sdale511/race-tracker/hardware/esp32-rover-carrier/README.md

# ESP32 rover carrier board (rev C)

A 134 × 53.34 mm, 2-layer motherboard for the ESP32 rover, laid out to fit the enclosure (the 2026-11-07 handoff).

Plugged into female sockets:
- **ArduSimple simpleRTK2B Budget (J1–J4):** XBee in its own socket, ZED UART2 off (`--role rover`), switch down.
- **Feather ESP32-S3 Reverse TFT (J5, J6):** on 8.5 mm stacking headers, display side up, USB-C at the front edge.

Soldered low on their own male headers, because there isn't height for sockets:
- **Adafruit LIS3DH (J8, J9)** and **Pololu S9V11F5 (J10):** under the ArduSimple, which leaves about 9.5 mm.
- **Adafruit bq24074 charger (J7), optional:** on 8.5 mm sockets its BATT and SYSOUT JSTs would hit the XBee's antenna plug.

The battery connects through a JST-PH socket on the back edge (J11), its plug facing the back wall.

The case for it is in [../esp32-rover-enclosure](../esp32-rover-enclosure), built from this board's `tools/layout.py`.

Everything is through-hole and hand-solderable. It replaces the loose wiring in
[docs/esp32-rover-wiring.pdf](../../docs/esp32-rover-wiring.pdf) and the harness in
[docs/esp32-rover-harness.pdf](../../docs/esp32-rover-harness.pdf).

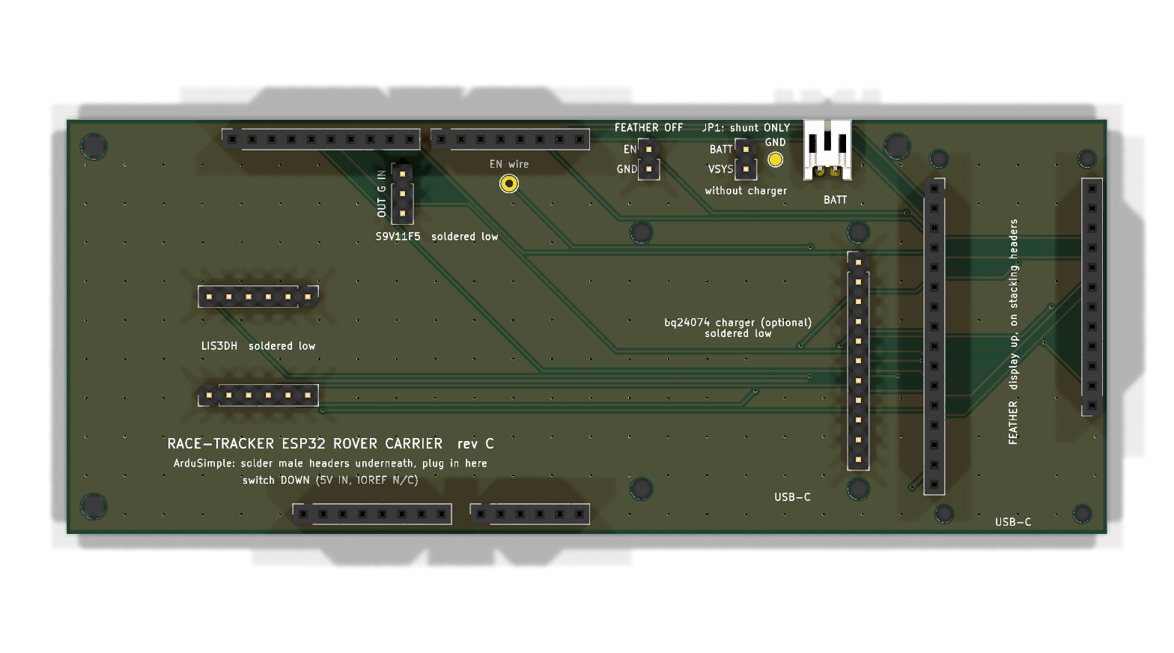
[picture p1: hardware/esp32-rover-carrier/fab/esp32-rover-carrier-top.png]
top


From left to right: the ArduSimple (with the LIS3DH and the regulator under it), then the charger, then the Feather on
its own at the right end. The XBee's RP-SMA overhangs the ArduSimple's right edge, over the charger. Nothing sits above
the Feather's display, so the enclosure can have a window over it.

Rev C against rev B, for the enclosure:

- **12.5 mm shorter** (146.5 → 134 mm): the LIS3DH moved under the ArduSimple.
- **The regulator moved under the ArduSimple**, out of the charger's way.
- **The charger is soldered low and sits 3.22 mm back from the front edge**, so its DC jack stays inside the case's
  front wall. Only the two USB-C faces reach the front edge.
- **The battery JST moved to the back edge**, plug facing the back wall; JP1, TP1 and J12 moved behind the charger.
- **H3 sits between the charger and the Feather** with no screw: a post on the lid presses it down, so keep a 5 mm
  column above it clear. H1 and H2 screw to floor posts. H16 is gone: the case's fourth lid-screw boss sits in that
  front corner.

Rev B against rev A: the Feather moved to the far right, the bq24074 turned so its USB-C faces the front edge, and the
optional connections were added.

## Files

| File | What it is |
|---|---|
| `esp32-rover-carrier.kicad_pro` / `.kicad_sch` / `.kicad_pcb` | KiCad 10 project |
| `fab/esp32-rover-carrier-gerbers.zip` | Gerbers and drill files, ready to upload to JLCPCB |
| `fab/esp32-rover-carrier-schematic.pdf`, `fab/esp32-rover-carrier-board.pdf` | For review |
| `fab/bom.csv` | Parts list |
| `tools/layout.py` | Module positions and the netlist: the one place to change |
| `tools/gen_sch.py`, `tools/gen_pcb.py` | Regenerate the schematic and the routed board from `layout.py` |

To regenerate after a change to `layout.py`:

```bash
python3 tools/gen_sch.py && ~/Applications/KiCad/KiCad.app/Contents/Frameworks/Python.framework/Versions/Current/bin/python3 tools/gen_pcb.py
```

`gen_pcb.py` places the footprints, routes every net with its own grid router, adds GND stitching vias and pours ground on
both layers. Check the result with:

```bash
~/Applications/KiCad/KiCad.app/Contents/MacOS/kicad-cli pcb drc --schematic-parity esp32-rover-carrier.kicad_pcb
```

Rev C results: 0 violations, 0 unconnected items, 0 schematic-parity issues. The only warnings say that KiCad's library
tables aren't set up on this machine, and that the battery JST's outline meets the back edge (on purpose).

## Connections

| Net | Joins |
|---|---|
| GPS_TX | ArduSimple D0 (TX1) → Feather RX (GPIO 38) |
| GPS_RX | Feather TX (GPIO 39) → ArduSimple D1 (RX1) |
| XB_DOUT | ArduSimple D2 (XBEE TX / GPS RX2) → Feather D5 |
| XB_DIN | Feather D6 → ArduSimple D8 (XBEE RX / GPS TX2) |
| 3V3 | Feather 3V (both pins) → ArduSimple IOREF |
| 5V | S9V11F5 VOUT → ArduSimple 5V IN/OUT |
| VSYS | Feather BAT, S9V11F5 VIN, LIS3DH VIN, bq24074 OUT, JP1 pin 2 |
| BATT | Battery JST +, bq24074 VLIPO, JP1 pin 1 |
| SCL, SDA | Feather SCL/SDA ↔ LIS3DH SCL/SDA |
| ACC_INT | LIS3DH INT1 → Feather D10 |
| CHG_N, PGOOD_N | bq24074 ~CHG → Feather D11, ~PGOOD → Feather D12 (open drain; the firmware doesn't read them yet) |
| GND | Everything, plus both copper pours |

The firmware pins are unchanged (`feather_s3_reversetft_socket` build).

### Optional connections

These are wired but not used by the firmware yet, except `GPS_POWER_PIN`, which already exists as a build flag.
[OPTIONAL-CONNECTIONS.md](OPTIONAL-CONNECTIONS.md) explains what each one gives and what it would take to use it.

| Net | Joins | Use |
|---|---|---|
| GPS_EN | Feather A0 (GPIO 18) → pad TP2 | Wire TP2 to the S9V11F5's EN pad, then build with `-DGPS_POWER_PIN=18`. Deep sleep then cuts the ArduSimple and the XBee (about 20–50 mA saved overnight). The GPS loses its almanac unless V_BCKP is supplied, so expect slower fixes after a sleep. |
| GPS_PPS | ArduSimple D13 (TIMEPULSE) → Feather A1 (GPIO 17) | The ZED's 1 PPS edge, for exact timing |
| GPS_EXTINT | Feather A2 (GPIO 16) → ArduSimple D12 (EXTINT) | A hardware wake or time mark for the ZED |
| CHG_DIS | Feather A3 (GPIO 15) → bq24074 ~CE | High stops charging. The bq's 10 kΩ pull-down keeps charging on while the pin floats. |
| ACC_INT2 | LIS3DH INT2 → Feather A4 (GPIO 14) | A second accelerometer interrupt. It's an RTC GPIO, so it can wake the board. |
| FEATHER_EN | Feather EN → J12 pin 1 (pin 2 GND) | Short J12 to switch the Feather off. The regulator and ArduSimple stay on battery power. For a true off switch without a charger, put the switch on JP1 instead of the shunt. |

Feather D9, D13, A5, SCK, MOSI and MISO are still free. The ZED's I2C isn't wired.

There are two differences from the hand wiring:

- **The LIS3DH runs from VSYS, not the Feather's 3V.** The breakout has its own 3.3 V regulator. This shortens the wiring,
  and VSYS stays on in deep sleep, so motion wake still works.
- **The S9V11F5 has no EN pin.** It has only VIN, GND and VOUT; its enable is a small solder pad on the module (Pololu's drawing shows only the three holes). That's why
  GPS_EN goes to a wire pad (TP2) rather than to the socket.

## Battery and charger: JP1

- **No bq24074 fitted:** put the shunt on JP1. The battery feeds VSYS directly, as it does now.
- **bq24074 fitted:** remove the shunt. The battery feeds the charger, and the charger's OUT feeds VSYS. Charge it through
  the bq24074's USB-C on the front edge.

Never fit both. With both in place, the shunt bypasses the charger's battery control. JP1 sits behind the charger, on
the back edge beside the battery JST. The charger's own BATT and SYSOUT JSTs stay empty: the battery and VSYS go
through its 11-pin header (VLIPO pin 2, OUT pin 4).

## Check before ordering

1. **Print the board at 100 % and press the modules' pins into the paper.**
   - Print `fab/esp32-rover-carrier-fitcheck.pdf` at 100 % ("Actual size"). It shows the outlines, pads and real drill
     holes with no copper pour. The board outline should measure 134 × 53.34 mm.
   - The ArduSimple's header pattern is the Arduino Uno R3 layout. I measured it against ArduSimple's pinout image, not a
     drawing.
   - The Feather, LIS3DH and bq24074 positions come from Adafruit's own board files.
2. **Check the S9V11F5 pin order on your module.** The board expects VIN, GND (square pad), VOUT. VOUT is the pin the
   "VOUT→" arrow on the module points to.
3. **Check that your LIS3DH matches the 2809 pinout:**
   - The VIN, 3Vo, GND, SCL, SDA, INT1 row is 0.5" from the CS, SDO, ADC1–3, INT2 row.
   - The board is 0.7 × 1.0".
4. **Check clearance under the ArduSimple.** The case expects about 9.5 mm between the carrier and the ArduSimple's
   underside. Under it are the LIS3DH and the S9V11F5, each soldered on a 2.5 mm header (about 5 mm tall in all), plus
   the heads of two M3 case screws (H1, H2). Fit those screws before the ArduSimple goes on.
5. **Check that the charger stays under the XBee's antenna plug.** Soldered low, its JST bodies top out about 10 mm
   above the carrier; the case puts the plug about 14 mm up. These heights are the enclosure's estimates.

## Assembly

1. If you want the GPS power cut, solder the EN wire to the S9V11F5's EN pad first (see OPTIONAL-CONNECTIONS.md).
2. Solder male headers pins-down onto the LIS3DH (both rows), the bq24074 (the 11-pin edge) and the S9V11F5, and
   solder each module straight into the carrier, its header's plastic flat on the board. Fit the charger's four M2.5
   standoffs (2.5 mm, H4–H7) first: it hangs off one header row.
3. Solder the female sockets onto the carrier (8.5 mm tall) for the ArduSimple and the Feather, then the JST, JP1 and
   (optional) J12. Solder male headers pins-down onto the ArduSimple: 10 + 8 on the top edge, 8 + 6 on the bottom edge.
4. Solder 8.5 mm stacking headers (a 1x16 and a 1x12) to the Feather instead of its male headers. The housings go on
   the display side, along both long edges, and the long tails come out underneath.
5. Plug in the modules. The Feather's tails go into J5 and J6, display up, with USB-C at the front edge.
   - The Feather sits higher than the other modules: the carrier socket, plus the length of tail left showing.
   - Measure that height before cutting standoffs for the optional M2 hold-downs (H12–H15).
   - Check that the stacking housings line up with the lid window, as the case expects.

## Ordering (JLCPCB)

Upload `fab/esp32-rover-carrier-gerbers.zip` with these settings:

- 2 layers, 1.6 mm FR-4, 1 oz copper.
- HASL finish.
- Any solder mask colour.
- Size 134 × 53.34 mm.

Every track and clearance is at least 0.2 mm, well inside the standard process.

### Having JLCPCB solder the connectors

JLCPCB can fit the parts that go on the carrier itself: the six female sockets (J1–J6), the battery JST (J11) and the
two 2-pin headers (JP1, J12). That's 66 joints. You then solder only the charger, LIS3DH and S9V11F5 (soldered low,
J7–J10), plus the headers on the ArduSimple and the Feather.

1. Turn on **PCB Assembly** and pick **Standard** (Economic doesn't do through-hole). Assemble the **top side**.
2. Upload `fab/jlcpcb/bom.csv` and `fab/jlcpcb/cpl.csv`.
3. Check the parts it matches against this list (all were in stock on 2026-11-07):

   | Ref | Part | LCSC |
   |---|---|---|
   | J1 | Female header 1x10, 8.5 mm (Kinghelm KH-2.54FH-1X10P-H8.5) | C2905418 |
   | J2, J3 | Female header 1x08, 8.5 mm (KH-2.54FH-1X8P-H8.5) | C2905417 |
   | J4 | Female header 1x06, 8.5 mm (KH-2.54FH-1X6P-H8.5) | C2905416 |
   | J5 | Female header 1x16, 8.5 mm (KH-2.54FH-1X16P-H8.5) | C2905421 |
   | J6 | Female header 1x12, 8.5 mm (KH-2.54FH-1X12P-H8.5) | C2905419 |
   | J11 | JST S2B-PH-K-S, right angle | C173752 |
   | JP1, J12 | Male header 1x02, 2.54 mm | C32713268 |

4. **In the placement preview, check the battery JST (J11)**: its opening must face the board's **back edge** (away
   from the USB-C side), next to the "BATT" label. If it shows facing inwards, rotate it 180° there. The sockets and
   headers are symmetrical, so their rotation doesn't matter.
5. J7–J10, TP1, TP2 and the holes aren't in the files: they stay empty for you. The JP1 shunt isn't fitted; add one
   only if there's no charger.

To regenerate the two files after a board change, run
`~/Applications/KiCad/KiCad.app/Contents/Frameworks/Python.framework/Versions/Current/bin/python3 tools/gen_jlc.py`.
Positions are each part's pad centre, in the same coordinates as the Gerbers.
