sdale511/race-tracker/hardware/esp32-rover-carrier/fab/esp32-rover-carrier-schematic.pdf

1 | 2 | 3 | 4 | 5 | 6 | 7 | 8
1 | 2 | 3 | 4 | 5 | 6 | 7 | 8

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
Size: A3 | Rev: C | F Date:
KiCad E.D.A. 10.0.8 | Id: 1/1

### Title: ESP32 rover carrier

File: esp32-rover-carrier.kicad_sch

Sheet: /

race-tracker

Feather S3 Reverse TFT, ArduSimple Budget, LIS3DH, S9V11F5, optional bq24074

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
ArduSimple SCL..D8

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
bq24074 (soldered) | 1
| 2

J11 Battery JST-PH

1
2
3
4
5
6

J8

LIS3DH (soldered) 1

2
3
4
5
6

J9

LIS3DH (soldered, support) 1

2
3

J10

S9V11F5 (soldered)

1
2

JP1 Charger bypass: shunt only without bq24074

# TP1 GND

TP2 GPS_EN wire to S9V11F5 EN

1
2
3
4
5
6

J4

ArduSimple A0..A5

1
2

J12

Feather off: short EN to GND

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
ArduSimple power

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
Feather left 1
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
ArduSimple D7..D0

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
Feather right | BATT FEATHER_EN

VSYS CHG_N

XB_DIN | BATT GND

PGOOD_N

GND
SCL FEATHER_EN

VSYS

3V3

3V3 GND

GPS_EN

XB_DIN

# SDA CHG_DIS PGOOD_N

XB_DOUT GPS_RX GPS_TX | GND

GPS_PPS

3V3 | GPS_EXTINT CHG_DIS

ACC_INT2

XB_DOUT | ACC_INT CHG_N

VSYS GND

BATT SCL 5V GND

GND

VSYS GND

ACC_INT2

GPS_TX GPS_RX

VSYS GND

5V

ACC_INT | GND

GND

SDA | GPS_EN

GPS_EXTINT

GND

GPS_PPS | -

SDA

VSYS D7 | +

RX/GPIO38

TX/GPIO39

### SCL VIN

3Vo GND

VBUS GND

THERM

CS

ISET

INT2

SDO

ADC1

ADC2

ADC3

~CE

~PGOOD

~CHG OUT GND

VOUT

VLIPO

VIN

GND

GND J12: short EN to GND to switch the Feather off (the regulator and ArduSimple stay on battery power).

GPS_EN: Feather A0 to pad TP2; wire TP2 to the S9V11F5 EN pad. Build with -DGPS_POWER_PIN=18 to cut the GPS and XBee in deep sleep.

SDA
INT1 Optional, unused by the firmware so far: TIMEPULSE -> A1, EXTINT <- A2, bq ~CE <- A3 (high stops charging; 10k pull-down on the bq), LIS3DH INT2 -> A4.

Feather on 8.5 mm stacking headers (housings on the display side), tails into J5/J6; display up, USB-C at the front. LIS3DH runs from VSYS (its own 3.3 V regulator).

The ArduSimple and the Feather plug into sockets; the LIS3DH, S9V11F5 and bq24074 are soldered low on their own headers. Nets join by label name. | GND ~CHG and ~PGOOD are open drain to Feather D11 / D12 (read with INPUT_PULLUP); the firmware does not use them yet.

No bq24074 -> fit the JP1 shunt (BATT to VSYS). Never both: the shunt would bypass the charger.

bq24074 optional: fitted -> JP1 open, battery feeds the charger, charger OUT feeds VSYS.

EN ArduSimple: male headers soldered underneath; power switch DOWN (5V IN, IOREF N/C); --role rover (UART2 off). A4

## TXD0 MISO MOSI SCK

A5

A3

A2

A1

# A0/WT GND

GND

A5/GPIO8

A4/GPIO14

A3/GPIO15

A2/GPIO16

A1/GPIO17

A0/GPIO18 RST GND

3V3V

VIN

5V_IN/OUT 3V3 RESET

IOREF NC

D1/RX1 D2/XBEE_TX D3D4 | BAT EN

USB

D13 D12 D5D6D0/TX1

SDA SCL | D9D11 D10

AREF GND

D9D10 D8/XBEE_RX D11/GEOFENCE D12/EXTINT D13/TPS | D6D5
SCL | BATT
