sdale511/race-tracker/data/IMG_1962 Medium.jpeg

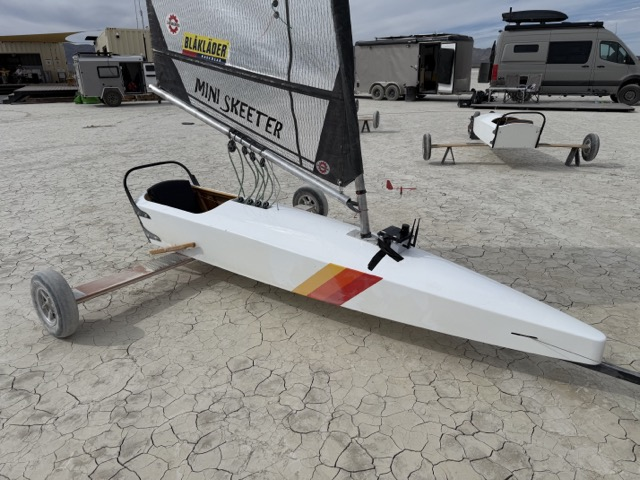
data/IMG_1962 Medium.jpeg
