sdale511/race-tracker/hardware/esp32-rover-carrier/fab/bom.csv

Ref | Qty | Part | Notes
J1 | 1 | Female header 1x10, 2.54 mm, 8.5 mm tall | ArduSimple SCL..D8 (Uno R3 pattern)
J2,J3 | 2 | Female header 1x08, 2.54 mm, 8.5 mm tall | ArduSimple D7..D0, power header
J4 | 1 | Female header 1x06, 2.54 mm, 8.5 mm tall | ArduSimple A0..A5
J5 | 1 | Female header 1x16, 2.54 mm, 8.5 mm tall | Feather left row
J6 | 1 | Female header 1x12, 2.54 mm, 8.5 mm tall | Feather right row
J11 | 1 | JST S2B-PH-K-S (PH 2.0 mm, right angle, through hole) | Battery on the back edge; pin 1 GND | pin 2 + (same as the Feather's)
JP1 | 1 | Male header 1x02, 2.54 mm + 2.54 mm shunt | Shunt ONLY when no bq24074 is fitted
J12 | 1 | Male header 1x02, 2.54 mm (optional) | Feather off: EN and GND; a switch or a shunt shorts them
TP2 | 1 | Thin insulated wire, about 30 mm (optional) | From pad TP2 to the S9V11F5's EN pad; with -DGPS_POWER_PIN=18
H1,H2 | 2 | M3 x 8 self-tapping screw | Carrier to the case's floor posts; H3 has no screw: a lid post presses it down
H4-H7 | 4 | M2.5 standoff, 2.5 mm + screw | bq24074 hold-downs (it hangs off one header row)
H12-H15 | 4 | M2 standoff + screw (optional) | Feather hold-downs; measure the Feather's height on its stacking headers first
- | 1 | Male header 1x10, 2x 1x08, 1x06, 2.54 mm | Soldered underneath the ArduSimple, pins down
J7,J8,J9,J10 | 1 | Male header 1x11, 2x 1x06, 1x03 | Soldered to the bq24074, LIS3DH and S9V11F5, pins down, then straight into the carrier (no sockets)
- | 1 | Stacking headers 1x16 + 1x12, 2.54 mm, 8.5 mm housing (Adafruit 2830 or similar) | Soldered to the Feather: housings on the display side, tails into J5/J6
Module | 1 | Adafruit ESP32-S3 Reverse TFT Feather (5691) | Its own male headers aren't used
Module | 1 | ArduSimple simpleRTK2B Budget | XBee in its own socket; switch DOWN; --role rover
Module | 1 | Adafruit LIS3DH breakout (2809)
Module | 1 | Pololu S9V11F5 (2836)
Module | 1 | Adafruit bq24074 charger (4755) | Optional
PCB | 1 | 134 x 53.34 mm, 2 layers, 1.6 mm FR4, 1 oz, HASL | fab/esp32-rover-carrier-gerbers.zip
