sdale511/race-tracker/hardware/esp32-rover-enclosure/cad/AS-RTK2B-F9P-L1L2-NH-03-R00.step

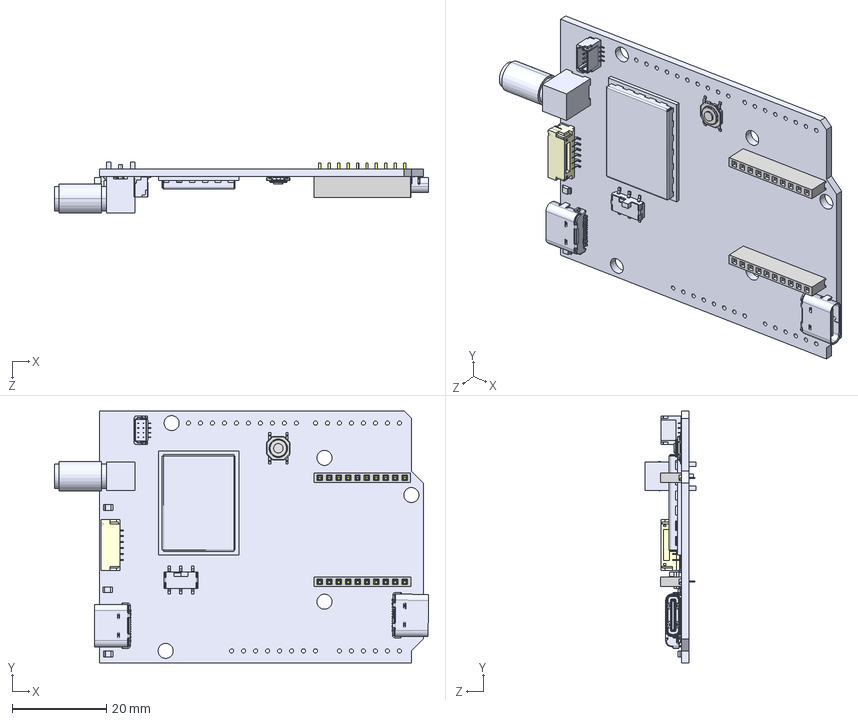
[picture p10: CAD file, 2026-11-07]
hardware/esp32-rover-enclosure/cad/AS-RTK2B-F9P-L1L2-NH-03-R00.step
79.2 x 53.3 x 10.9 mm
pcb
0805_LED_7012X1--3DModel-STEP-1.step x 3
AYZ0202AGRLC--3DModel-STEP-56544.step
BM04B-SRSS-TB-LF--SN---3DModel-STEP-56544.step
C-63-01-10-SV.stp x 2
MMS-110-01-SV_socket.stp x 2
SM06B-GHS-TB(LF)(SN)--3DModel-STEP-56544.step
SMA-long-thread.step
SMD_SWITCH_TL3342F160QG--3DModel-STEP-520916.step
USB4105.STEP x 2
ZED-F9P-00B-02--3DModel-STEP-56544.step
