sdale511/race-tracker/hardware/esp32-rover-enclosure/print/rover_case_base.stl

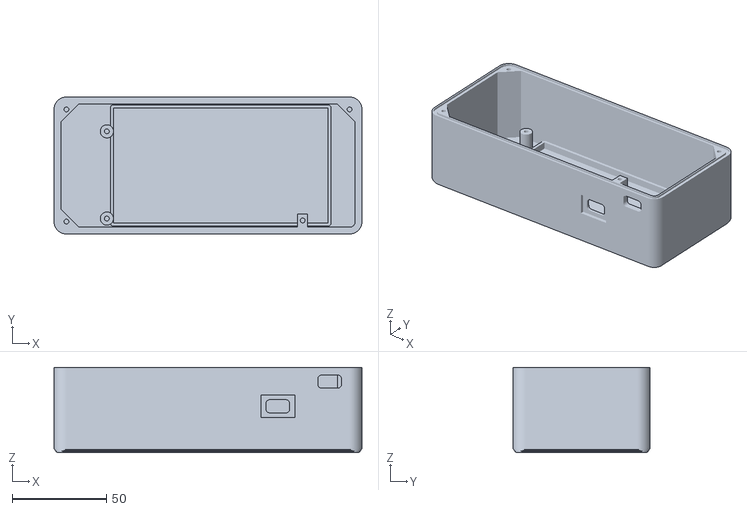
[picture p11: CAD file, 2026-11-07]
hardware/esp32-rover-enclosure/print/rover_case_base.stl
163.7 x 72.8 x 45.4
