sdale511/race-tracker/hardware/esp32-rover-enclosure/print/TPU_usbc_dust_plug.stl

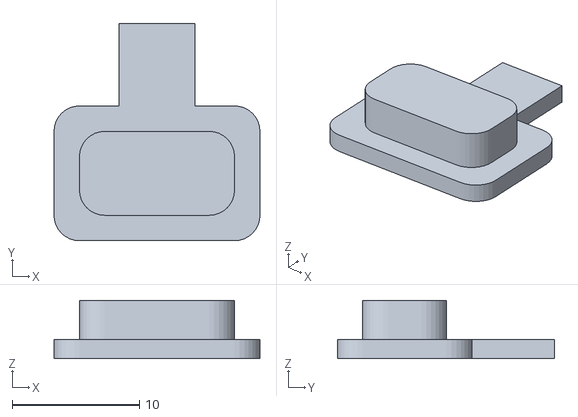
[picture p12: CAD file, 2026-11-07]
hardware/esp32-rover-enclosure/print/TPU_usbc_dust_plug.stl
16.2 x 17.1 x 4.60
