sdale511/race-tracker/hardware/esp32-rover-enclosure/print/TPU_rover_keypad.stl

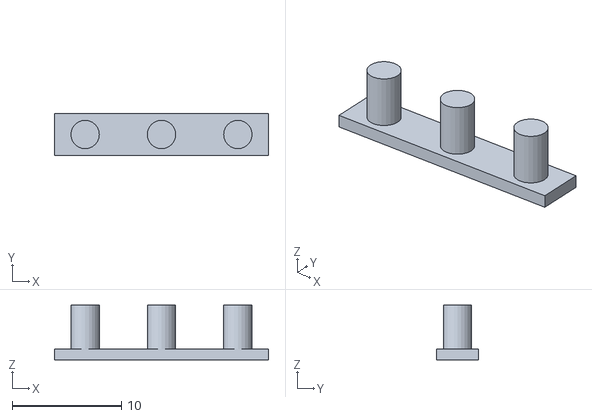
[picture p13: CAD file, 2026-11-07]
hardware/esp32-rover-enclosure/print/TPU_rover_keypad.stl
19.6 x 3.80 x 5.03
