sdale511/race-tracker/data/range-test-image.png

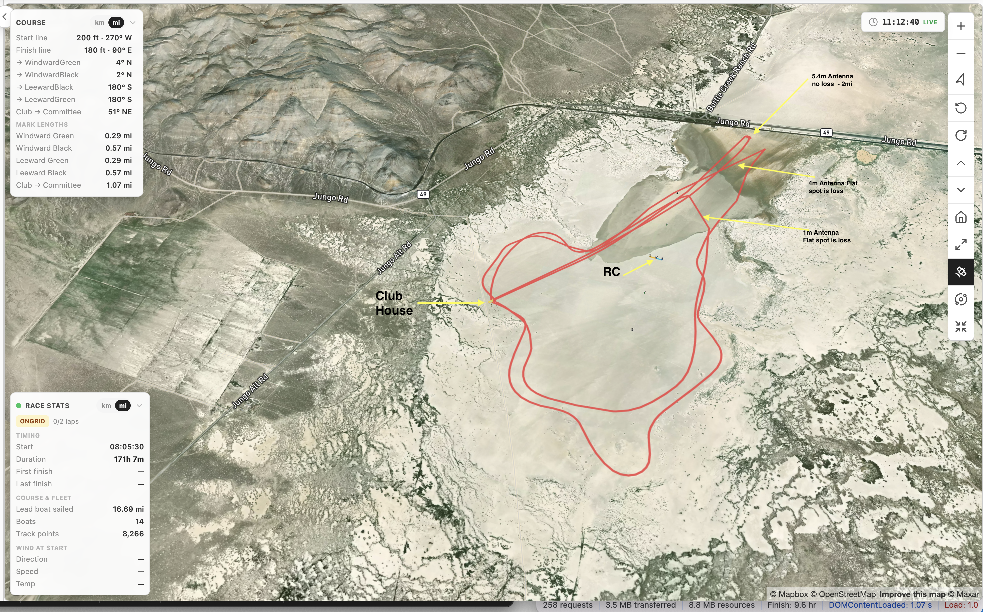
data/range-test-image.png
