sdale511/race-tracker/hardware/esp32-rover-carrier/fab/esp32-rover-carrier-board.pdf

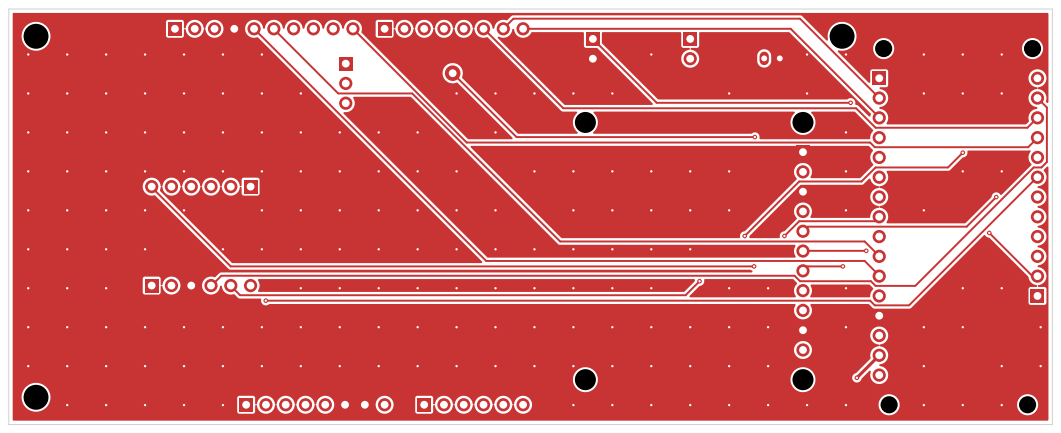
[picture p17: page 1]

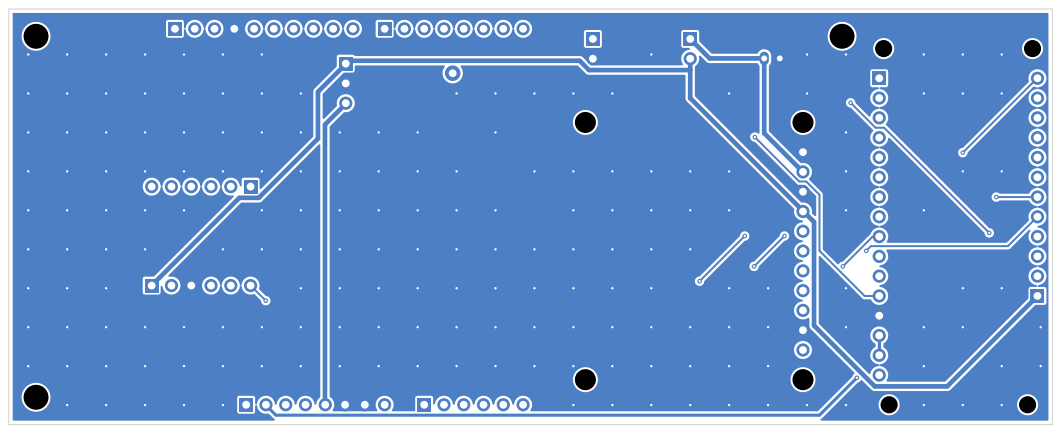
[picture p18: page 2]

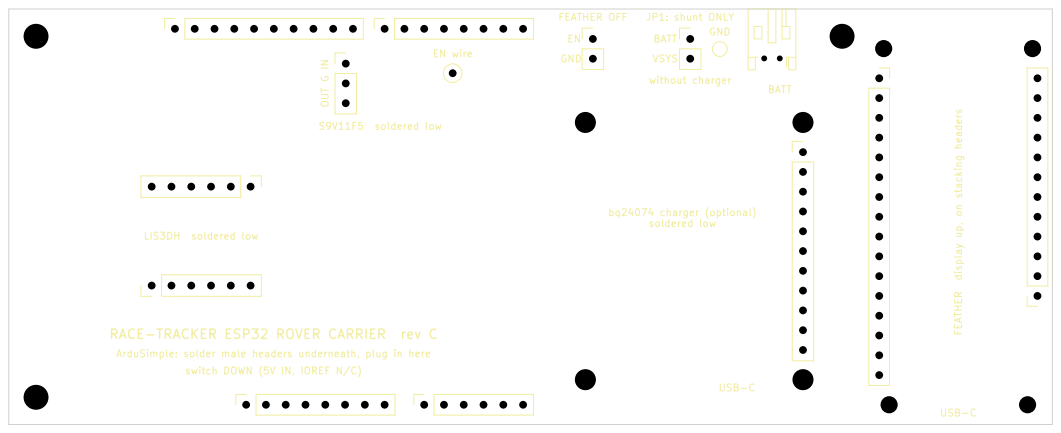
[picture p19: page 3]

JP1: shunt ONLY without charger GNDUSB-C

switch DOWN (5V IN, IOREF N/C) S9V11F5 soldered low

bq24074 charger (optional) soldered low

RACE-TRACKER ESP32 ROVER CARRIER rev C
ArduSimple: solder male headers underneath, plug in here

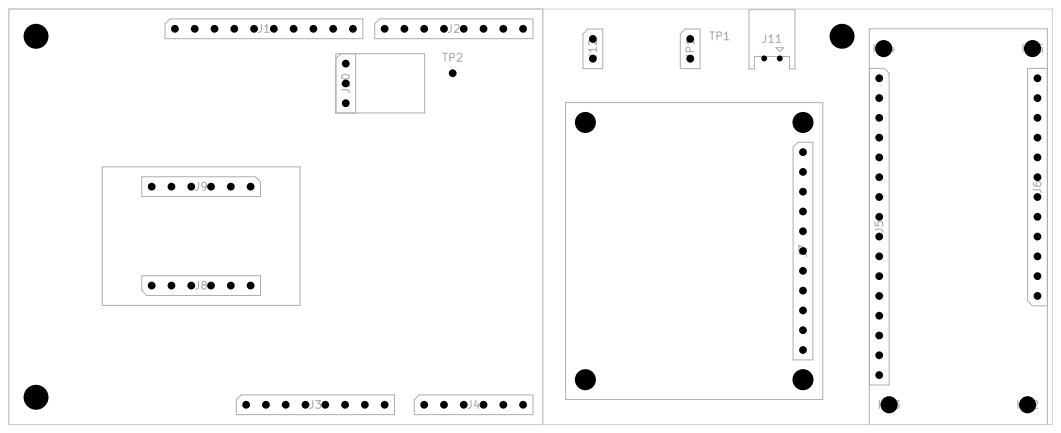
[picture p20: page 4]
