sdale511/race-tracker/hardware/esp32-rover-carrier/fab/esp32-rover-carrier-fitcheck.pdf

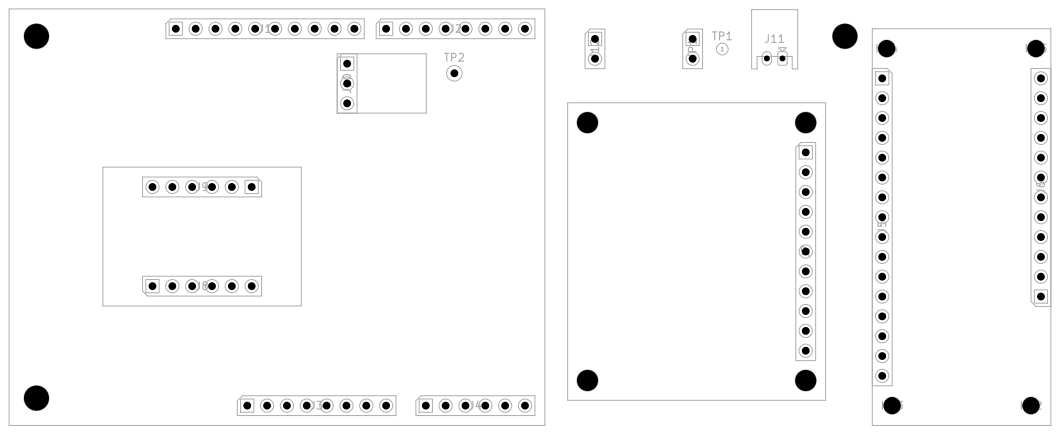
[picture p21: page 1]
