sdale511/race-tracker/hardware/esp32-rover-carrier/esp32-rover-carrier.kicad_pcb

## KiCad design hardware/esp32-rover-carrier/esp32-rover-carrier.kicad_pcb (2026-11-07)

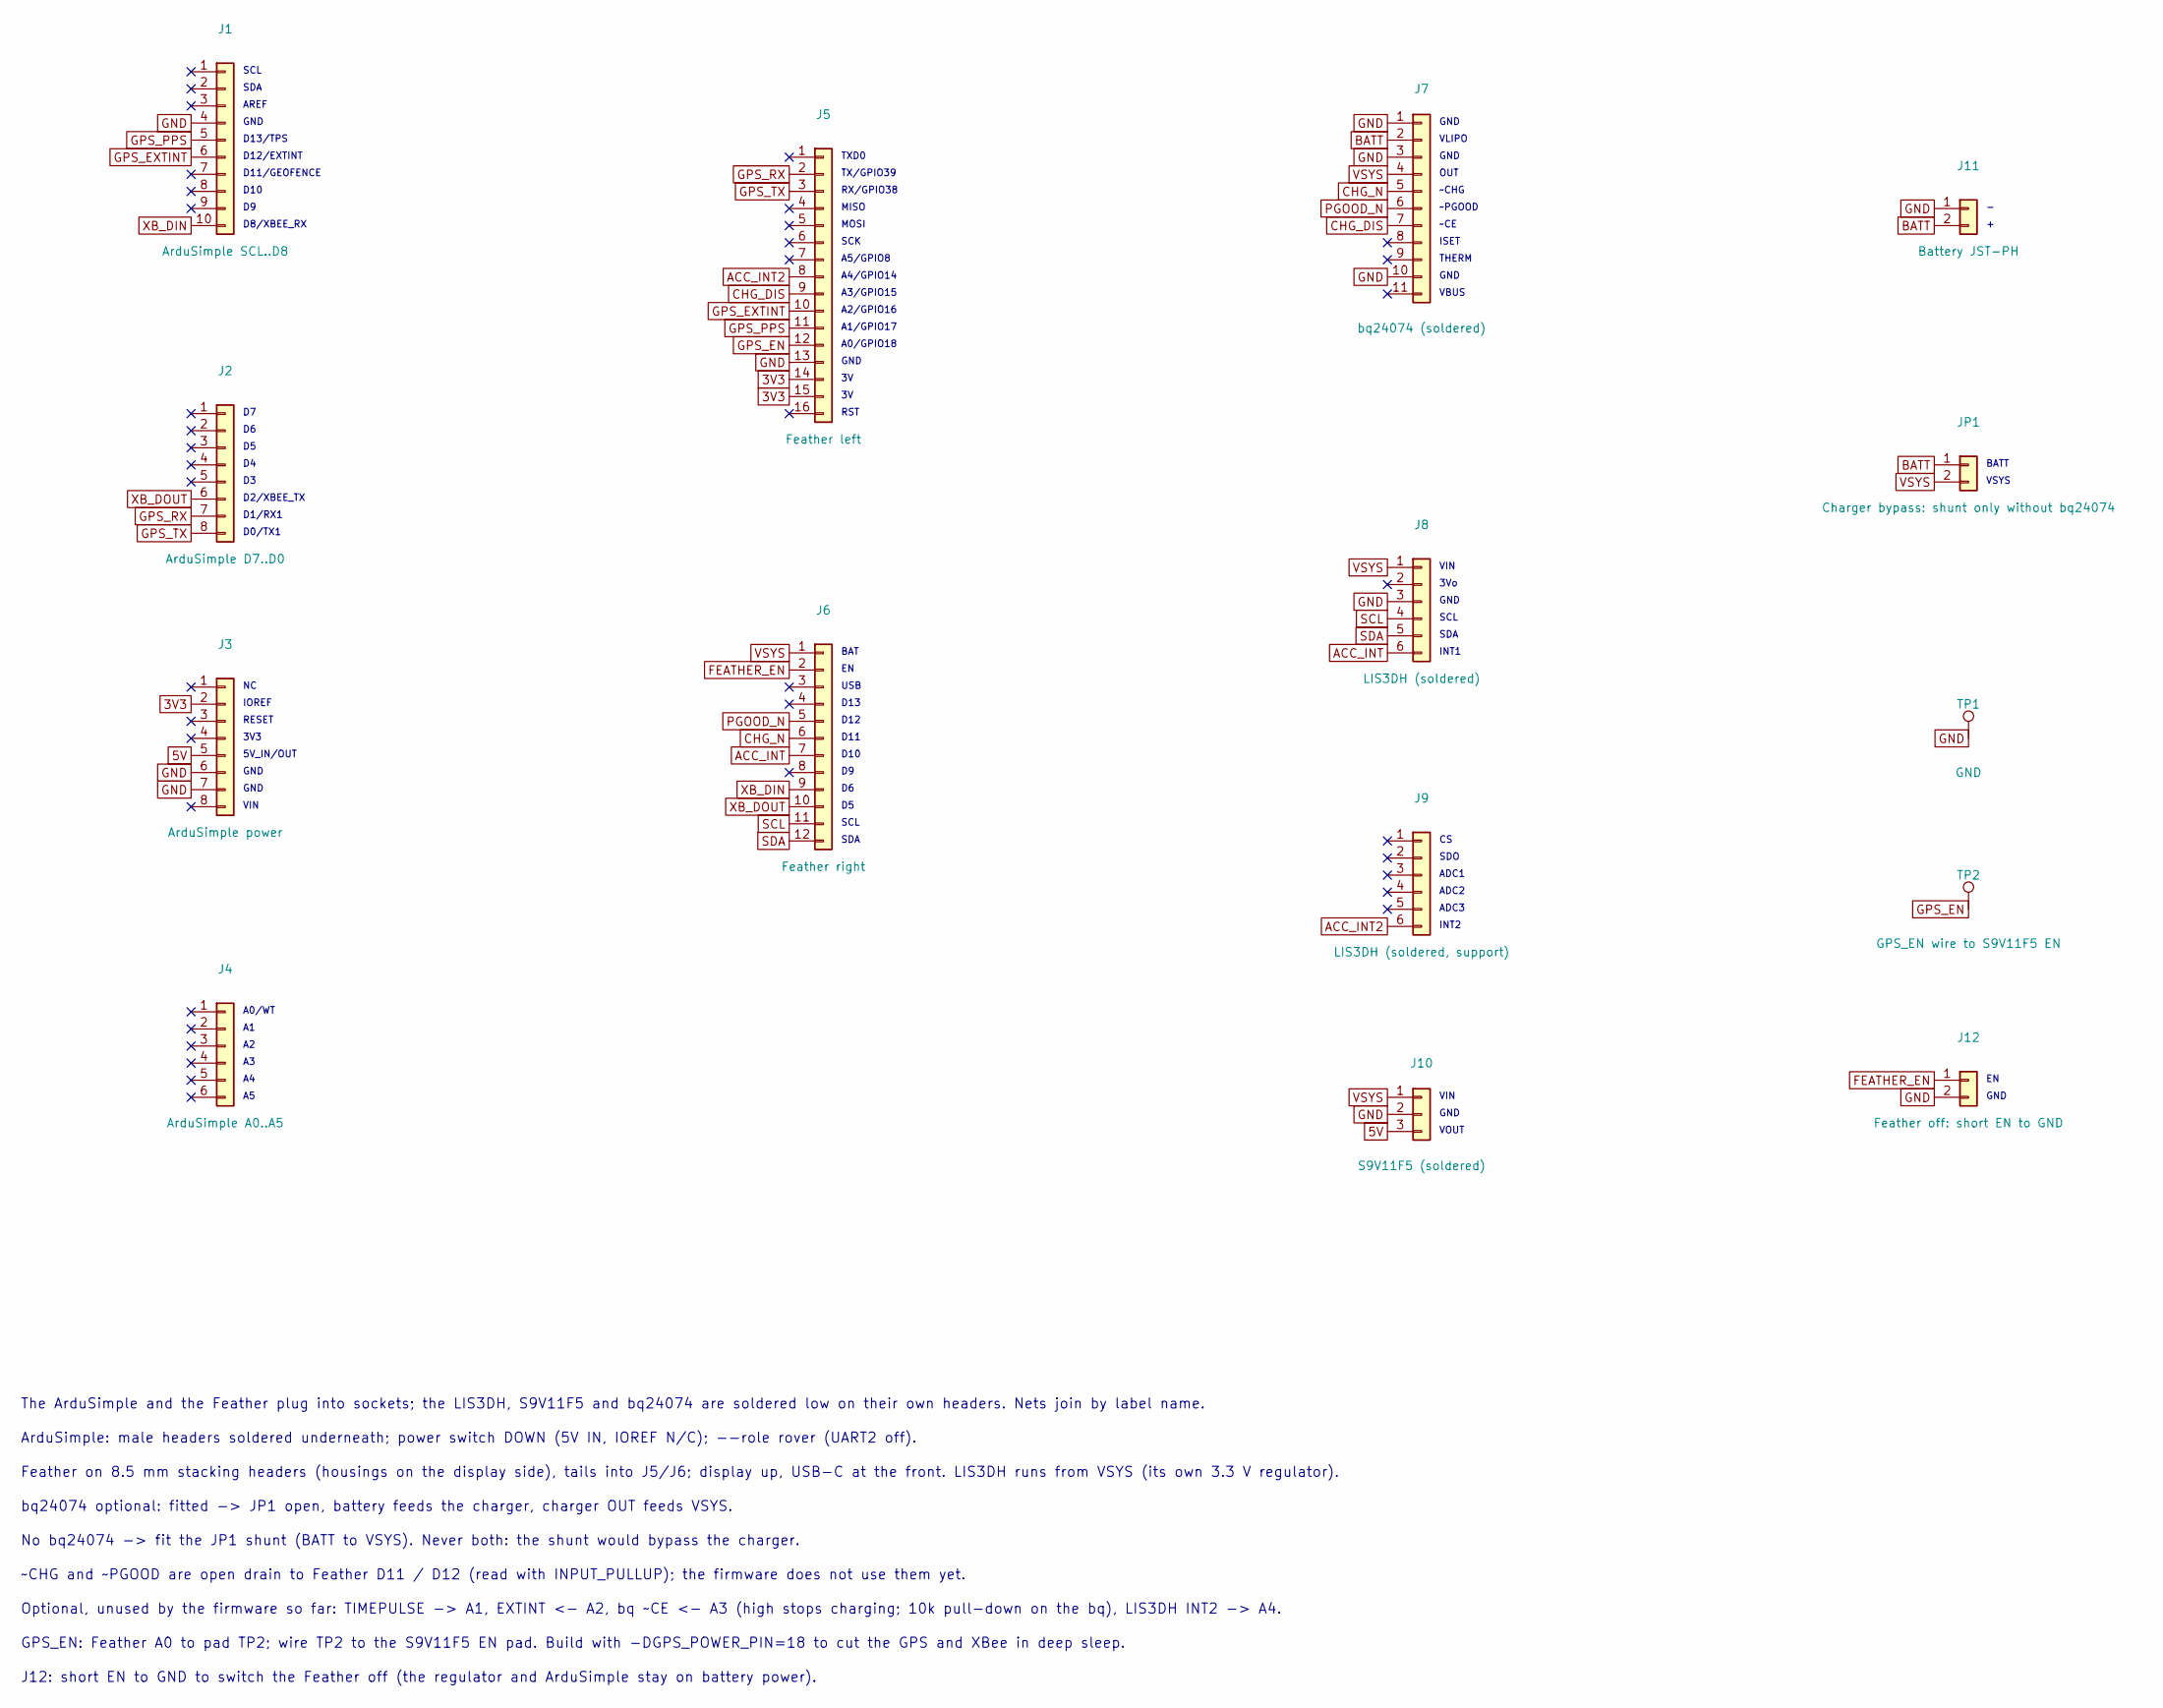
[picture p22: schematic esp32-rover-carrier.kicad_sch, ESP32 rover carrier]

Parts:
J1: ArduSimple SCL..D8; PinSocket_1x10_P2.54mm_Vertical
J2: ArduSimple D7..D0; PinSocket_1x08_P2.54mm_Vertical
J3: ArduSimple power; PinSocket_1x08_P2.54mm_Vertical
J4: ArduSimple A0..A5; PinSocket_1x06_P2.54mm_Vertical
J5: Feather left; PinSocket_1x16_P2.54mm_Vertical
J6: Feather right; PinSocket_1x12_P2.54mm_Vertical
J7: bq24074 (soldered); PinHeader_1x11_P2.54mm_Vertical
J8: LIS3DH (soldered); PinHeader_1x06_P2.54mm_Vertical
J9: LIS3DH (soldered, support); PinHeader_1x06_P2.54mm_Vertical
J10: S9V11F5 (soldered); PinHeader_1x03_P2.54mm_Vertical
J11: Battery JST-PH; JST_PH_S2B-PH-K_1x02_P2.00mm_Horizontal
J12: Feather off: short EN to GND; PinHeader_1x02_P2.54mm_Vertical
JP1: Charger bypass: shunt only without bq24074; PinHeader_1x02_P2.54mm_Vertical
TP1: GND; TestPoint_Pad_D1.5mm
TP2: GPS_EN wire to S9V11F5 EN; TestPoint_THTPad_D2.0mm_Drill1.0mm

Connections:
3V3: J3.2, J5.14, J5.15
5V: J3.5, J10.3
ACC_INT: J6.7, J8.6
ACC_INT2: J5.8, J9.6
BATT: J7.2, J11.2, JP1.1
CHG_DIS: J5.9, J7.7
CHG_N: J6.6, J7.5
FEATHER_EN: J6.2, J12.1
GND: J1.4, J3.6, J3.7, J5.13, J7.1, J7.3, J7.10, J8.3, J10.2, J11.1, J12.2, TP1.1
GPS_EN: J5.12, TP2.1
GPS_EXTINT: J1.6, J5.10
GPS_PPS: J1.5, J5.11
GPS_RX: J2.7, J5.2
GPS_TX: J2.8, J5.3
PGOOD_N: J6.5, J7.6
SCL: J6.11, J8.4
SDA: J6.12, J8.5
VSYS: J6.1, J7.4, J8.1, J10.1, JP1.2
XB_DIN: J1.10, J6.9
XB_DOUT: J2.6, J6.10

Notes on the sheet:
SCL
SDA
AREF
GND
D13/TPS
D12/EXTINT
D11/GEOFENCE
D10
D8/XBEE_RX
D2/XBEE_TX
D1/RX1
D0/TX1
IOREF
RESET
3V3
5V_IN/OUT
VIN
A0/WT
VLIPO
OUT
~CHG
~PGOOD
~CE
ISET
THERM
VBUS
3Vo
INT1
SDO
ADC1
ADC2
ADC3
INT2
VOUT
TXD0
TX/GPIO39
RX/GPIO38
MISO
MOSI
SCK
A5/GPIO8
A4/GPIO14
A3/GPIO15
A2/GPIO16
A1/GPIO17
A0/GPIO18
RST
BAT
USB
D13
D12
D11
BATT
VSYS
The ArduSimple and the Feather plug into sockets; the LIS3DH, S9V11F5 and bq24074 are soldered low on their own headers. Nets join by label name.
ArduSimple: male headers soldered underneath; power switch DOWN (5V IN, IOREF N/C); --role rover (UART2 off).
Feather on 8.5 mm stacking headers (housings on the display side), tails into J5/J6; display up, USB-C at the front. LIS3DH runs from VSYS (its own 3.3 V regulator).
bq24074 optional: fitted -> JP1 open, battery feeds the charger, charger OUT feeds VSYS.
No bq24074 -> fit the JP1 shunt (BATT to VSYS). Never both: the shunt would bypass the charger.
~CHG and ~PGOOD are open drain to Feather D11 / D12 (read with INPUT_PULLUP); the firmware does not use them yet.
Optional, unused by the firmware so far: TIMEPULSE -> A1, EXTINT <- A2, bq ~CE <- A3 (high stops charging; 10k pull-down on the bq), LIS3DH INT2 -> A4.
GPS_EN: Feather A0 to pad TP2; wire TP2 to the S9V11F5 EN pad. Build with -DGPS_POWER_PIN=18 to cut the GPS and XBee in deep sleep.
J12: short EN to GND to switch the Feather off (the regulator and ArduSimple stay on battery power).

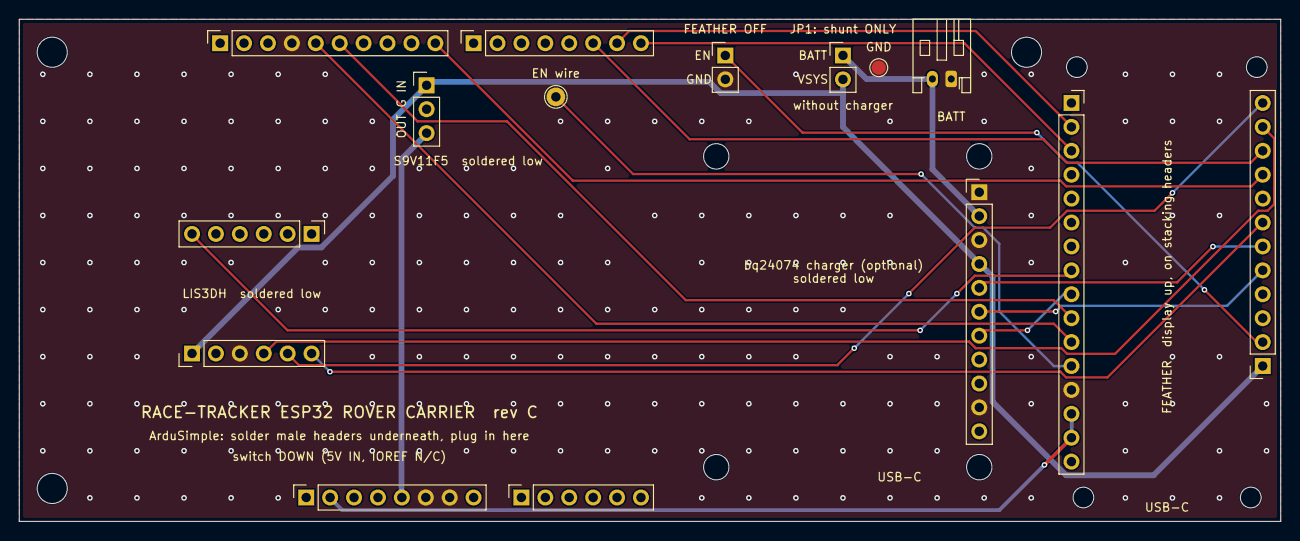
[picture p23: board esp32-rover-carrier.kicad_pcb from above]

Board: 2 copper layers, 134.0 x 53.3 mm, 26 parts (0 on the bottom side), 20 nets.

Other parts of the board:
H1, H2, H3: MountingHole_3.2mm_M3
H4, H5, H6, H7: MountingHole_2.7mm_M2.5
H12, H13, H14, H15: MountingHole_2.2mm_M2
