sdale511/race-tracker/xbee_configure_at.py

#!/usr/bin/env python3
"""
xbee_configure_at.py

Configure a Digi XBee-PRO S3B (900HP / DigiMesh series) radio for this
fleet's telemetry link - delivery mode selectable via --mode (see MODES
below; defaults to Point-to-Multipoint, matching this fleet's actual
one-coordinator/many-end-devices topology). Routing/relaying is disabled
on every node under the two single-hop modes (p2mp, digimesh - this fleet
doesn't need it, no boat ever needs to relay another boat's signal at this
course length) - the third mode, digimesh-routing, exists specifically to
turn that back on, for the uncommon case a course/fleet layout genuinely
needs multi-hop relaying. Same config on every radio in the fleet -
base/committee station and every boat alike, no role-specific settings.
Entirely over AT Command Mode (the plain "+++" / "ATxx" dialect any serial
terminal speaks), the same way you'd do it by hand, just scripted with
read-back verification on every parameter, followed by an actual
soft-reset-and-reverify pass (see "Verifying persistence" in main()) to
confirm every value survives a reboot, not just this session.

Every command name/value below is taken from Digi's own XBee-PRO 900HP/XSC
RF Modules S3 and S3B User Guide (docs.digi.com, document 90002173).

Note on delivery mode (--mode, default p2mp - see MODES below): this
fleet's actual topology is one coordinator (the base) talking to many
end-devices (the boats), which never talk to each other - exactly what
Point-to-Multipoint (P2MP, TO=0x40) is - which is why it's the default.

History worth knowing before assuming P2MP "just works" here: P2MP was
tried as the default once before and found to reproducibly fail on this
exact hardware. The first attempt appeared to produce no traffic at all -
that turned out to be an unrelated bug in this script (a baud-rate write's
response went unchecked after the post-baud-change reconnect, so a radio
whose BD didn't actually survive a reboot still reported success; fixed,
see the reset-and-reverify pass below). Once that was fixed and persistence
was directly confirmed on both radios (every parameter, including TO=0x40
itself, verified to survive an actual reset), traffic STILL failed between
two correctly, persistently P2MP-configured radios that time. DigiMesh
(0xC0, --mode digimesh or digimesh-routing) was the confirmed-working
delivery method as a result, and was this script's default for a while.
If P2MP misbehaves again, that's why - re-verify with --dry-run after a
real reset (not just this session's own memory) before assuming it's
fixed, and fall back to --mode digimesh, which has a real working history
on this hardware. One lead for anyone chasing a P2MP problem: DigiMesh's
own broadcasts already reuse the Directed-Broadcast/Repeater wire format
(0x80), not unique DigiMesh framing - real mesh-routing framing only
applies to unicasts - and this app's traffic is 100% broadcast
(DH=0/DL=0xFFFF), so DigiMesh-with-routing-disabled and P2MP are
functionally the same thing on the wire for this app's own traffic
pattern; a difference between them pointing at TO itself, rather than
something else entirely, would be surprising.

WHY AT COMMAND MODE, NOT THE digi-xbee LIBRARY
    digi-xbee can only talk to a radio already in API mode (AP=1/2) - but
    race-tracker itself needs the radio in AT/transparent mode (AP=0, see
    README's "Radio configuration"), so using it would mean flipping AP
    to 1 by hand first, then back to 0 again afterward before the app
    could talk to the radio again. Speaking AT Command Mode directly
    (plain pyserial, no digi-xbee) avoids that entirely - the radio never
    leaves AT/transparent mode, so there's no mode to flip either way.

WHAT THIS DOES
    - Sets TO (Transmit Options) bits 6:7 and CE (Node Messaging Options,
      bit 1 - routing/relay on this node) according to --mode - see MODES
      below for the exact TO/CE pair each mode sets and why.
    - Sets ID, DH/DL, HP, MT, EE (encryption off), BD to the values below.
    - --role picks the preset: telemetry (default - the boat/base position
      link) or rtcm (the RTK correction link: separate network, MT=1, no
      flow control) - see ROLES below. --network-id/--preamble-id/--mt
      override any single value of either preset.
    - Sets UART flow control (D7 = CTS output, D6 = RTS input) according to
      --flow-control - see FLOW_CONTROL below for what each choice does and
      the one way it can silence a radio.
    - Writes the config to non-volatile memory (so it survives power
      cycling), reads every value back within THIS session to confirm it
      stuck, then does a real soft reset and re-checks everything again
      to confirm it actually survives a reboot (see main()).

BEFORE YOU RUN THIS
    pip install pyserial

    Run once per radio - base/committee station and every rover, all get
    the identical config below. Channel selection (the CM command - a
    64-bit channel mask, not a simple index) isn't touched by this script
    at all; set it by hand first if your network needs to avoid specific
    frequencies (see CM in the user guide).

    Only one process can hold a serial port at a time - stop any running
    `npm run base`/`npm run boat`/`npm run radio-test` (or XCTU, a
    terminal session, etc.) using this same port before running this.

USAGE
    python3 xbee_configure_at.py --port /dev/ttyUSB0                       # P2MP (default) - see MODES below
    python3 xbee_configure_at.py --port /dev/ttyUSB0 --mode digimesh       # DigiMesh, routing/relay OFF
    python3 xbee_configure_at.py --port /dev/ttyUSB0 --mode digimesh-routing  # DigiMesh, routing/relay ON
    python3 xbee_configure_at.py --port /dev/ttyUSB0 --dry-run             # read current config, change nothing
    python3 xbee_configure_at.py --port /dev/ttyUSB0 --flow-control rtscts # CTS + RTS flow control (default: cts)
    python3 xbee_configure_at.py --port /dev/ttyUSB0 --role rtcm           # an XBee-PRO 900HP as the RTK correction radio
    python3 xbee_configure_at.py --port /dev/ttyUSB0 --role rtcm --network-id 0x2A10   # ...on a network ID of your choosing
"""

import argparse
import sys
import time

import serial

# ─── MODES ──────────────────────────────────────────────────────────────
# Delivery mode, selected with --mode (default p2mp) - each entry is the
# TO (Transmit Options bits 6:7, the delivery-method switch)/CE (Node
# Messaging Options bit 1, routing/relay on this node) pair that mode
# needs. See the top-of-file Note for why p2mp is the default despite its
# documented failure history, and when to fall back to digimesh.
MODES = {
    "p2mp": {
        "TRANSMIT_OPTIONS": 0x40,  # Point-to-Multipoint
        # P2MP end-devices don't relay for each other at all - there's no
        # mesh-routing concept in this mode to begin with - so CE's
        # routing-disable bit is set the same as digimesh's own
        # single-hop config below, just for consistency/explicitness
        # rather than because P2MP would otherwise try to relay.
        "CE": 2,
        "label": "Point-to-Multipoint",
    },
    "digimesh": {
        "TRANSMIT_OPTIONS": 0xC0,  # DigiMesh (mesh routing)
        # Routing/relay disabled (bit 1 set) - this fleet is single-hop
        # only, no node should ever act as an intermediate relay for
        # another's traffic. The confirmed-working fallback if p2mp
        # misbehaves - see the top-of-file Note.
        "CE": 2,
        "label": "DigiMesh (routing/relay disabled)",
    },
    "digimesh-routing": {
        "TRANSMIT_OPTIONS": 0xC0,  # DigiMesh (mesh routing)
        # Routing/relay ENABLED (bit 1 clear) - every node will relay
        # other nodes' DigiMesh/broadcast traffic. Not needed at this
        # fleet's actual (single-hop, ~2mi course) range - included for
        # completeness/future-proofing if the course or fleet layout ever
        # genuinely needs multi-hop relaying, not because anything today
        # requires it.
        "CE": 0,
        "label": "DigiMesh (routing/relay enabled)",
    },
}
DEFAULT_MODE = "p2mp"

# UART flow control, selected with --flow-control (default "cts") - the D7
# (DIO7/CTS, pin 12) / D6 (DIO6/RTS, pin 16) pair. Both are about what the
# radio's serial port tells the HOST, and none of it does anything unless the
# host's side is wired and honours it:
#   - CTS (D7=1, also Digi's own factory default) is an OUTPUT: the radio
#     raises it when its serial receive buffer is nearly full, to tell the host
#     to stop sending. Safe to leave on even if the host ignores it - the host
#     just keeps sending and the radio drops what doesn't fit. It only helps
#     once the host (the Pi's / adapter's driver, and race-tracker's own serial
#     port settings) actually obeys it.
#   - RTS (D6=1) is an INPUT: the radio stops sending received data out to the
#     host while RTS is held high. If the host side never drives RTS (a USB
#     adapter with the RTS line unwired or floating), the radio goes SILENT to
#     the host - nothing it receives ever reaches the app. So it is off unless
#     asked for, and only for an adapter whose RTS is known to be wired.
FLOW_CONTROL = {
    "none": {"D7": 0, "D6": 0, "label": "no hardware flow control"},
    "cts": {"D7": 1, "D6": 0, "label": "CTS only (radio tells the host to pause; Digi's factory default)"},
    "rtscts": {"D7": 1, "D6": 1, "label": "CTS + RTS (host can also pause the radio's output)"},
}
DEFAULT_FLOW_CONTROL = "cts"

# Presets for what the radio is FOR, selected with --role (default
# "telemetry"). Everything not listed here (TO/CE from --mode, DH/DL broadcast,
# BD from --target-baud) is the same for both. The two roles differ so that a
# boat's/base's TELEMETRY radio and its RTK-correction radio never form one
# network when both are XBee-PRO 900HPs: different network ID AND different
# preamble ID (HP), because the radios only talk to others whose preamble ID
# matches and whose network ID matches - otherwise the correction radio would
# also hear every telemetry frame (and the telemetry radio every RTCM message).
# Both ends of each link must use the same role/values.
#   telemetry: this fleet's position link - one transmission per broadcast
#              (MT=0, throughput over redundancy), flow control per
#              DEFAULT_FLOW_CONTROL.
#   rtcm:      RTK corrections, one burst a second with no acknowledgements -
#              each broadcast sent twice (MT=1, what the stock ArduSimple long-
#              range radios use), and NO flow control: the ArduSimple board's
#              UART2 it plugs into doesn't use it, and RTS left floating would
#              silence the radio. The network ID 0x1985 is the one the stock
#              ArduSimple pair uses - harmless to reuse, since an XBee SX can't
#              hear a 900HP anyway - and HP=1 keeps it off the telemetry network.
ROLES = {
    "telemetry": {"ID": 0x7FFF, "HP": 0, "MT": 0, "flow": DEFAULT_FLOW_CONTROL,
                  "label": "position telemetry link"},
    "rtcm": {"ID": 0x1985, "HP": 1, "MT": 1, "flow": "none",
             "label": "RTK correction (RTCM) link - separate network, repeat once, no flow control"},
}
DEFAULT_ROLE = "telemetry"
DIO_LABELS = {0: "disabled", 1: "flow control", 3: "digital input", 4: "digital output low", 5: "digital output high"}

# ─── CONFIG ─────────────────────────────────────────────────────────────

CONFIG = {
    # Serial baud the radio will run at going forward. The script
    # connects at --connect-baud (its CURRENT speed) and, if different,
    # switches it to this and reconnects to confirm. Tried bumping this to
    # 230400 after a 100-boat radio-congestion run showed the SERIAL link
    # saturating at ~11.2 KB/s (almost exactly 115200's own 8N1 ceiling,
    # 115200/10 bits-per-byte = 11,520 B/s) - but that just exposed a lower
    # ceiling one level up: at 230400 the same test pushed 15.4 KB/s (well
    # under 230400's own ~23 KB/s ceiling) yet sync errors jumped from 0.2%
    # to 10.4% - real RF-level bit corruption, not local serial buffering.
    # This fleet's XBee-PRO 900HP 200K radios' real sustainable RF
    # throughput tops out around ~11-12 KB/s regardless of serial baud;
    # 115200 was accidentally already throttling right at that ceiling, not
    # artificially limiting it. Don't raise this again without re-running
    # that same congestion test and checking sync-error rate, not just
    # bandwidth headroom.
    "TARGET_BAUD": 115200,        # was 9600 by default

    # Network ID (PAN ID), 0 - 0x7FFF. Coincidentally already the factory
    # default too, but set explicitly so it's never left to chance.
    "NETWORK_ID": "0x7FFF",

    # TRANSMIT_OPTIONS/CE are filled in from MODES[args.mode] at the top of
    # main(), below - not fixed here, since --mode selects between them.
    # Placeholder values only; always overwritten before use.
    "TRANSMIT_OPTIONS": None,
    "CE": None,
    # D7 (CTS)/D6 (RTS) are filled in from FLOW_CONTROL[args.flow_control]
    # the same way, in main() - placeholders only.
    "D7": None,
    "D6": None,

    # Destination addressing: broadcast (DH=0, DL=0xFFFF) -- default.
    "DH": "0",
    "DL": "FFFF",

    # Preamble ID (HP) -- default.
    "HP": 0,

    # EE (Security Enable) -- AES encryption OFF. With it on, each RF packet loses 9 bytes of payload, so a
    # frame that exactly fits the 100-byte packet (the slot table at 97 bytes, the power frame at 95) would be
    # split in two and lost if either half is. Must be the same on every radio in a network.
    "EE": 0,

    # MT (Broadcast Multi-Transmits) -- how many EXTRA times a broadcast
    # is repeated (packets sent = MT+1). Was 3 by default, set to 0.
    "MT": 0,
}

# ─── End config ──────────────────────────────────────────────────────────

# Must exceed the module's own guard time (the "GT" parameter, 1000ms by
# default) both before AND after "+++", or the module reads it as three
# ordinary data bytes instead of the command-mode escape sequence. We only
# need to guarantee the BEFORE side here - the AFTER side falls out for
# free since we always wait for a response before sending anything else.
GUARD_TIME_S = 1.1

RESPONSE_TIMEOUT_S = 2.0
# Stop reading early once this long has passed since the last byte
# arrived, rather than always waiting the full RESPONSE_TIMEOUT_S for a
# short "OK\r" - keeps a config run from taking forever over ~20 commands.
IDLE_GAP_S = 0.25

BAUD_CODE_MAP = {2400: 1, 4800: 2, 9600: 3, 19200: 4, 38400: 5, 57600: 6, 115200: 7, 230400: 8}
BAUD_CODE_TO_RATE = {v: k for k, v in BAUD_CODE_MAP.items()}

# TO (Transmit Options) bits 6:7 - see TRANSMIT_OPTIONS's own comment above.
TO_DELIVERY_LABELS = {0b00: "<invalid>", 0b01: "Point-to-Multipoint", 0b10: "Directed broadcast/repeater",
                       0b11: "DigiMesh (mesh)"}


def hex_to_int(s):
    """Parse a stripped hex string (as AT command mode returns/accepts,
    no 0x prefix) to an int, or None if it doesn't look like one - e.g. an
    empty/garbled response from a wrong baud or a command this firmware
    doesn't support."""
    s = (s or "").strip()
    if not s:
        return None
    try:
        return int(s, 16)
    except ValueError:
        return None


def read_response(ser, timeout=RESPONSE_TIMEOUT_S, idle_gap=IDLE_GAP_S):
    """Read whatever the radio sends back after a command, stopping once
    idle_gap has passed with no new bytes (response is almost certainly
    complete) or timeout is hit outright (nothing coming back at all -
    wrong baud, not actually an XBee, etc.)."""
    buf = bytearray()
    deadline = time.monotonic() + timeout
    last_byte_time = None
    while time.monotonic() < deadline:
        chunk = ser.read(64)
        if chunk:
            buf += chunk
            last_byte_time = time.monotonic()
        elif last_byte_time is not None and (time.monotonic() - last_byte_time) > idle_gap:
            break
    return buf.decode("ascii", errors="replace")


def enter_command_mode(ser):
    """Send the "+++" escape sequence and confirm the module answers
    "OK" - the same thing typing it into a terminal does. Raises
    RuntimeError (not a bare assert) since the caller wants to print a
    specific, actionable message rather than a stack trace."""
    ser.reset_input_buffer()
    ser.reset_output_buffer()
    time.sleep(GUARD_TIME_S)
    ser.write(b"+++")
    resp = read_response(ser, timeout=2.0)
    if "OK" not in resp:
        raise RuntimeError(
            f"no \"OK\" after +++ (got {resp!r}) - wrong --connect-baud, wrong --port, "
            f"or this isn't an XBee currently in AT/transparent mode?"
        )


def send_at(ser, cmd):
    """Write one AT command (without the trailing \\r - added here) and
    return whatever comes back, stripped of surrounding whitespace."""
    ser.write((cmd + "\r").encode("ascii"))
    return read_response(ser)


def query(ser, param):
    """Read-only: AT<param> with no value queries the current setting."""
    return send_at(ser, f"AT{param}").strip()


def set_and_verify(ser, param, value_hex, label):
    """AT<param><value_hex> to set it, then a bare query to read it back -
    set-then-confirm, entirely over AT Command Mode text (no digi-xbee,
    no binary API frames). Compares as integers (not raw strings) since a
    readback may come back with different leading-zero padding than what
    was sent, without that being a real mismatch."""
    resp = send_at(ser, f"AT{param}{value_hex}")
    set_ok = "OK" in resp
    readback = query(ser, param)
    a, b = hex_to_int(value_hex), hex_to_int(readback)
    match = set_ok and a is not None and a == b
    print(f"  {label:28s} set={value_hex:<10} readback={readback.upper():<10} "
          f"{'OK' if match else '*** MISMATCH ***'}")
    return match


def compare_row(label, current_raw, target_hex, decode=None):
    """Print one dry-run row: the radio's CURRENT value for one parameter
    next to what this script would set it TO - always, even when they
    already match, so the full current/target picture stays visible. Only
    an actual mismatch (or an unreadable current value) gets a trailing
    status flag - a matching row's status is left blank rather than
    spelling out "already correct" on every single line. Returns True if
    applying the script would actually change this parameter, so the
    caller can tally how many will. decode(int)->str, if given, appends a
    human-readable label to both sides (e.g. TO's delivery method, BD's
    baud rate)."""
    cur_val = hex_to_int(current_raw)
    tgt_val = hex_to_int(target_hex)
    cur_str = f"0x{cur_val:X}" if cur_val is not None else f"<no response: {current_raw!r}>"
    tgt_str = f"0x{tgt_val:X}"
    if decode:
        if cur_val is not None:
            cur_str += f" ({decode(cur_val)})"
        tgt_str += f" ({decode(tgt_val)})"
    will_change = cur_val is None or cur_val != tgt_val
    status = ""
    if cur_val is None:
        status = "*** currently unreadable - would attempt to set anyway ***"
    elif will_change:
        status = "*** WILL CHANGE ***"
    print(f"  {label:28s} current={cur_str:<26} target={tgt_str:<26} {status}")
    return will_change


def dry_run_report(ser, target_baud):
    """Same parameters read_config reads, but as a current-vs-target diff
    against CONFIG (and --target-baud for BD) - so --dry-run answers "what
    would actually change" directly, not just "what's there now" (which
    left it up to you to compare against CONFIG by eye). Every parameter
    gets a row regardless of whether it matches (see compare_row); a
    trailing summary line says how many of them actually would change.
    Returns the number of mismatches - 0 means everything already matches
    CONFIG, which main() also uses as its actual proof of persistence: it
    re-runs this against the radio after a real reset (see "Verifying
    persistence" below), not just against the same still-running session
    a set-and-verify readback would trust."""
    changed = 0

    changed += compare_row("TO (Transmit Options)", query(ser, "TO"), format(CONFIG["TRANSMIT_OPTIONS"], "X"),
                            decode=lambda v: TO_DELIVERY_LABELS.get((v >> 6) & 0b11, "unknown"))

    nid = CONFIG["NETWORK_ID"]
    nid_hex = nid[2:] if nid.lower().startswith("0x") else nid
    changed += compare_row("ID (Network ID)", query(ser, "ID"), nid_hex)

    changed += compare_row("DH (Dest high)", query(ser, "DH"), CONFIG["DH"])
    changed += compare_row("DL (Dest low)", query(ser, "DL"), CONFIG["DL"])
    changed += compare_row("HP (Preamble ID)", query(ser, "HP"), format(CONFIG["HP"], "X"))
    changed += compare_row("MT (Broadcast Multi-Tx)", query(ser, "MT"), format(CONFIG["MT"], "X"))
    changed += compare_row("CE (Node Msg Options)", query(ser, "CE"), format(CONFIG["CE"], "X"))
    changed += compare_row("D7 (CTS flow control)", query(ser, "D7"), format(CONFIG["D7"], "X"),
                            decode=lambda v: DIO_LABELS.get(v, "other"))
    changed += compare_row("D6 (RTS flow control)", query(ser, "D6"), format(CONFIG["D6"], "X"),
                            decode=lambda v: DIO_LABELS.get(v, "other"))
    changed += compare_row("EE (Encryption)", query(ser, "EE"), format(CONFIG["EE"], "X"),
                            decode=lambda v: "encryption ON - 9 bytes less payload per packet" if v else "encryption off")

    total = 10  # TO, ID, DH, DL, HP, MT, CE, D7, D6, EE - kept in sync with the calls above

    bd_code = BAUD_CODE_MAP.get(target_baud)
    if bd_code is not None:
        changed += compare_row("BD (Baud rate)", query(ser, "BD"), format(bd_code, "X"),
                                decode=lambda v: f"{BAUD_CODE_TO_RATE.get(v, 'code ' + str(v))} baud")
        total += 1
    else:
        print(f"  {'BD (Baud rate)':28s} no code mapping for --target-baud {target_baud}, skipping comparison")

    if changed == 0:
        print(f"\nAll {total} parameters already match - running for real would be a no-op.")
    else:
        print(f"\n{changed} of {total} parameters would change.")
    return changed


def read_config(ser):
    """Read and print every parameter this script cares about, decoded
    into human-readable form where possible. Safe to call any time -
    read-only, never writes anything."""
    to = query(ser, "TO")
    to_val = hex_to_int(to)
    if to_val is not None:
        delivery = TO_DELIVERY_LABELS.get((to_val >> 6) & 0b11, "unknown")
        print(f"  {'TO (Transmit Options)':28s} 0x{to_val:02X}  -> {delivery}")
    else:
        print(f"  {'TO (Transmit Options)':28s} <no response: {to!r}>")

    nid = query(ser, "ID")
    print(f"  {'ID (Network ID)':28s} 0x{nid.upper() or '?'}")

    dh, dl = query(ser, "DH"), query(ser, "DL")
    broadcast = hex_to_int(dh) == 0 and hex_to_int(dl) == 0xFFFF
    print(f"  {'DH/DL (Destination)':28s} {dh.upper()}/{dl.upper()}{'  (broadcast)' if broadcast else ''}")

    hp = query(ser, "HP")
    print(f"  {'HP (Preamble ID)':28s} {hex_to_int(hp)}")

    mt = query(ser, "MT")
    print(f"  {'MT (Broadcast Multi-Tx)':28s} {hex_to_int(mt)}")

    ce = query(ser, "CE")
    print(f"  {'CE (Node Msg Options)':28s} {hex_to_int(ce)}")

    for name, label in (("D7", "D7 (CTS flow control)"), ("D6", "D6 (RTS flow control)")):
        v = hex_to_int(query(ser, name))
        print(f"  {label:28s} {v if v is not None else '?'}  ({DIO_LABELS.get(v, 'other') if v is not None else 'no response'})")

    ee = hex_to_int(query(ser, "EE"))
    print(f"  {'EE (Encryption)':28s} {ee if ee is not None else '?'}  "
          f"({'encryption ON - 9 bytes less payload per packet' if ee else 'encryption off' if ee == 0 else 'no response'})")

    bd = query(ser, "BD")
    bd_val = hex_to_int(bd)
    rate = BAUD_CODE_TO_RATE.get(bd_val, f"code {bd_val} (unmapped)") if bd_val is not None else "?"
    print(f"  {'BD (Baud rate)':28s} {rate}")


def open_and_enter_command_mode(port, baud):
    """Shared by the initial connect and the post-baud-change reconnect
    below - opens the port and enters command mode, or prints a specific
    hint and exits for the two failure modes actually seen in practice.
    Prints which baud it's trying BEFORE attempting anything, not just on
    success - a wrong --connect-baud is the single most common way this
    fails, and the baud actually being tried needs to be visible right
    next to that failure, not buried in a success message that never
    prints."""
    print(f"Connecting to {port} at {baud} baud...")
    try:
        ser = serial.Serial(port, baud, timeout=0.05)
    except serial.SerialException as e:
        print(f"Failed to open {port} at {baud} baud: {e}")
        msg = str(e).lower()
        if "lock" in msg or "temporarily unavailable" in msg:
            print("  -> Something else already has this port open. Only one process can hold a "
                  "serial port at a time -- stop any running `npm run base`/`npm run boat`/"
                  "`npm run radio-test`, XCTU, or other serial terminal using this port, then retry.")
        sys.exit(1)
    try:
        enter_command_mode(ser)
    except RuntimeError as e:
        print(f"Failed to enter command mode at {baud} baud: {e}")
        print(f"  -> --connect-baud defaults to 115200 (RADIO_BAUD in race-tracker's own .env, and "
              f"every radio configured by this script or race-tracker itself, ends up here) - if this "
              f"is a genuinely factory-fresh radio instead, it's still at Digi's own 9600 default, not "
              f"115200 - retry with --connect-baud 9600.")
        print(f"  -> If neither 9600 nor 115200 is it, a totally empty response more often means: "
              f"wrong --port (double check with `ls /dev/cu.*` before/after plugging it in), TX/RX "
              f"swapped on the wiring, or the radio not actually getting power/a solid USB connection. "
              f"Try the same +++ by hand in a plain terminal (`screen {port} {baud}`) to see whether "
              f"the problem is this script or the link itself.")
        ser.close()
        sys.exit(1)
    print(f"Connected at {baud} baud - command mode entered.")
    return ser


def main():
    ap = argparse.ArgumentParser(description=__doc__, formatter_class=argparse.RawDescriptionHelpFormatter)
    ap.add_argument("--port", required=True, help="Serial port, e.g. /dev/ttyUSB0 or COM5")
    ap.add_argument("--connect-baud", type=int, default=115200,
                     help="Baud to connect at (radio's CURRENT speed, default 115200 - matches RADIO_BAUD "
                          "in race-tracker's own .env, and every radio this script or race-tracker itself "
                          "has already touched; pass --connect-baud 9600 for a genuinely factory-fresh "
                          "radio instead)")
    ap.add_argument("--target-baud", type=int, default=CONFIG["TARGET_BAUD"],
                     help=f"Baud to SET the radio to (BD parameter, default {CONFIG['TARGET_BAUD']}). "
                          f"Pass --target-baud 0 to leave BD untouched.")
    ap.add_argument("--dry-run", action="store_true", help="Read current config only, change nothing")
    ap.add_argument(
        "--mode",
        choices=sorted(MODES.keys()),
        default=DEFAULT_MODE,
        help=f"Delivery mode (default {DEFAULT_MODE}) - p2mp (TO=0x40, matches this fleet's actual "
             f"one-coordinator/many-end-devices topology), digimesh (TO=0xC0, routing/relay off - the "
             f"confirmed-working fallback if p2mp misbehaves, see this script's own top-of-file Note), "
             f"or digimesh-routing (TO=0xC0, routing/relay ON - only needed if a course/fleet layout ever "
             f"genuinely requires multi-hop relaying).",
    )
    ap.add_argument(
        "--flow-control",
        choices=sorted(FLOW_CONTROL.keys()),
        default=None,
        help=f"UART flow control (default: the --role preset - {ROLES['telemetry']['flow']} for telemetry, {ROLES['rtcm']['flow']} for rtcm) - none (D7=0, D6=0), cts (D7=1, D6=0 - Digi's own "
             f"factory default) or rtscts (D7=1, D6=1). rtscts makes the radio stop sending to the host whenever "
             f"RTS is held high, so use it only with an adapter whose RTS line is wired and driven - otherwise "
             f"the radio goes silent to the app. See FLOW_CONTROL in this script.",
    )
    ap.add_argument(
        "--role",
        choices=sorted(ROLES.keys()),
        default=DEFAULT_ROLE,
        help=f"What this radio is for (default {DEFAULT_ROLE}): telemetry = the position link (network ID "
             f"0x{ROLES['telemetry']['ID']:X}, HP {ROLES['telemetry']['HP']}, MT {ROLES['telemetry']['MT']}); "
             f"rtcm = the RTK correction link on its OWN network (ID 0x{ROLES['rtcm']['ID']:X}, HP {ROLES['rtcm']['HP']}, "
             f"MT {ROLES['rtcm']['MT']}, no flow control). Set BOTH ends of each link the same.",
    )
    ap.add_argument("--network-id", type=lambda v: int(v, 0), default=None,
                     help="Override the role's network ID (ID), 0 - 0x7FFF, e.g. 0x2A10")
    ap.add_argument("--preamble-id", type=int, default=None, choices=range(0, 8),
                     help="Override the role's preamble ID (HP), 0 - 7")
    ap.add_argument("--mt", type=int, default=None, choices=range(0, 6),
                     help="Override the role's broadcast multi-transmits (MT), 0 - 5 (each broadcast is sent MT+1 times)")
    args = ap.parse_args()

    # Role preset first, then any explicit overrides, into CONFIG - the single
    # source of truth the rest of this script reads from.
    role = ROLES[args.role]
    network_id = role["ID"] if args.network_id is None else args.network_id
    if not 0 <= network_id <= 0x7FFF:
        ap.error("--network-id must be between 0 and 0x7FFF")
    CONFIG["NETWORK_ID"] = f"0x{network_id:X}"
    CONFIG["HP"] = role["HP"] if args.preamble_id is None else args.preamble_id
    CONFIG["MT"] = role["MT"] if args.mt is None else args.mt
    if args.flow_control is None:
        args.flow_control = role["flow"]

    # Fills in the two MODE-dependent CONFIG values before anything below
    # reads them - CONFIG stays the single source of truth the rest of this
    # script (dry_run_report, the apply loop, read_config) already reads
    # from, so nothing past this point needs to know --mode exists at all.
    CONFIG["TRANSMIT_OPTIONS"] = MODES[args.mode]["TRANSMIT_OPTIONS"]
    CONFIG["CE"] = MODES[args.mode]["CE"]
    CONFIG["D7"] = FLOW_CONTROL[args.flow_control]["D7"]
    CONFIG["D6"] = FLOW_CONTROL[args.flow_control]["D6"]

    ser = open_and_enter_command_mode(args.port, args.connect_baud)
    print(f"Mode: {args.mode} ({MODES[args.mode]['label']}) - TO=0x{CONFIG['TRANSMIT_OPTIONS']:02X}, CE={CONFIG['CE']}")
    print(f"Role: {args.role} ({role['label']}) - ID={CONFIG['NETWORK_ID']}, HP={CONFIG['HP']}, MT={CONFIG['MT']}")
    print(f"Flow control: {args.flow_control} ({FLOW_CONTROL[args.flow_control]['label']}) - D7={CONFIG['D7']}, D6={CONFIG['D6']}")

    try:
        if args.dry_run:
            print("\nCurrent radio configuration vs. what this script would set (nothing written yet):")
            dry_run_report(ser, args.target_baud)
            send_at(ser, "ATCN")
            print("\n--dry-run: not changing anything.")
            return

        print("\n--- BEFORE ---")
        read_config(ser)

        print("\nApplying config...")
        all_ok = True

        all_ok &= set_and_verify(ser, "TO", format(CONFIG["TRANSMIT_OPTIONS"], "X"), "TO (Transmit Options)")

        nid = CONFIG["NETWORK_ID"]
        nid_hex = nid[2:] if nid.lower().startswith("0x") else nid
        all_ok &= set_and_verify(ser, "ID", nid_hex, "ID (Network ID)")

        all_ok &= set_and_verify(ser, "DH", CONFIG["DH"], "DH (Dest high)")
        all_ok &= set_and_verify(ser, "DL", CONFIG["DL"], "DL (Dest low)")
        all_ok &= set_and_verify(ser, "HP", format(CONFIG["HP"], "X"), "HP (Preamble ID)")
        all_ok &= set_and_verify(ser, "MT", format(CONFIG["MT"], "X"), "MT (Broadcast Multi-Tx)")
        all_ok &= set_and_verify(ser, "CE", format(CONFIG["CE"], "X"), "CE (Node Msg Options)")
        all_ok &= set_and_verify(ser, "D7", format(CONFIG["D7"], "X"), "D7 (CTS flow control)")
        all_ok &= set_and_verify(ser, "D6", format(CONFIG["D6"], "X"), "D6 (RTS flow control)")
        all_ok &= set_and_verify(ser, "EE", format(CONFIG["EE"], "X"), "EE (Encryption)")

        # Write everything set so far, BEFORE touching baud - once BD
        # changes, this session's own connection (still at connect-baud)
        # may stop working mid-command, so anything not saved yet by then
        # would be lost.
        wr_resp = send_at(ser, "ATWR")
        print(f"\nConfig (excl. baud) written to non-volatile memory (WR): "
              f"{'OK' if 'OK' in wr_resp else wr_resp.strip()!r}")

        target_baud = args.target_baud
        bd_changed = False
        if target_baud == 0:
            print("Skipping BD: --target-baud 0 given, leaving baud rate untouched.")
        elif target_baud not in BAUD_CODE_MAP:
            print(f"Skipping BD: no code mapping for {target_baud} baud, set manually if needed.")
        else:
            bd_code = BAUD_CODE_MAP[target_baud]
            if target_baud == args.connect_baud:
                # Already at the target baud - set/verify/write normally,
                # no reconnect dance needed.
                all_ok &= set_and_verify(ser, "BD", format(bd_code, "X"), "BD (Baud rate)")
                wr_resp = send_at(ser, "ATWR")
                if "OK" not in wr_resp:
                    print(f"  *** BD write (WR) did not return OK (got {wr_resp!r}) - baud rate may "
                          f"NOT survive a reboot. Re-run this script to confirm/retry. ***")
                    all_ok = False
            else:
                print(f"\nSetting BD to {target_baud} (code {bd_code}) - this switches the radio's "
                      f"actual serial speed, so this session (still at {args.connect_baud}) may stop "
                      f"responding right after. Reconnecting at {target_baud}...")
                bd_resp = send_at(ser, f"ATBD{bd_code:X}")  # response may or may not still arrive at the old baud
                # Many radios only switch speed when command mode ends, not at the moment BD is set. Reconnecting at
                # the new speed straight away then finds a radio still listening at the old one, the script stops
                # there, and the new baud is never written to non-volatile memory - the radio comes back at 9600 after
                # the next power cycle. So write it now, while this session still works, then leave command mode
                # (CN), which is what makes the new speed take effect.
                if "OK" in bd_resp:
                    wr_old = send_at(ser, "ATWR")
                    print(f"  BD written to non-volatile memory at {args.connect_baud} baud (WR): "
                          f"{'OK' if 'OK' in wr_old else wr_old.strip()!r}")
                    send_at(ser, "ATCN")
                ser.close()
                time.sleep(1.5)  # the guard time before +++ at the new speed
                ser = open_and_enter_command_mode(args.port, target_baud)
                # The BD change itself may not have made it into non-volatile
                # memory if the switch happened before WR was processed -
                # write again now that we're talking to it at the new baud, and
                # actually check the response this time (a prior version of
                # this script silently discarded it - if this particular WR
                # ever failed, BD would revert to its old value on the next
                # power cycle with no indication anything was wrong).
                wr_resp = send_at(ser, "ATWR")
                if "OK" not in wr_resp:
                    print(f"  *** BD write (WR) after baud-switch did not return OK (got {wr_resp!r}) - "
                          f"baud rate may NOT survive a reboot. Re-run this script to confirm/retry. ***")
                    all_ok = False
                else:
                    # Belt-and-suspenders read-only check (no re-set, so it
                    # can't undo the WR above) - confirms the NEW baud is
                    # what's actually stored, not just that WR said OK.
                    bd_readback = hex_to_int(query(ser, "BD"))
                    if bd_readback != bd_code:
                        print(f"  *** BD (Baud rate, post-reconnect)     readback={bd_readback} "
                              f"expected={bd_code} *** MISMATCH ***")
                        all_ok = False
                    else:
                        print(f"  {'BD (Baud rate, post-reconnect)':28s} readback={bd_readback:<10} OK")
                bd_changed = True

        print("\n--- AFTER (this session's own memory - not proof of persistence) ---")
        read_config(ser)

        # A set-and-verify readback, and even the "AFTER" dump above, only
        # prove a parameter is correct in the device's CURRENT session -
        # exactly what silently masked the earlier BD-not-surviving-reboot
        # bug (its own WR response went unchecked, so nothing here would
        # have caught it either). A real soft reset via FR (Force Reset)
        # exercises the actual load-from-NVM-on-boot path a power cycle
        # would, so reconnecting afterward and re-diffing against CONFIG
        # (reusing dry_run_report - same check --dry-run does) is the
        # first thing in this script that actually proves persistence
        # rather than assuming it from an "OK" string.
        print("\n--- Verifying persistence (soft reset) ---")
        verify_baud = target_baud if (target_baud != 0 and target_baud in BAUD_CODE_MAP) else args.connect_baud
        fr_resp = send_at(ser, "ATFR")
        if "OK" not in fr_resp:
            print(f"  *** FR (Force Reset) did not return OK (got {fr_resp!r}) - could not verify "
                  f"persistence. Re-run this script to confirm settings actually survive a reboot. ***")
            all_ok = False
        else:
            ser.close()
            time.sleep(1.5)  # let the module actually finish rebooting before reconnecting
            ser = open_and_enter_command_mode(args.port, verify_baud)
            print("Reconnected after reset - re-checking every parameter against CONFIG:")
            mismatches = dry_run_report(ser, verify_baud)
            if mismatches:
                print(f"*** {mismatches} parameter(s) reverted after reset - see above. Re-run this "
                      f"script; if it keeps happening, something below the script's own visibility "
                      f"(e.g. power cut before a flash write physically completes) is the real cause. ***")
                all_ok = False

        print("\n" + ("All parameters verified OK and confirmed to survive a reset." if all_ok else
                       "*** One or more parameters did not verify or did not survive a reset -- "
                       "check output above. ***"))

        if bd_changed:
            print(f"\nNote: radio's serial baud rate is now {target_baud}. "
                  f"Reconnect future sessions with --connect-baud {target_baud}.")

        send_at(ser, "ATCN")

    except serial.SerialException as e:
        # A mid-session OS-level read/write failure - not a bug in this
        # script's own AT-command logic (that would show up as garbled or
        # missing responses, not an exception from pyserial itself). This
        # means the OS lost the underlying device: the USB-serial adapter
        # or the radio disconnected/reset mid-session, another process
        # grabbed the port out from under us, or a marginal
        # cable/connector dropped out under the intermittent current draw
        # of a live radio.
        print(f"\n*** Lost the connection to {args.port} mid-session: {e} ***")
        print("  -> Check the physical USB connection (reseat the cable/adapter, try a different "
              "port, avoid unpowered hubs), confirm nothing else opened this port during the run, "
              "and re-run once the link is solid. If this keeps happening on one specific radio, "
              "suspect that radio/its connector rather than this script.")
        sys.exit(1)

    finally:
        # A port that just raised SerialException may already be in a bad
        # state at the OS level - closing it should be harmless, but this
        # is cleanup code, not somewhere a second exception should get to
        # mask or crash past the one already being handled/reported above.
        try:
            ser.close()
        except serial.SerialException:
            pass


if __name__ == "__main__":
    main()
