sdale511/race-tracker/ubx_config_report.py

#!/usr/bin/env python3
"""
ubx_config_report.py

Reads the ArduSimpleRTK2B (ZED-F9P) settings this project's own GPS setup
depends on - fix rate, UART baud, message output, TMODE3 mode, RTCM3 output
- the same settings gps_config_report.sh reports, but talking the UBX binary
protocol directly over pyserial instead of shelling out to gpsd's ubxtool.
Same reasoning as xbee_configure_at.py's own "why not a library" comment -
this needs to work on a machine that won't/can't install gpsd-clients, the
same way that script avoids needing the digi-xbee library. Speaks plain UBX
frames, no other dependency.

Sends one UBX-CFG-VALGET (class 0x06, id 0x8B) request per key, RAM layer
(what's actually running right now, not just what's saved to survive a
reboot), and decodes the single-key response. Read-only - never sends
UBX-CFG-VALSET, never changes anything on the board.

Every key ID below is the ZED-F9P's own official 32-bit config key -
cross-checked against two independent open-source references (SparkFun's
u-blox GNSS library's u-blox_config_keys.h, and pyubx2's
ubxtypes_configdb.py) rather than typed from memory, since a wrong key ID
here would silently poll the wrong setting instead of failing obviously -
both agree on every value used here.

USAGE
    pip install pyserial
    python3 ubx_config_report.py --port /dev/ttyAMA0 --baud 115200

    python3 ubx_config_report.py --port /dev/cu.usbmodem101 --comms
        Instead of the settings, measures how many bytes the receiver is actually
        sending and receiving on each of its ports (UBX-MON-COMMS), twice a few
        seconds apart. UART2 is the correction radio's port: its sent rate should
        be roughly the size of one RTCM epoch per second (about 450-500 bytes/s
        on a base), and on a rover its RECEIVED rate should be about the same.

    Connect on whichever port reaches the receiver (the board's USB port,
    e.g. /dev/ttyACM0 or /dev/cu.usbmodem*, or UART1). The "_UART2" rows are
    that port's own output settings, read over any connection - you do NOT
    connect to UART2 itself to see them.
"""

import argparse
import struct
import sys
import time

import serial

UBX_SYNC1 = 0xB5
UBX_SYNC2 = 0x62
CLASS_CFG = 0x06
ID_VALGET = 0x8B
CLASS_ACK = 0x05
ID_ACK_ACK = 0x01
ID_ACK_NAK = 0x00

# 0=RAM (what's actually running right now), 1=BBR, 2=Flash, 7=Default -
# RAM is the one that matters here, same choice gps_config_report.sh makes
# with its own `-g KEY,0`.
LAYER_RAM = 0

# name, key ID, decode kind, human label - decode kind is one of:
#   u1/u2/u4 - plain unsigned int of that byte width
#   bool     - 1 byte, 0/1
#   tmode    - 1 byte enum, printed with its 0/1/2 meaning
# Cross-checked against SparkFun's u-blox_config_keys.h AND pyubx2's
# ubxtypes_configdb.py - both independently agree on every ID below.
KEYS = [
    ("CFG-RATE-MEAS", 0x30210001, "u2", "Measurement period, ms - 100 = 10Hz, 1000 = 1Hz"),
    ("CFG-RATE-NAV", 0x30210002, "u2", "Nav solutions per measurement - normally 1"),
    ("CFG-UART1-BAUDRATE", 0x40520001, "u4", "UART1 baud - must match this app's GPS_BAUD"),
    ("CFG-UART2-BAUDRATE", 0x40530001, "u4", "UART2 baud - the simpleRTK2B LR's correction-radio port"),
    ("CFG-MSGOUT-UBX_NAV_PVT_UART1", 0x20910007, "u1", "UBX-NAV-PVT rate on UART1 - must be on (1) or this app sees nothing"),
    ("CFG-UART1OUTPROT-NMEA", 0x10740002, "bool", "NMEA on UART1 - fine either way, disabling just saves bandwidth"),
    ("CFG-MSGOUT-UBX_NAV_SVIN_UART1", 0x20910089, "u1", "UBX-NAV-SVIN rate on UART1 - needed for the admin dashboard's survey-in card"),
    ("CFG-MSGOUT-UBX_RXM_RTCM_UART1", 0x20910269, "u1", "UBX-RXM-RTCM rate on UART1 - needed for RTCM_LOG visibility into corrections arriving"),
    ("CFG-TMODE-MODE", 0x20030001, "tmode", "TMODE3 mode - 0=disabled, 1=survey-in, 2=fixed"),
    # Rover-side checks: corrections must be ACCEPTED on the port the correction
    # radio is wired to (UART2 on the simpleRTK2B), and the rover must track the
    # same constellations/signals the base sends observations for (the base's
    # MSM4 messages carry GPS/GLONASS/Galileo/BeiDou L1+L2-class signals - the
    # receiver's defaults already enable all of them).
    ("CFG-UART2INPROT-RTCM3X", 0x10750004, "bool", "RTCM3 accepted as INPUT on UART2 - a rover needs this on"),
    ("CFG-UART1INPROT-RTCM3X", 0x10730004, "bool", "RTCM3 accepted as INPUT on UART1 (only matters if corrections are fed in over the Pi)"),
    ("CFG-NAVHPG-DGNSSMODE", 0x20140011, "u1", "Differential mode - 3 = RTK fixed (default), 2 = float only"),
    ("CFG-NAVSPG-DYNMODEL", 0x20110021, "u1", "Dynamic platform model - 0 portable (default), 4 automotive"),
    ("CFG-SIGNAL-GPS_ENA", 0x1031001F, "bool", "GPS tracking enabled (must match what the base sends)"),
    ("CFG-SIGNAL-GLO_ENA", 0x10310025, "bool", "GLONASS tracking enabled"),
    ("CFG-SIGNAL-GAL_ENA", 0x10310021, "bool", "Galileo tracking enabled"),
    ("CFG-SIGNAL-BDS_ENA", 0x10310022, "bool", "BeiDou tracking enabled"),
    ("CFG-MSGOUT-RTCM_3X_TYPE1005_UART2", 0x209102BF, "u1", "Station coordinates"),
    ("CFG-MSGOUT-RTCM_3X_TYPE1077_UART2", 0x209102CE, "u1", "GPS MSM7 observations"),
    ("CFG-MSGOUT-RTCM_3X_TYPE1087_UART2", 0x209102D3, "u1", "GLONASS MSM7 observations"),
    ("CFG-MSGOUT-RTCM_3X_TYPE1097_UART2", 0x2091031A, "u1", "Galileo MSM7 observations"),
    ("CFG-MSGOUT-RTCM_3X_TYPE1127_UART2", 0x209102D8, "u1", "BeiDou MSM7 observations"),
    ("CFG-MSGOUT-RTCM_3X_TYPE1230_UART2", 0x20910305, "u1", "GLONASS code-phase biases"),
    # MSM4 observations (the smaller RTCM message set - ArduSimple's own
    # factory default for a base, and what a board left at defaults actually
    # sends), UART2. The MSM7 rows above are what this project's own
    # ubx_config_set.py --role base asks for; a board showing these on and
    # those off hasn't had that script applied.
    ("CFG-MSGOUT-RTCM_3X_TYPE1074_UART2", 0x20910360, "u1", "GPS MSM4 observations"),
    ("CFG-MSGOUT-RTCM_3X_TYPE1084_UART2", 0x20910365, "u1", "GLONASS MSM4 observations"),
    ("CFG-MSGOUT-RTCM_3X_TYPE1094_UART2", 0x2091036A, "u1", "Galileo MSM4 observations"),
    ("CFG-MSGOUT-RTCM_3X_TYPE1124_UART2", 0x2091036F, "u1", "BeiDou MSM4 observations"),
    ("CFG-UART2OUTPROT-RTCM3X", 0x10760004, "bool", "RTCM3 allowed as an OUTPUT protocol on UART2 - must be on or the messages above never leave"),
    # UART2 feeds the correction radio, so anything but RTCM leaving it is junk
    # in the radio link. u-blox's own defaults are UBX off and NMEA off here.
    ("CFG-UART2OUTPROT-UBX", 0x10760001, "bool", "UBX allowed as an OUTPUT protocol on UART2 - should be OFF (the radio would transmit it)"),
    ("CFG-UART2OUTPROT-NMEA", 0x10760002, "bool", "NMEA allowed as an OUTPUT protocol on UART2 - should be OFF (the radio would transmit it)"),
    # The same set on UART1 - the port a Pi reads, e.g. a forwarder for a
    # one-radio design. ubx_config_set.py --role base keeps UART1 and UART2
    # identical: MSM4 on, MSM7 off.
    ("CFG-MSGOUT-RTCM_3X_TYPE1005_UART1", 0x209102BE, "u1", "UART1: station coordinates"),
    ("CFG-MSGOUT-RTCM_3X_TYPE1074_UART1", 0x2091035F, "u1", "UART1: GPS MSM4 observations"),
    ("CFG-MSGOUT-RTCM_3X_TYPE1084_UART1", 0x20910364, "u1", "UART1: GLONASS MSM4 observations"),
    ("CFG-MSGOUT-RTCM_3X_TYPE1094_UART1", 0x20910369, "u1", "UART1: Galileo MSM4 observations"),
    ("CFG-MSGOUT-RTCM_3X_TYPE1124_UART1", 0x2091036E, "u1", "UART1: BeiDou MSM4 observations"),
    ("CFG-MSGOUT-RTCM_3X_TYPE1230_UART1", 0x20910304, "u1", "UART1: GLONASS code-phase biases"),
    ("CFG-MSGOUT-RTCM_3X_TYPE1077_UART1", 0x209102CD, "u1", "UART1: GPS MSM7 observations"),
    ("CFG-MSGOUT-RTCM_3X_TYPE1087_UART1", 0x209102D2, "u1", "UART1: GLONASS MSM7 observations"),
    ("CFG-MSGOUT-RTCM_3X_TYPE1097_UART1", 0x20910319, "u1", "UART1: Galileo MSM7 observations"),
    ("CFG-MSGOUT-RTCM_3X_TYPE1127_UART1", 0x209102D7, "u1", "UART1: BeiDou MSM7 observations"),
    ("CFG-UART1OUTPROT-RTCM3X", 0x10740004, "bool", "RTCM3 allowed as an OUTPUT protocol on UART1"),
    # The same messages on the USB port - a PC tool such as PyGPSClient
    # connected over USB sees THESE, not the UART2 settings above, so compare
    # the two before assuming a USB capture shows what the correction radio gets.
    ("CFG-MSGOUT-RTCM_3X_TYPE1005_USB", 0x209102C0, "u1", "USB: station coordinates"),
    ("CFG-MSGOUT-RTCM_3X_TYPE1074_USB", 0x20910361, "u1", "USB: GPS MSM4 observations"),
    ("CFG-MSGOUT-RTCM_3X_TYPE1084_USB", 0x20910366, "u1", "USB: GLONASS MSM4 observations"),
    ("CFG-MSGOUT-RTCM_3X_TYPE1094_USB", 0x2091036B, "u1", "USB: Galileo MSM4 observations"),
    ("CFG-MSGOUT-RTCM_3X_TYPE1124_USB", 0x20910370, "u1", "USB: BeiDou MSM4 observations"),
    ("CFG-MSGOUT-RTCM_3X_TYPE1077_USB", 0x209102CF, "u1", "USB: GPS MSM7 observations"),
    ("CFG-MSGOUT-RTCM_3X_TYPE1087_USB", 0x209102D4, "u1", "USB: GLONASS MSM7 observations"),
    ("CFG-MSGOUT-RTCM_3X_TYPE1097_USB", 0x2091031B, "u1", "USB: Galileo MSM7 observations"),
    ("CFG-MSGOUT-RTCM_3X_TYPE1127_USB", 0x209102D9, "u1", "USB: BeiDou MSM7 observations"),
    ("CFG-MSGOUT-RTCM_3X_TYPE1230_USB", 0x20910306, "u1", "USB: GLONASS code-phase biases"),
    ("CFG-USBOUTPROT-RTCM3X", 0x10780004, "bool", "RTCM3 allowed as an OUTPUT protocol on USB"),
]

DECODE_SIZE = {"u1": 1, "u2": 2, "u4": 4, "bool": 1, "tmode": 1}

RESPONSE_TIMEOUT_S = 1.5


def checksum(data):
    # Standard UBX 8-bit Fletcher checksum over class+id+length+payload.
    ck_a = 0
    ck_b = 0
    for b in data:
        ck_a = (ck_a + b) & 0xFF
        ck_b = (ck_b + ck_a) & 0xFF
    return ck_a, ck_b


def build_frame(msg_class, msg_id, payload):
    body = bytes([msg_class, msg_id]) + struct.pack("<H", len(payload)) + payload
    ck_a, ck_b = checksum(body)
    return bytes([UBX_SYNC1, UBX_SYNC2]) + body + bytes([ck_a, ck_b])


def build_valget_request(key_id):
    # version(1)=0, layer(1)=RAM, position(2)=0, then this one keyID(4).
    payload = struct.pack("<BBHI", 0, LAYER_RAM, 0, key_id)
    return build_frame(CLASS_CFG, ID_VALGET, payload)


# Scans an arbitrary, possibly-interleaved UBX byte stream (a rover already
# streaming UBX-NAV-PVT at its configured rate looks exactly like this -
# our own VALGET response is just one frame among many) for the next
# complete, checksum-valid frame - same "find sync, read length, verify,
# else drop a byte and resync" approach as this project's own
# radioLink.js._onData, just for UBX framing instead of protocol.js's.
def read_next_frame(ser, deadline):
    buf = bytearray()
    while time.time() < deadline:
        chunk = ser.read(max(1, ser.in_waiting or 1))
        if chunk:
            buf.extend(chunk)
        while True:
            sync_idx = buf.find(bytes([UBX_SYNC1, UBX_SYNC2]))
            if sync_idx == -1:
                # No sync found in what's accumulated so far - do NOT just
                # wipe the buffer (a real sync pair routinely arrives split
                # across two separate reads, e.g. one byte at a time when
                # in_waiting is 0 between polls - clearing here would throw
                # the first sync byte away before its partner ever showed up,
                # so a real frame could NEVER be detected except by dumb
                # luck landing in a single read() call). Keep a trailing lone
                # 0xB5 (a possible partial sync) so the next chunk can still
                # complete it; discard everything else so the buffer doesn't
                # grow unbounded while genuinely sync-less noise streams by.
                if buf and buf[-1] == UBX_SYNC1:
                    del buf[:-1]
                else:
                    buf.clear()
                break
            if sync_idx > 0:
                del buf[:sync_idx]
            if len(buf) < 6:
                break  # need class+id+length at least
            msg_class, msg_id, length = buf[2], buf[3], struct.unpack("<H", buf[4:6])[0]
            total_len = 6 + length + 2
            if len(buf) < total_len:
                break  # wait for the rest of this frame
            frame = bytes(buf[:total_len])
            payload = frame[6 : 6 + length]
            ck_a, ck_b = checksum(frame[2 : 6 + length])
            if ck_a == frame[6 + length] and ck_b == frame[6 + length + 1]:
                del buf[:total_len]
                return msg_class, msg_id, payload
            # bad checksum / false sync match - drop one byte and resync
            del buf[:1]
    return None


def decode_value(kind, raw):
    if kind == "u1":
        return raw[0]
    if kind == "u2":
        return struct.unpack("<H", raw)[0]
    if kind == "u4":
        return struct.unpack("<I", raw)[0]
    if kind == "bool":
        return bool(raw[0])
    if kind == "tmode":
        return {0: "0 (disabled)", 1: "1 (survey-in)", 2: "2 (fixed)"}.get(raw[0], f"{raw[0]} (unknown)")
    raise ValueError(f"unknown decode kind: {kind}")


def poll_key(ser, name, key_id, kind, label):
    print(f"\n--- {label} ({name}) ---")
    ser.reset_input_buffer()
    ser.write(build_valget_request(key_id))
    deadline = time.time() + RESPONSE_TIMEOUT_S
    while time.time() < deadline:
        frame = read_next_frame(ser, deadline)
        if frame is None:
            break
        msg_class, msg_id, payload = frame
        if msg_class == CLASS_ACK and msg_id == ID_ACK_NAK:
            print("  (NAK - key not recognized on this firmware, or wrong layer)")
            return None
        if msg_class == CLASS_CFG and msg_id == ID_VALGET:
            # version(1), layer(1), position(2), then keyID(4)+value(N) - one
            # entry, since we only ever ask for one key at a time.
            if len(payload) < 8:
                continue
            got_key_id = struct.unpack("<I", payload[4:8])[0]
            if got_key_id != key_id:
                continue  # some other in-flight response/leftover - keep waiting
            size = DECODE_SIZE[kind]
            value_bytes = payload[8 : 8 + size]
            if len(value_bytes) < size:
                continue
            value = decode_value(kind, value_bytes)
            note = ""
            if name.startswith("CFG-MSGOUT-") and kind == "u1":
                # an output rate in navigation epochs: 0 off, 1 every epoch, 2 every second epoch ...
                note = "  (off)" if value == 0 else "  (every epoch)" if value == 1 else f"  (every {value} epochs)"
            print(f"  {value}{note}")
            return value
        # anything else (a NAV-PVT the rover is already streaming, etc.) -
        # not what we asked for, keep scanning until the deadline.
    print("  (no response - not supported on this firmware, or wrong port/baud)")
    return None


# RTCM message types compared between UART2 (what the onboard correction radio
# actually sends) and USB (what a PC tool such as PyGPSClient sees) - a capture
# over USB only reflects the radio if the two match.
RTCM_TYPES = ("1005", "1074", "1084", "1094", "1124", "1230", "1077", "1087", "1097", "1127")


def compare_uart2_usb(values):
    diffs = []
    for t in RTCM_TYPES:
        u2 = values.get(f"CFG-MSGOUT-RTCM_3X_TYPE{t}_UART2")
        usb = values.get(f"CFG-MSGOUT-RTCM_3X_TYPE{t}_USB")
        if u2 != usb:
            diffs.append(f"{t}: UART2={u2}, USB={usb}")
    print("\n=== RTCM on UART2 (the radio) vs USB (a PC capture) ===")
    if not diffs:
        print("  IDENTICAL - a capture over USB shows what the correction radio sends")
    else:
        print("  DIFFERENT - a capture over USB does NOT match what the radio sends:")
        for d in diffs:
            print(f"    {d}")
    both = [t for t in ("1074", "1084", "1094", "1124") if values.get(f"CFG-MSGOUT-RTCM_3X_TYPE{t}_UART2")]
    msm7 = [t for t in ("1077", "1087", "1097", "1127") if values.get(f"CFG-MSGOUT-RTCM_3X_TYPE{t}_UART2")]
    if both and msm7:
        print(f"  WARNING: UART2 sends BOTH MSM4 ({', '.join(both)}) and MSM7 ({', '.join(msm7)}) - duplicate observations over the radio")


CLASS_MON = 0x0A
ID_MON_COMMS = 0x36
PORT_NAMES = {0x0000: "I2C", 0x0100: "UART1", 0x0201: "UART2", 0x0300: "USB", 0x0400: "SPI"}


def poll_comms(ser):
    """One UBX-MON-COMMS poll -> {port name: (txBytes, rxBytes)}, or None.
    A port only appears once something has been sent or received on it."""
    ser.reset_input_buffer()
    ser.write(build_frame(CLASS_MON, ID_MON_COMMS, b""))
    deadline = time.time() + RESPONSE_TIMEOUT_S
    while time.time() < deadline:
        frame = read_next_frame(ser, deadline)
        if frame is None:
            break
        msg_class, msg_id, payload = frame
        if msg_class == CLASS_MON and msg_id == ID_MON_COMMS and len(payload) >= 8:
            n_ports = payload[1]
            ports = {}
            for i in range(n_ports):
                blk = payload[8 + i * 40 : 8 + (i + 1) * 40]
                if len(blk) < 40:
                    break
                port_id = struct.unpack("<H", blk[0:2])[0]
                tx_bytes = struct.unpack("<I", blk[4:8])[0]
                rx_bytes = struct.unpack("<I", blk[12:16])[0]
                ports[PORT_NAMES.get(port_id, f"0x{port_id:04X}")] = (tx_bytes, rx_bytes)
            return ports
    return None


def comms_report(ser, seconds):
    first = poll_comms(ser)
    if first is None:
        print("  (no UBX-MON-COMMS response - wrong port/baud, or this firmware doesn't support it)")
        return
    print(f"  sampling for {seconds}s ...")
    time.sleep(seconds)
    second = poll_comms(ser)
    if second is None:
        print("  (second poll got no response)")
        return
    print(f"\n  {'port':8s} {'sent B/s':>10s} {'received B/s':>14s}   (total sent / received since power-up)")
    for name in sorted(second):
        tx0, rx0 = first.get(name, (0, 0))
        tx1, rx1 = second[name]
        print(f"  {name:8s} {(tx1 - tx0) / seconds:10.1f} {(rx1 - rx0) / seconds:14.1f}   ({tx1} / {rx1})")
    if "UART2" not in second:
        print("\n  UART2 is not listed: nothing has been sent or received on it since power-up.")
    print("\n  UART2 is the correction radio's port. A base with RTCM enabled should SEND roughly one RTCM epoch a second "
          "(about 450-500 bytes/s with four constellations); a rover should RECEIVE about the same.")


def main():
    ap = argparse.ArgumentParser(description=__doc__, formatter_class=argparse.RawDescriptionHelpFormatter)
    ap.add_argument("--port", required=True, help="Serial port, e.g. /dev/ttyAMA0 or COM5")
    ap.add_argument("--baud", type=int, default=115200, help="Baud to connect at (default 115200, matches GPS_BAUD)")
    ap.add_argument("--comms", action="store_true", help="Measure bytes sent/received per port (UBX-MON-COMMS) instead of reading settings")
    ap.add_argument("--comms-seconds", type=int, default=5, help="Seconds between the two samples for --comms (default 5)")
    args = ap.parse_args()

    print(f"[ubx_config_report] connecting to {args.port} @ {args.baud}")
    try:
        ser = serial.Serial(args.port, args.baud, timeout=0.1)
    except serial.SerialException as e:
        print(f"[ubx_config_report] failed to open {args.port}: {e}")
        sys.exit(1)

    if args.comms:
        try:
            comms_report(ser, args.comms_seconds)
        finally:
            ser.close()
        return

    try:
        values = {}
        for name, key_id, kind, label in KEYS:
            values[name] = poll_key(ser, name, key_id, kind, label)
    finally:
        ser.close()

    compare_uart2_usb(values)

    print(
        "\n[ubx_config_report] done - a board acting as a rover should show the "
        "RTK-base rows (TMODE3, RTCM3 output) at 0/off; a board acting as the "
        "RTK base should show its own rows enabled and CFG-TMODE-MODE non-zero."
    )


if __name__ == "__main__":
    main()
