sdale511/race-tracker/src/config.js

const fs = require('fs');
const path = require('path');
require('dotenv').config();
const { getOrCreatePersistentBoatId, ID_LENGTH: BOAT_ID_LENGTH } = require('./boatIdFile');
const { getPersistedRegattaId, persistRegattaId } = require('./regattaIdFile');
const { getPersistedMarkName, persistMarkName } = require('./markNameFile');
const { getPersistedPowerSchedule, persistPowerSchedule } = require('./powerScheduleFile');
const { MARK_NAMES } = require('./course');
const { MAX_BATCH_COUNT, MAX_DELTA_COUNT } = require('./protocol');
const txDelta = process.env.TX_DELTA !== '0' && process.env.TX_DELTA !== 'false';

// BOAT_ID always wins outright when set (by hand, or by fleetSim.js for
// every boat it spawns) - only falls back to this device's own persisted id
// (see boatIdFile.js) when BOAT_ID is entirely unset, e.g. a standalone
// `npm run boat` nobody's configured yet. The wire protocol's boatId field
// (protocol.js's BOAT_ID_LEN) is just a fixed-width slot of raw ASCII
// bytes - it doesn't actually require letters, that's only
// getOrCreatePersistentBoatId's own choice of alphabet for its randomly
// generated ids (see boatIdFile.js); fleetSim.js, for one, assigns plain
// zero-padded numbers instead (see its own sequentialBoatId). All this
// checks is the one thing that's actually a hard wire-format requirement -
// the length - and fails loudly rather than silently truncating/padding a
// wrong-length value, since a quietly-altered id is a much worse failure
// mode for fleet identification than a clear error at startup.
function resolveBoatId() {
  if (process.env.BOAT_ID === undefined) return getOrCreatePersistentBoatId();
  if (process.env.BOAT_ID.length !== BOAT_ID_LENGTH) {
    throw new Error(
      `BOAT_ID must be exactly ${BOAT_ID_LENGTH} characters (got "${process.env.BOAT_ID}") - the wire protocol's boatId field is a fixed-width ${BOAT_ID_LENGTH}-byte slot`
    );
  }
  return process.env.BOAT_ID;
}

// REGATTAUP_REGATTA_ID always wins when set - and, unlike BOAT_ID (which is
// only ever read, never written back), setting it here also persists it to
// regatta-id.txt immediately, so it becomes the new remembered default from
// this point on even on a later run that omits the env var entirely - see
// regattaIdFile.js's own comment on why both the env var and the admin
// dashboard's dropdown write to that same file. Falls back to whatever's
// already persisted there when the env var isn't set this run; null (not an
// error) if neither exists yet. Returns { id, name, defaultLat, defaultLon,
// venue, startDate, endDate } (everything but id null when setting via the
// env var, which has no way to also supply a display name, RegattaUp's own
// venue coordinates, or its dates - only ever filled in once the admin
// dashboard/startup prompt actually selects this id against RegattaUp's
// own live list, see baseStation.js's selectRegatta), not just a bare id -
// everything but id is display/course-default/offline-fallback only,
// matching is always by id.
function resolveDefaultRegattaId() {
  if (process.env.REGATTAUP_REGATTA_ID) {
    persistRegattaId(process.env.REGATTAUP_REGATTA_ID);
    return { id: process.env.REGATTAUP_REGATTA_ID, name: null, defaultLat: null, defaultLon: null, venue: null, startDate: null, endDate: null };
  }
  return getPersistedRegattaId();
}

// MARK_NAME - which course mark this device physically represents (see
// README's "Mark mode") - a rover permanently attached to a mark buoy that
// auto-sends that mark's position over the radio as it drifts (see
// config.markMode/boatAgent.js's handlePvt). Same env-wins,
// persist-immediately spirit as resolveDefaultRegattaId above - an
// explicit MARK_NAME becomes the new remembered default from this point on,
// so a later restart that omits it still remembers the assignment. Falls
// back to whatever's already persisted when unset; null (not an error, and
// not a failure to run - a markMode device just sits unassigned until one
// is picked from its own dashboard, same as an unpicked regatta) if this
// device has never been assigned one. Validated against MARK_NAMES here
// (unlike BOAT_ID/REGATTAUP_REGATTA_ID, which have no fixed enum to check
// against) so a typo'd env var fails loudly at startup instead of quietly
// never matching any mark this app actually knows about.
function resolveMarkName() {
  const name = process.env.MARK_NAME || getPersistedMarkName();
  if (name && !MARK_NAMES.includes(name)) {
    throw new Error(`MARK_NAME must be one of ${MARK_NAMES.join(', ')} - got "${name}"`);
  }
  if (process.env.MARK_NAME) persistMarkName(name);
  return name || null;
}

// Same env-wins spirit as resolveBoatId/resolveDefaultRegattaId above, but
// per-field rather than all-or-nothing: each of the four ROVER_SHUTDOWN_*
// vars independently overrides whatever's persisted, since an operator
// might reasonably set just ROVER_SHUTDOWN_AT in a systemd unit and leave
// the rest to their previous dashboard-set values (or the hardcoded
// defaults). Whatever the effective combination ends up being this boot -
// some fields from env vars, the rest from the last persisted schedule or
// their defaults - gets persisted right back, so a later restart with NO
// env vars at all (the normal case once an operator's using the rover
// dashboard's own power card - see roverAdminServer.js/powerSchedule.js)
// remembers exactly what was in effect last, not just whatever a stale env
// var says.
function resolveDefaultPowerSchedule() {
  const persisted = getPersistedPowerSchedule() || {};
  const schedule = {
    shutdownAt:
      process.env.ROVER_SHUTDOWN_AT !== undefined ? process.env.ROVER_SHUTDOWN_AT || null : persisted.shutdownAt ?? null,
    shutdownIdleMinutes:
      process.env.ROVER_SHUTDOWN_IDLE_MIN !== undefined
        ? parseFloat(process.env.ROVER_SHUTDOWN_IDLE_MIN)
        : persisted.shutdownIdleMinutes ?? 10,
    shutdownSpeedKn:
      process.env.ROVER_SHUTDOWN_SPEED_KN !== undefined
        ? parseFloat(process.env.ROVER_SHUTDOWN_SPEED_KN)
        : persisted.shutdownSpeedKn ?? 0.5,
    // false: shut down as soon as the time has passed, whatever the boat is doing (no idle gate). The fleet's Boat shutdown card sets it.
    shutdownRequireIdle:
      process.env.ROVER_SHUTDOWN_REQUIRE_IDLE !== undefined
        ? process.env.ROVER_SHUTDOWN_REQUIRE_IDLE !== '0'
        : persisted.shutdownRequireIdle ?? true,
    shutdownCheckIntervalMs:
      process.env.ROVER_SHUTDOWN_CHECK_INTERVAL_MS !== undefined
        ? parseInt(process.env.ROVER_SHUTDOWN_CHECK_INTERVAL_MS, 10)
        : persisted.shutdownCheckIntervalMs ?? 30000,
  };
  persistPowerSchedule(schedule);
  return schedule;
}

// Central configuration. Override any of these with environment variables,
// e.g. GPS_PORT=/dev/ttyACM0 BOAT_ID=7 npm run boat
// A git-ignored .env file in the project root is loaded automatically (see
// dotenv above), so secrets like REDIS_PASSWORD can live there instead of
// being typed on the command line or hardcoded in this file.

// SIMULATE=1 replaces the real GPS + radio hardware with a fake GPS track
// and a UDP-based stand-in for the radio link, so boatAgent/baseStation can
// be run and tested with no hardware attached (see simGps.js, simRadioLink.js).
const simulate = process.env.SIMULATE === '1' || process.env.SIMULATE === 'true';

// SIMULATE_GPS=1 fakes just the GPS (a simulated race track), while still
// using the real radio hardware on both ends - useful for bench-testing
// actual radios (range, packet loss) without needing a real GPS fix or
// being outdoors. SIMULATE=1 implies this too (full simulation, no
// hardware at all); this only matters as its own flag when you want
// simulated GPS with real radio specifically.
const simulateGps = simulate || process.env.SIMULATE_GPS === '1' || process.env.SIMULATE_GPS === 'true';

// NO_GPS=1 skips starting any GPS source at all - real or simulated. Useful
// with SIMULATE=1 when you want a working sim radio link (course marks,
// the log upload client, radio bench-testing) without a simulated race
// actually running and generating position frames. Independent of
// simulateGps above: this overrides it, not the other way around (see
// boatAgent.js's GPS startup branch).
const noGps = process.env.NO_GPS === '1' || process.env.NO_GPS === 'true';

// TEST_LAP_NUMBER (npm run base) doubles as both the on/off switch and the
// payload for this test mode - 0 (default) means off; any positive value
// sends one synthetic lap straight into the lap webhook queue and exits,
// reported as that lap number, to check the queue -> RegattaUp path end to
// end without a real or simulated race in progress. TEST_LAP_BOAT_ID picks
// which boat it's sent as - a dedicated var rather than reusing BOAT_ID,
// since that otherwise means nothing to the base station (it's a
// boatAgent-only concept everywhere else).
const testLapBoatId = parseInt(process.env.TEST_LAP_BOAT_ID || '1', 10);
const testLapNumber = parseInt(process.env.TEST_LAP_NUMBER || '0', 10);

// The BASE's own received-fix CSV log (see baseStation.js's ensureCsvFile).
// Override to point at wherever a long-running base station's disk should
// hold it. Default is relative to this package (not the shell's cwd), so it
// works the same on a Pi or a laptop. BASE_LOG_DIR/BASE_UPLOAD_DIR (this and
// upload.dir below) are named to match this app's own run-mode names
// (`npm run base`/`npm run boat`), same as BOAT_LOG_DIR - so which var
// controls which role's directory is obvious from the name alone, not
// something you have to remember.
const logDir = process.env.BASE_LOG_DIR || path.join(__dirname, '..', 'base-logs');

// The BOAT's own chunked SD-card log (see sdLogger.js) - deliberately a
// completely separate directory from BASE_LOG_DIR above, not a
// subdirectory of it, so the two never end up sharing one directory even
// when both roles happen to run from the same checkout on the same machine
// (a boat's own track history and a base's received-fix log are different
// data with different retention/pruning, and mixing them under one shared
// directory was genuinely confusing - see README's "File layout"). On the
// boat Pi, override BOAT_LOG_DIR to point at the SD card mount.
const boatLogDir = process.env.BOAT_LOG_DIR || path.join(__dirname, '..', 'boat-logs');

// Where every small piece of persisted config/state lives - the webhook
// retry queues' sqlite files and the boat's course_marks.json cache below,
// plus (independently redeclared in each of their own modules, to avoid a
// circular require back into this file - see boatIdFile.js's own comment)
// boat_id.txt/regatta-id.txt/mark-name.txt/power-schedule.txt. Deliberately
// NOT redirectable via BASE_LOG_DIR - unlike base-logs (raw track data,
// fine to point at a swappable SD card), this is small, low-write-volume
// state that should survive independently of wherever BASE_LOG_DIR happens
// to be pointed this run, same reasoning boatIdFile.js already used for
// its own identity file before this directory existed.
const configDir = path.join(__dirname, '..', 'race-config');
fs.mkdirSync(configDir, { recursive: true });

// Redis connection presets, selected via REDIS_ENV. Hostnames/ports are fine
// to keep in source; credentials are not, so those always come from the
// environment. See "redis" section below for how REDIS_URL can override this
// entirely for ad-hoc use.
const REDIS_CONNECTIONS = {
  local: {
    host: '127.0.0.1',
    port: 6379,
  },
  production: {
    host: 'redis-16266.c60.us-west-1-2.ec2.cloud.redislabs.com',
    port: 16266,
    username: process.env.REDIS_USERNAME || 'default',
    password: process.env.REDIS_PASSWORD,
    ...(process.env.REDIS_TLS === '1' || process.env.REDIS_TLS === 'true' ? { tls: {} } : {}),
  },
};

module.exports = {
  simulate,
  simulateGps,
  noGps,
  testLapBoatId,
  testLapNumber,

  // --- Simulation mode settings (only used when simulate=true) ---
  sim: {
    // Every simulated boat and the base share this port, broadcasting to
    // it (see simRadioLink.js) the same way a real radio broadcasts on its
    // shared RF channel - no per-boat host/address to configure.
    port: parseInt(process.env.SIM_PORT || '41234', 10),
    // Matches the rover profile's 10 Hz (ubx_config_set.py sets the real receiver's measurement rate to 100 ms), so a simulated boat
    // exercises the same radio path as a real one: the boat sends at most TX_SLOT_MAX_HZ (4) of those over the air, thinning
    // around turns, and logs all of them. A lower rate (2 Hz, the old default) never fills a frame or reaches the thinning.
    gpsHz: parseFloat(process.env.SIM_GPS_HZ || '10'),
    // Landsailers, unlike water boats, go much faster downwind than up -
    // low rolling resistance lets apparent wind build well past true wind
    // speed on a reach/run.
    upwindSpeedKn: parseFloat(process.env.SIM_UPWIND_SPEED_KN || '30'),
    downwindSpeedKn: parseFloat(process.env.SIM_DOWNWIND_SPEED_KN || '55'),
    // How many laps (start/finish line crossings, finish direction) each
    // simulated boat sails before it stops.
    lapCount: parseInt(process.env.SIM_LAP_COUNT || '2', 10),
    centerLat: parseFloat(process.env.SIM_CENTER_LAT || '40.8970'), // ~0.5mi north of the original 40.8898
    centerLon: parseFloat(process.env.SIM_CENTER_LON || '-118.3821'),
    // % chance (0-100) each frame is dropped, to simulate radio range dropouts.
    packetLossPct: parseFloat(process.env.SIM_PACKET_LOSS || '0'),
    // SIMULATE=1 base only: broadcast a synthetic RTCM correction burst (six messages the size of
    // a real epoch) every N seconds, so the shared-radio gate and slots can be exercised without
    // hardware. Default 2; 0 = off.
    // (RTCM_INTERVAL_S, which sizes the slot table, is used when this is not set, so the two always agree.)
    rtcmIntervalS: parseFloat(process.env.SIM_RTCM_INTERVAL_S || process.env.RTCM_INTERVAL_S || '2'),
    // Off by default - set to 1 to skip the simulated race entirely and
    // just sit the boat at its start position (see simGps.js's _tick())
    // forever, emitting a stationary but otherwise normal fix stream.
    // Useful for testing start-line-adjacent features (on-grid detection,
    // the map's "edit marks" column) without waiting for a boat to sail
    // off the line seconds after simulation start, or fighting the sim's
    // own movement to keep it near the line.
    startOnly: process.env.SIM_START_ONLY === '1' || process.env.SIM_START_ONLY === 'true',
    // Base only, SIMULATE=1: a pretend Tempest weather station (see
    // simTempest.js) sending the base's own Tempest listener wind down the
    // course - SIM_TEMPEST=0 turns it off. Every SIM_WIND_CHANGE_S it picks a
    // new wind between SIM_WIND_MIN_MPH and SIM_WIND_MAX_MPH, from within
    // SIM_WIND_SWING_DEG either side of the leeward->windward axis.
    tempest: process.env.SIM_TEMPEST !== '0' && process.env.SIM_TEMPEST !== 'false',
    windChangeS: parseFloat(process.env.SIM_WIND_CHANGE_S || '30'),
    windMinMph: parseFloat(process.env.SIM_WIND_MIN_MPH || '5'),
    windMaxMph: parseFloat(process.env.SIM_WIND_MAX_MPH || '8'),
    windSwingDeg: parseFloat(process.env.SIM_WIND_SWING_DEG || '10'),
    // Off by default - diagnostic override for foulWatcher.js (base station
    // side) and RegattaUp's own foul handling: instead of racing normally,
    // the boat holds at its start position exactly like any other boat
    // (still respects prestartDwellS/holdForStart), then on start sails
    // foulWindwardM upwind before turning around and sailing straight back
    // through the finish line, the committee gap, and the start line, all
    // in the downwind (illegal) direction - see simGps.js's
    // _foulWaypoints/_tickFoulTest. A real, repeatable foul event on
    // demand, without needing a human pilot to sail the illegal path by
    // hand. Only meaningful set on ONE boat at a time (see boatAgent.js) -
    // setting it fleet-wide would have every boat drive the same scripted
    // path instead of racing, which isn't useful for anything.
    foulTest: process.env.SIM_FOUL === '1' || process.env.SIM_FOUL === 'true',
    // "A bit windward" - how far upwind (meters) the boat sails before
    // turning back for the illegal return leg. Modest by default: this only
    // needs to look like a real departure, not actually get anywhere near
    // the windward mark.
    foulWindwardM: parseFloat(process.env.SIM_FOUL_WINDWARD_M || '150'),
    // Which windward/leeward mark pair the simulated boat actually races -
    // two letters, windward first, each 'G' (green, short course) or 'B'
    // (black, long course): 'GG' (default, the plain short course), 'BB'
    // (the plain long course), or a mixed 'BG'/'GB' (see course.js's
    // parseCourseMarks/deriveGeometry for how a mixed pair's beat length
    // comes out). Validated eagerly here, not deep inside boatAgent.js's
    // async marks-received callback, so a typo fails fast at startup with a
    // clear message instead of surfacing later mid-race.
    courseMarks: (() => {
      const raw = (process.env.SIM_COURSE_MARKS || 'GG').toUpperCase();
      if (!/^[GB]{2}$/.test(raw)) {
        throw new Error(
          `SIM_COURSE_MARKS must be 2 letters, each G (green) or B (black) - e.g. GG, BB, BG, GB. Got "${process.env.SIM_COURSE_MARKS}"`
        );
      }
      return raw;
    })(),
    // How long (seconds) a normal (non-SIM_START_ONLY) simulated race sits
    // stationary at its start position before actually departing upwind -
    // without this, a normal race launches on its very first tick with no
    // pre-start dwell modeled at all, so on-grid detection (which is
    // specifically about that dwell) never gets a real window to fire in
    // an ordinary test race, only under SIM_START_ONLY's permanent version
    // of the same stationary state. 0 disables the dwell (departs
    // immediately, the old behavior).
    prestartDwellS: parseFloat(process.env.SIM_PRESTART_DWELL_S || '15'),
    // On by default - holds every simulated boat at its start position
    // indefinitely (like SIM_START_ONLY, but releasable) until told to
    // actually start racing: a spacebar press in whichever terminal owns
    // the operator's keyboard (npm run boat's own terminal when run
    // standalone, or npm run fleet's terminal, which forwards the press to
    // every boat it spawned - see boatAgent.js/fleetSim.js). Overrides
    // prestartDwellS (which auto-departs after a fixed time) - the whole
    // point here is a manual release instead of a timer, so the boat gets
    // all sailors/boats on the grid before the race committee actually
    // starts the race server-side. Set SIM_HOLD_FOR_START=0 to go back to
    // the old auto-departing-after-prestartDwellS behavior.
    holdForStart: process.env.SIM_HOLD_FOR_START !== '0' && process.env.SIM_HOLD_FOR_START !== 'false',
    // Off by default - a single `npm run boat` session stays alive after
    // finishing its laps (see boatAgent.js's 'finished' handler) so any
    // still-pending log uploads get a chance to go out. Set to 1 to instead
    // exit the process the moment the simulated race ends - what
    // fleetSim.js wants for every boat it spawns, so a multi-boat run winds
    // itself down on its own instead of leaving every finished boat's
    // process sitting there idle.
    exitOnFinish: process.env.SIM_EXIT_ON_FINISH === '1' || process.env.SIM_EXIT_ON_FINISH === 'true',
  },

  // --- GPS (simpleRTK2B LR, ZED-F9P) ---
  // Default port is the Pi's own hardware UART (GPIO 14/15, see "Wiring
  // notes" in the README - requires disabling Bluetooth on Pis that have
  // it, or these pins default to the glitch-prone mini-UART instead) -
  // frees up the Pi's one USB/OTG port for the radio instead of a hub.
  // Override GPS_PORT back to the module's own USB CDC-ACM device (usually
  // `/dev/ttyACM0`) if you'd rather wire it that way instead. This link is
  // Pi<->GPS only, so baud/bandwidth here is NOT the constraint (the radio
  // link is) - default baud is whatever this UART was actually found
  // running at on real hardware (see README's "GPS configuration"), not
  // the ZED-F9P's factory default (38400) - each UART configures
  // independently, so the two aren't guaranteed to match on a given unit.
  // Also doubles as the base station's own optional GPS (a module wired
  // directly to whatever machine runs the base, e.g. the same simpleRTK2B
  // LR hardware a boat uses) - not for tracking the base itself, but so
  // an operator setting up the course (see adminServer.js's "edit marks"
  // column) can plant marks at their own position with real RTK
  // precision, not just a phone's much coarser Geolocation API. Base and
  // boat are always separate processes, so there's no actual conflict in
  // sharing one var - baseStation.js only opens a port at all when
  // GPS_PORT is *explicitly* set (see its own comment), unlike the boat
  // which always opens one (falling back to this same default) since a
  // boat is assumed to always have real GPS hardware unless told
  // otherwise (SIMULATE/NO_GPS). A base's GPS is commonly wired over USB
  // instead (e.g. straight into the machine running `npm run base`), in
  // which case both GPS_PORT and GPS_BAUD will usually need overriding to
  // match that connection instead of this GPIO-tuned default.
  gps: {
    port: process.env.GPS_PORT || '/dev/ttyAMA0',
    baud: parseInt(process.env.GPS_BAUD || '115200', 10),
    // Off by default (both roles) - a fleet of any real size floods the
    // console with a per-fix line each, drowning out anything else worth
    // watching. Set GPS_LOG=1 to turn the [gps]/[baseGps] console line back
    // on, e.g. while confirming a fix is actually coming through.
    logConsole: process.env.GPS_LOG === '1' || process.env.GPS_LOG === 'true',
    // On by default, and only actually matters when stdout is a real
    // terminal (see boatAgent.js's handlePvt and baseStation.js's
    // openBaseGps) - that's when a fix overwrites the same console line
    // instead of scrolling. Both boat and base show every fix this way
    // (not gated by TX_DISTANCE_M - that gate is only about what's worth
    // transmitting/recording, not what's worth watching), except a boat
    // fix that actually clears TX_DISTANCE_M, which commits to scrollback
    // instead of being overwritten, since that's a real event (a radio
    // send) worth keeping. Set GPS_LOG_REPLACE=0 to always scroll (one
    // line per logged fix) instead, e.g. if something downstream is
    // tailing/grepping this process's own terminal output directly rather
    // than a piped/redirected copy (where the in-place escape codes never
    // applied in the first place - see isTTY check).
    logReplace: process.env.GPS_LOG_REPLACE !== '0' && process.env.GPS_LOG_REPLACE !== 'false',
    // Off by default, boat only (see boatAgent.js's openGps) - logs a
    // Base station only - parameters sent along with a UBX-CFG-TMODE3
    // survey-in request (see adminServer.js's "Start survey-in" button).
    // svinMinDurS is the minimum time the receiver must spend surveying
    // before it can call the result valid, regardless of how quickly the
    // accuracy estimate converges; svinAccLimitMm is the accuracy the mean
    // position has to reach before it's accepted, regardless of how long
    // that takes - survey-in only completes once BOTH are satisfied. 60s /
    // 2000mm are gentle defaults for testing; a real fixed installation
    // typically wants both tightened (longer duration, tighter accuracy)
    // for cm-level RTK base precision.
    svinMinDurS: parseInt(process.env.GPS_SVIN_MIN_DUR_S || '60', 10),
    svinAccLimitMm: parseInt(process.env.GPS_SVIN_ACC_LIMIT_MM || '2000', 10),
  },

  // --- Telemetry radio (transparent-serial style, e.g. Digi XBee-PRO S3B) ---
  // Whatever bytes you write to this port are transmitted over the air and
  // appear byte-for-byte on the matching radio at the base station. Default
  // is 115200, NOT the radio's factory default (9600 for XBee, 57600 for
  // RFD900x/SiK) - at fleet sizes beyond a couple boats, the serial link to
  // the base station's own radio is the actual bottleneck (all boats' frames
  // funnel through that one port), well below the radio's real RF capacity.
  // Tried bumping this to 230400 after a 100-boat radio-congestion run
  // measured the SERIAL link saturating at ~11.2 KB/s (almost exactly
  // 115200's own 8N1 ceiling, 115200/10 bits-per-byte = 11,520 B/s) - but
  // that just exposed a lower ceiling one level up: at 230400 the same test
  // pushed 15.4 KB/s and sync errors jumped from 0.2% to 10.4% (see
  // radioLink.js's own sync-error comment - that's real bit corruption on
  // the RF link, not local buffering, since bandwidth used was still well
  // under 230400's own ~23 KB/s ceiling). This fleet's XBee-PRO 900HP 200K
  // radios' real sustainable RF throughput tops out around ~11-12 KB/s
  // regardless of serial baud - 115200 was accidentally already throttling
  // right at that ceiling, not artificially limiting it. Don't raise this
  // without re-running that same congestion test and checking sync-error
  // rate, not just bandwidth headroom - use TX_BATCH_SIZE instead if you
  // need more real fix throughput (reduces actual RF bytes-per-fix, not
  // just how fast the serial link can be fed). Every radio (base + every
  // boat) must be reconfigured via XCTU (see xbee_configure_at.py) or RFD
  // Modem Tools to actually run at this baud before you change this value
  // to match - a mismatch here just means the port opens but nothing
  // decodes.
  radio: {
    // RADIO_ENABLED=0 skips opening the radio port entirely (e.g. bench-testing
    // GPS alone, no radio hardware attached) - fixes still log to SD.
    enabled: process.env.RADIO_ENABLED !== '0' && process.env.RADIO_ENABLED !== 'false',
    port: process.env.RADIO_PORT || '/dev/ttyUSB0',
    baud: parseInt(process.env.RADIO_BAUD || '115200', 10),
    // BCM GPIO number wired to the XBee's SLEEP_RQ pin (pin 9), used by
    // radio sleep mode (see `sleep` below / roverSleep.js). Unset = not
    // wired, so a real rover ignores sleep commands (SIMULATE=1 always
    // supports them). GPIO17 (header pin 11) is the recommended choice -
    // see README's "Radio sleep wiring". The XBee also needs SM=1.
    sleepGpio: process.env.RADIO_SLEEP_GPIO ? parseInt(process.env.RADIO_SLEEP_GPIO, 10) : null,
  },

  // --- RTCM correction messages (boat only) ---
  // Not tied to having a GPS: with one shared radio the corrections arrive over
  // the telemetry radio itself, so none of this needs a GPS attached.
  rtcm: {
    // Console line for every RTCM correction message: `[rtcm-radio]` for each
    // message that arrives over the telemetry radio, and `[rtcm]` for each
    // UBX-RXM-RTCM message the GPS receiver reports (message type, whether it
    // was applied, CRC failures - the only direct evidence this app can show
    // that correction data is actually reaching the receiver; that message also
    // has to be enabled on the receiver). Defaults off so a one-off diagnostic
    // check doesn't start scrolling unwanted lines on every ordinary run
    // afterward. RTCM_LOG=1 is all it takes (GPS_LOG, the per-fix line, is
    // independent). GPS_LOG_RTCM is the old name, still honoured.
    // RTCM_LOG=1 prints ONE tight line per second per source; RTCM_LOG=2 prints a
    // decoded line per message (see rtcmLog.js). 0 = off.
    log: (() => {
      const v = process.env.RTCM_LOG || process.env.GPS_LOG_RTCM;
      if (v === '2') return 2;
      return v === '1' || v === 'true' ? 1 : 0;
    })(),
    // When the telemetry radio is ALSO the RTK correction link (one shared
    // radio - see README's "RTCM on the shared radio"), RTCM3 messages arrive
    // on the radio's serial port mixed in with telemetry. RTCM_FORWARD=1 writes
    // each one, untouched, to the GPS receiver's serial port so it can use
    // them. Off by default: it needs the Pi's TX line wired to the receiver's RX
    // (nothing in this app wrote to the GPS before), and with a separate
    // correction radio there is nothing to forward. The messages are recognised
    // and counted either way, so they never show up as radio errors.
    forward: process.env.RTCM_FORWARD === '1' || process.env.RTCM_FORWARD === 'true',
  },

  // --- Shared-radio transmit scheduling (boat and base) ---
  // When the telemetry radio is also the RTK correction link, every radio hears the base's
  // RTCM burst once per correction interval, and a frame written during it is delayed and
  // leaves the corrections incomplete (measured - see docs/radio-latency-findings-2026-10-09.pdf).
  // The gate keeps writes clear of the burst; slot mode additionally gives each boat its own
  // slot in the cycle. With no bursts heard (no base, out of range, a separate correction
  // radio) neither does anything. See txScheduler.js/txGate.js/burstTracker.js.
  txGate: {
    // TX_GATE=0 turns the whole thing off.
    enabled: process.env.TX_GATE !== '0' && process.env.TX_GATE !== 'false',
    // Boat: an orange console warning when the base's correction bursts are not heard (see rtcmWatchdog.js) - after warnS seconds
    // without them, repeated every repeatS. RTCM_WATCHDOG=0 turns it off, for a boat whose corrections arrive on a separate radio
    // (so the bursts are never heard on its telemetry radio on purpose).
    rtcmWatch: {
      enabled: process.env.RTCM_WATCHDOG !== '0' && process.env.RTCM_WATCHDOG !== 'false',
      warnS: Math.max(1, parseFloat(process.env.RTCM_WATCHDOG_WARN_S || '20') || 20),
      repeatS: Math.max(5, parseFloat(process.env.RTCM_WATCHDOG_REPEAT_S || '30') || 30),
    },
    // Conflict window around a burst start, as the listening radio decodes it: from blockBeforeMs
    // before to blockAfterMs after (measured: about 40 ms before to 10-20 ms after), plus guardMs
    // each side for timing jitter (measured about 3 ms for clear frames, 10 ms covers most).
    blockBeforeMs: parseInt(process.env.TX_GATE_BEFORE_MS || '40', 10),
    blockAfterMs: parseInt(process.env.TX_GATE_AFTER_MS || '20', 10),
    guardMs: parseInt(process.env.TX_GATE_GUARD_MS || '10', 10),
    // Most frames held at once; beyond that the oldest is dropped (positions are on the SD card).
    maxQueue: parseInt(process.env.TX_GATE_MAX_QUEUE || '12', 10),
    // A held frame older than this is dropped rather than sent stale.
    maxAgeMs: parseInt(process.env.TX_GATE_MAX_AGE_MS || '5000', 10),
    // Slot mode (boat and base; on by default, TX_SLOT_MODE=0 turns it off): release position/batch
    // frames only in this boat's slot of each cycle. Like the gate it does nothing until correction
    // bursts are heard. Slots are assigned by the base: with slot mode on, the base keeps a table
    // of the boats it hears (spread-out order, sticky - slotTable.js) and broadcasts it, and each
    // boat follows its entry. index = TX_SLOT pins one boat to a slot by hand and ignores the table
    // (0 to count-1); with neither a table entry nor TX_SLOT, a boat shares the joinSlots (never
    // assigned) so it can't land on a racing boat's slot. count (slots for boats, including the join slots; the base has one more of its own) and widthMs
    // are the base's (boats adopt them from the table; a pinned boat uses its own). Unless TX_SLOT_COUNT is set, the base derives count
    // from RTCM_INTERVAL_S (default 2 s). Each slot must hold the boat's frames for a cycle: 45 ms
    // holds two 83-byte frames - 16 delta-coded fixes, 8 Hz over a 2 s cycle; size it up for faster
    // rates, and keep count x widthMs inside the gap between bursts.
    slot: {
      enabled: process.env.TX_SLOT_MODE !== '0' && process.env.TX_SLOT_MODE !== 'false',
      index: process.env.TX_SLOT !== undefined && process.env.TX_SLOT !== '' ? parseInt(process.env.TX_SLOT, 10) : null,
      count: Math.max(1, parseInt(process.env.TX_SLOT_COUNT || '25', 10) || 25),
      widthMs: Math.max(5, parseInt(process.env.TX_SLOT_MS || '45', 10) || 45),
      // The last joinSlots of the slots are never assigned: a boat with no slot of its own yet (newly
      // active, or no room left in the table) shares them, so it can't land on a racing boat's slot. The
      // base's value is broadcast; a boat uses its own until it hears a table.
      joinSlots: Math.max(0, parseInt(process.env.TX_SLOT_JOIN || '2', 10) || 0),
      // Boat only, slot mode: the most fixes per second a boat sends in its slot (the rest stay on its SD
      // card), outside the full-rate zone around the marks and the finish line (markZoneM below), where
      // there is no cap. 4 over the default 2 s cycle is 8 fixes, one delta frame (83 bytes), so the 45 ms slot has
      // two frames spare; 8 (the old default) is two frames. Halves the fixes on the legs - radio, Redis and the live
      // map's data - while the turn-aware thinning keeps tacks and gybes. With TX_DELTA=0 use 4 (one 84-byte batch
      // frame). 0 = no cap. Scales with the cycle (4 Hz over 2 s is 8 fixes, and so is 8 Hz over 1 s).
      maxHz: Math.max(0, parseFloat(process.env.TX_SLOT_MAX_HZ || '4') || 0),
      // Base only: the RTK correction interval the base's GPS is set to (see ubx_config_set.py
      // --rtcm-interval). With TX_SLOT_COUNT unset the base works the slot count out from it once, at
      // startup: a 2 s interval has room for about twice as many slots as a 1 s one.
      rtcmIntervalS: Math.max(0.1, parseFloat(process.env.RTCM_INTERVAL_S || process.env.SIM_RTCM_INTERVAL_S || '2') || 2),
      countAuto: process.env.TX_SLOT_COUNT === undefined || process.env.TX_SLOT_COUNT === '',
      // Base only: how often the slot table is rebroadcast.
      tableIntervalS: Math.max(1, parseInt(process.env.TX_SLOT_TABLE_S || '10', 10) || 10),
      // Base only: how long a boat can go without moving before its slot is freed - a stopped boat gives its slot
      // up (a heartbeat fix from a boat sitting still does not count as moving), and it gets the same one back
      // when it moves again.
      staleS: Math.max(10, parseInt(process.env.TX_SLOT_STALE_S || '45', 10) || 45),
      // Base only: how long a slot a boat gave up is held back for it (it gets the same one if it comes
      // back, and the slot is handed to others last).
      holdS: Math.max(0, parseInt(process.env.TX_SLOT_HOLD_S || '1800', 10) || 0),
      // Base only: only boats that have started - come off the start grid across the line - get a slot, so boats
      // rolling out, watching, or heading to camp never do. Needs the course marks (without them everyone is
      // eligible). TX_SLOT_GRID_ONLY=0 gives slots to any boat that is under way.
      gridOnly: process.env.TX_SLOT_GRID_ONLY !== '0' && process.env.TX_SLOT_GRID_ONLY !== 'false',
      // Base: practice mode (PRACTICE_MODE=1) - no start-grid parking or "has to have started" rule, any moving boat gets a slot; boats follow
      // it from the table the base sends. For practice sessions and testing, where boats are not starting races from the grid.
      practice: process.env.PRACTICE_MODE === '1' || process.env.PRACTICE_MODE === 'true',
      // Base only: a boat stays "racing" until it has been stopped this long (or comes back onto the grid), so a stop
      // mid-race does not cost it its place. Its slot is still freed after staleS. A boat sitting on the grid likewise
      // stays "parked" this long without a fix (it sends only a heartbeat about once a minute).
      racingS: Math.max(60, parseInt(process.env.TX_SLOT_RACING_S || '600', 10) || 600),
      // Boat: frames per slot kept free when capping a cycle's fixes to what the slot can carry (see boatAgent.js).
      // 1 leaves a spare frame for a cycle that needs more than its fix count suggests; 0 uses the whole slot.
      reserveFrames: Math.max(0, parseInt(process.env.TX_SLOT_RESERVE_FRAMES || '1', 10) || 0),
      // Boat: within this many metres of a windward/leeward mark or the finish line the whole slot is used (no reserve,
      // no TX_SLOT_MAX_HZ cap) and fixes there are the last to be thinned, so the base sees every mark rounding and the
      // finish at full rate. The finish line counts only for a boat heading upwind (finishApproach.js's headingUpwind), not
      // one running down past it. 0 turns it off.
      markZoneM: Math.max(0, parseFloat(process.env.TX_SLOT_MARK_ZONE_M || '80') || 0),
      // Boats inside the on-grid zone (the area behind the start line) are "parked": they take no slot and
      // report in the shared join slots at most once every parkedReportS seconds (+-25%), so a fleet queueing
      // for a start does not use up the slots or swamp the join slots. A boat leaves that state after
      // unparkFixes fixes in a row outside the zone. 0 turns the throttle off (the base still assigns no slots
      // to boats in the zone).
      parkedReportS: Math.max(0, parseFloat(process.env.TX_PARKED_REPORT_S || '15') || 0),
      // Boat: the first report after parking comes within a random 0..parkedFirstS seconds (so the base hears the boat arrive on the
      // grid at once, not 15 s later), then every parkedReportS. Set it equal to parkedReportS to wait a whole interval first.
      parkedFirstS: Math.max(0, parseFloat(process.env.TX_PARKED_FIRST_S || '2') || 0),
      // Boat: that first report is sent once more about this many seconds later (+-25%), so one lost in the shared join slots is not
      // lost for a whole heartbeat (TX_INTERVAL_S, 60 s). 0 = no repeat.
      // 10 s, not shorter: a fleet's first reports straggle in over about 8 s, and a repeat inside that window adds a second round of frames to the busiest moment.
      parkedRepeatS: Math.max(0, parseFloat(process.env.TX_PARKED_REPEAT_S || '10') || 0),
      unparkFixes: Math.max(1, parseInt(process.env.TX_SLOT_UNPARK_FIXES || '3', 10) || 3),
      // A boat counts as parked only after it has been inside the on-grid zone this many seconds (TX_SLOT_PARK_DWELL_S; boat and base).
      // A racing boat that clips the zone going through the start line is gone in a second or two and keeps its slot; one waiting for
      // a start stays and is parked after the dwell. 0 parks on the first fix inside.
      parkDwellS: Math.max(0, parseFloat(process.env.TX_SLOT_PARK_DWELL_S || '5') || 0),
      // Boat: a boat with no slot of its own (waiting for one, or not racing so never going to get one) reports
      // quickly at first, then backs off to at most one report every joinReportS seconds, so a crowd of such
      // boats does not swamp the shared join slots. 0 turns the back-off off.
      joinReportS: Math.max(0, parseFloat(process.env.TX_JOIN_REPORT_S || '15') || 0),
      // Base only: a fix at or above this speed (knots) counts as active - a boat gets a slot on its first moving
      // fix. activeFrames > 0 also counts that many fixes within activeWindowS seconds as active (slow boats;
      // off by default - on land a boat is either moving or stopped).
      movingKn: Math.max(0, parseFloat(process.env.TX_SLOT_MOVING_KN || '1.5') || 0),
      activeFrames: Math.max(0, parseInt(process.env.TX_SLOT_ACTIVE_FRAMES || '0', 10) || 0),
      activeWindowS: Math.max(1, parseInt(process.env.TX_SLOT_ACTIVE_WINDOW_S || '20', 10) || 20),
    },
  },

  // --- Radio sleep mode (base commands it, rovers obey it) ---
  // The base can put rovers to sleep (and wake them again) with a power
  // frame - see protocol.js's encodePower. A sleeping rover powers its radio
  // down and wakes it for a short listen window every cycleS seconds, long
  // enough to catch a wake frame. Because each rover's cycle is unsynchronised
  // with the base, a wake request is repeated every wakeRepeatMs for a full
  // cycle plus a listen window (see baseStation.js's wakeFleet).
  sleep: {
    // GPS sleep (see gpsSleep.js): the GPS board is put into u-blox software
    // backup mode for the whole sleep, and woken (by a byte on its UART RX
    // line) only when the rover wakes - not on every listen window, since
    // each wake costs a reacquisition. Real-GPS only, except `simWakeDelayMs`.
    gps: {
      // The receiver refuses backup while its USB port is connected; set
      // GPS_SLEEP_FORCE_USB=1 to force it anyway (disables its USB).
      forceUsb: process.env.GPS_SLEEP_FORCE_USB === '1' || process.env.GPS_SLEEP_FORCE_USB === 'true',
      // SIMULATE only: how long the simulated GPS reports nothing after a
      // wake, standing in for a hot-start reacquisition (a few seconds).
      simWakeDelayMs: parseInt(process.env.GPS_SIM_WAKE_DELAY_MS || '3000', 10),
    },
    // Seconds asleep between listen windows. Carried in the sleep frame, so
    // the base's value wins; a rover only falls back to its own for a frame
    // that carries 0. Max 255 (one byte on the wire).
    cycleS: Math.max(1, Math.min(255, parseInt(process.env.SLEEP_CYCLE_S || '10', 10) || 10)),
    // How long a rover keeps its radio on each cycle listening for a wake
    // frame. Must cover the radio's own wake-up time (unmeasured on the real
    // XBee) plus a few of the base's repeats.
    listenMs: parseInt(process.env.SLEEP_LISTEN_MS || '1500', 10),
    // Base only: gap between repeats of a wake frame, and how many times the
    // sleep command itself is sent (rovers are awake then, so a few suffice).
    wakeRepeatMs: parseInt(process.env.WAKE_REPEAT_MS || '250', 10),
    sleepRepeats: 3,
  },

  // --- Scheduled shutdown (boat only) ---
  // Battery-saving: shuts THIS device down (not the boat's own power/GPS
  // hardware, just this Pi) once both a configured clock time has passed
  // AND the boat has been genuinely stationary for a sustained window - see
  // powerSchedule.js for the actual logic. The idle gate exists specifically
  // so a race running late doesn't get killed mid-track just because the
  // clock crossed shutdownAt; it waits for a real lull instead.
  // Off by default (shutdownAt null) - this is real hardware shutting
  // itself off, not something to happen without an operator deliberately
  // opting in, either via ROVER_SHUTDOWN_AT or the rover dashboard's own
  // power card. Power-up is NOT handled here - this repo has no way to know
  // what (if any) RTC-alarm/relay/smart-switch hardware a given Pi has
  // wired up to bring it back; that's on whatever's actually controlling
  // this device's power rail. Without such hardware, someone has to
  // physically re-power it before the next session either way.
  //
  // See resolveDefaultPowerSchedule above for exactly how these four
  // fields resolve between the ROVER_SHUTDOWN_* env vars and whatever's
  // persisted from a previous run/dashboard edit (power-schedule.txt, via
  // powerScheduleFile.js) - boatAgent.js only ever reads this snapshot at
  // startup; from then on the running scheduler (see powerSchedule.js's
  // startShutdownScheduler) holds the live, dashboard-editable values.
  power: resolveDefaultPowerSchedule(),

  // --- Identity & timing ---
  boatId: resolveBoatId(),
  // MARK_MODE=1 (npm run mark - see markStation.js) - this device IS one
  // specific course mark (markName below), and boatAgent.js's handlePvt
  // auto-sends a Set-Mark frame (see protocol.js's encodeSetMark) whenever
  // its own GPS position drifts markDistanceM from the last position it sent
  // for that mark - no operator action needed once assigned.
  markMode: process.env.MARK_MODE === '1',
  // Which mark this device represents under markMode above, if any (see
  // README's "Mark mode") - null is the overwhelmingly common case (plain
  // base/boat, or a markMode device not yet assigned one).
  markName: resolveMarkName(),
  // How far the assigned mark has to actually move before this device
  // sends a fresh Set-Mark frame for it (see markMode above) - same
  // distance-gated spirit as txDistanceM below, just for a
  // stationary/slow-drifting mark buoy instead of a moving boat, so
  // ordinary GPS jitter on an anchored mark doesn't key up the radio on
  // every single fix.
  markDistanceM: parseFloat(process.env.MARK_DISTANCE_M || '1'),
  // How often this device re-sends its Set-Mark frame even when the mark
  // HASN'T moved markDistanceM - same "stopped moving is the normal case,
  // not a reason to go silent" reasoning as txIntervalMs below, but for
  // the assignedBoatId/assignedAt liveness fields adminServer.js's
  // markAssignmentBadge reads (MARK_ASSIGNMENT_STALE_MS=60000 there) -
  // without this, an anchored mark buoy that's stopped drifting would look
  // "stale/offline" on the base's own map an hour into a race despite this
  // device being perfectly healthy the whole time, which is exactly
  // backwards for a warning meant to catch an operator about to fight a
  // still-live rover.
  markHeartbeatMs: parseFloat(process.env.MARK_HEARTBEAT_S || '20') * 1000,
  // How far the boat has to actually move before we transmit a new
  // position frame over the radio - distance-based, not time-based, so a
  // stopped boat doesn't keep re-sending the same fix and a fast-moving one
  // gets updates as often as its own movement warrants. GPS fixes can
  // arrive at 1-10Hz; this throttles radio TX independently to conserve
  // airtime/bandwidth over long range.
  txDistanceM: parseFloat(process.env.TX_DISTANCE_M || '1'),

  // Tightens the distance gate above to txFinishDistanceM (below) whenever
  // this boat is within this many meters of the finish line AND closing on
  // it while sailing upwind - see finishApproach.js's own module comment
  // for the exact "upwind" convention (the same committee-boat-on-the-
  // left one FinishLineWatcher already uses, so the two never disagree
  // about which side is upwind). A close finish is exactly the moment an
  // operator most wants frequent position updates, not whatever coarser
  // txDistanceM they set for the rest of the race. 0 disables this
  // entirely (txDistanceM applies everywhere, unchanged from before this
  // existed) - same "0 means off" convention as txIntervalMs below. Off by
  // default for now (0) - this fleet's actual GPS fix rate at real finish
  // speeds hasn't been validated in the field yet (see the 30mph/0.3m
  // sizing discussion - the achievable floor depends entirely on the
  // rover's own CFG-RATE-MEAS), so this stays opt-in until that's settled
  // rather than silently enabling a distance target the hardware might not
  // actually be able to hit.
  txFinishApproachZoneM: parseFloat(process.env.TX_FINISH_APPROACH_ZONE_M || '0'),
  // The tightened distance gate itself, only in effect inside
  // txFinishApproachZoneM above.
  txFinishDistanceM: parseFloat(process.env.TX_FINISH_DISTANCE_M || '0.3'),

  // How many consecutive fixes to pack into one radio transmission instead
  // of sending each as its own frame - see protocol.js's own comment on the
  // batch frame type and boatAgent.js's queueFixForTx/flushPendingBatch.
  // Trades a little latency (fixes wait to fill a batch, bounded by
  // txIntervalMs below so a slow-moving boat still can't go silent longer
  // than that) for fewer, larger over-the-air transmissions. Delta-coded frames
  // (TX_DELTA, below) fit 8 fixes in 83 bytes, under this fleet's actual, read-only
  // NP=100 max RF payload, so 8 is the default (4 before delta frames existed; the
  // real congestion-testing findings behind batching at all are in the README's
  // "Congestion-testing the radio"). Set TX_BATCH_SIZE=1 to go back to "one frame
  // per fix," this app's original behavior (boatAgent.js never even touches the
  // batch frame type at that setting). Clamped to what one frame can carry - 8 as a
  // delta frame, 4 as the older batch frame (TX_DELTA=0; protocol.js's
  // MAX_BATCH_COUNT) - not just trusted from the environment.
  txBatchSize: Math.max(1, Math.min(txDelta ? MAX_DELTA_COUNT : MAX_BATCH_COUNT, parseInt(process.env.TX_BATCH_SIZE || '8', 10) || 8)),
  // Batches go out as delta frames (protocol.js's delta batch frame): the first fix in full and each later
  // one as a change from the one before, 8 bytes instead of 19, so up to 8 fixes fit in 83 bytes. TX_DELTA=0
  // sends the older batch frame (4 fixes in 84 bytes) instead - needed only if a base that does not know
  // the delta frame yet is still in use (update the base first, then the boats).
  txDelta,

  // Heartbeat alongside txDistanceM above: even a boat that hasn't moved
  // far enough to clear the distance gate still transmits at least once
  // every this many seconds, so a stationary boat (sitting at a mooring,
  // holding on the grid) doesn't go completely silent on the base's
  // dashboard for as long as it stays still. Distance-gated sends still
  // reset this timer (see boatAgent.js's transmitFix) - it only ever fires
  // when NEITHER gate has cleared in this long, not on top of every
  // distance-triggered send too. 0 disables it (distance gate only, the
  // old behavior).
  txIntervalMs: parseFloat(process.env.TX_INTERVAL_S || '60') * 1000,

  // Boat only - how long (max, milliseconds) a boat waits after hearing a
  // ping request (see protocol.js's encodePing/boatAgent.js's radio.on
  // ('ping', ...)) before actually transmitting its response - a random
  // delay drawn fresh per ping, uniform between 0 and this value, so an
  // entire fleet doesn't all key up over each other on the same shared
  // channel at the same instant the moment they hear the request. 3s is
  // generous relative to a single frame's own airtime, cheap even for a
  // large fleet, and short enough that an operator isn't left waiting long
  // for the dashboard to reflect a stationary boat's current position.
  pingResponseJitterMs: parseInt(process.env.PING_RESPONSE_JITTER_MS || '3000', 10),
  // The Witty Pi power schedule the base admin sets for the fleet (see wittySchedule.js): the base repeats the settings this often,
  // so a boat that was powered off, or out of range, picks them up when it boots. A boat applies each version once.
  witty: {
    rebroadcastS: parseInt(process.env.WITTY_REBROADCAST_S || '60', 10),
  },

  // Boat only - max random delay (ms, uniform between 0 and this value)
  // before the FIRST hello announcement once the radio connects (see
  // boatAgent.js's startHelloAnnounce) - same reasoning as
  // pingResponseJitterMs above, applied at startup instead of per-request:
  // a whole fleet's radios connecting together (every boat powered on
  // right before a start, or npm run fleet spawning every boat process in
  // the same instant) would otherwise announce - and keep retrying every
  // HELLO_RETRY_MS - in perfect lockstep. The retry interval only starts
  // counting once this one jittered delay elapses, so each boat's own
  // retries stay offset from every other boat's indefinitely, not just on
  // the very first send.
  helloStartupJitterMs: parseInt(process.env.HELLO_STARTUP_JITTER_MS || '3000', 10),

  // How often the base station re-broadcasts the course marks to every boat
  // (base station only) - marks essentially never change mid-race, so this
  // is just a slow heartbeat for boats that missed an earlier broadcast or
  // powered on late, not a tight sync loop. Broadcast is best-effort (no
  // ACK/retry - see "Radio configuration" in the README), so a boat that
  // misses one still gets the next one a minute later.
  marksBroadcastIntervalMs: parseInt(process.env.MARKS_BROADCAST_INTERVAL_MS || '60000', 10),
  // How often the base station checks Redis for course marks edited outside it (RegattaUp writes the same keys) and
  // applies a change: new marks to the boats, the on-grid zone recalculated. 0 = never check.
  marksSyncIntervalMs: parseInt(process.env.MARKS_SYNC_INTERVAL_MS || '10000', 10),
  // Base station only - off by default (see baseStation.js's
  // broadcastMarksNow), set LOG_MARKS_BROADCAST=1 to log every broadcast.
  logMarksBroadcast: process.env.LOG_MARKS_BROADCAST === '1' || process.env.LOG_MARKS_BROADCAST === 'true',
  // Base station only - off by default, gates the `[base] boat=... lat,lon
  // ...` console line baseStation.js's logToConsole prints for every single
  // received radio frame from every boat - a full fleet at a normal GPS
  // rate floods the console fast, so this stays quiet unless asked for (set
  // LOG_RECEIVED_FIXES=1 to turn it on, e.g. while confirming frames are
  // actually arriving). Deliberately independent of everything else that
  // frame still does regardless of this flag: it's still written to this
  // base's own CSV log (logToCsv), still recorded to Redis, and still
  // checked for laps/on-grid/mark-roundings/fouls (detectRaceEvents) - this
  // only silences the routine per-fix console echo, not the actual
  // race-event detection those fixes drive.
  logReceivedFrames: process.env.LOG_RECEIVED_FIXES === '1' || process.env.LOG_RECEIVED_FIXES === 'true',
  // Base station only - off by default, set LOG_RATE_STATS=1 to print a
  // fix-rate/sync-error-rate line every 10s regardless of whether either
  // number has changed (see baseStation.js's own rate-stats interval) -
  // unlike the existing "[radio] link quality" 30s logger (which only logs
  // a CHANGE in error count, to avoid repeating an unchanging problem
  // forever), this is meant to be left running and piped to a file for a
  // field session, so a steady, unchanging rate is exactly as worth a line
  // as a changing one - the point is a time series to look back on, not a
  // live alert.
  logRateStats: process.env.LOG_RATE_STATS === '1' || process.env.LOG_RATE_STATS === 'true',

  // --- Local logging (microSD) ---
  logDir,
  // Boat's own SD-card log directory - a completely separate directory from
  // logDir above, see this const's own comment.
  boatLogDir,
  // See this const's own comment above - persisted config/state, not raw
  // log data, deliberately NOT redirectable via BASE_LOG_DIR.
  configDir,
  // CSV logs (boat SD card, base station's received-fix log) older than
  // this many days are deleted automatically - see logRotation.js. Keeps
  // an always-running base station laptop or a boat's microSD card from
  // filling up over a season of races instead of just one.
  logRetentionDays: parseInt(process.env.LOG_RETENTION_DAYS || '7', 10),
  // Boat only - how wide a slice of time each SD-card CSV covers (see
  // sdLogger.js's chunkBucket) before starting a new one. Smaller chunks
  // mean each one finishes (and becomes upload-eligible - see "upload"
  // below) sooner, at the cost of more, smaller files.
  logChunkMinutes: parseInt(process.env.LOG_CHUNK_MINUTES || '10', 10),

  // --- Log upload over WiFi (base station serves, boat sends) ---
  // Whenever a boat's own WiFi happens to reach the base station (no
  // guarantee of when, or for how long - see uploadClient.js), it pushes
  // its completed hourly SD-card logs there as a second, off-boat copy.
  // The base's address for this is broadcast alongside the course marks
  // (see protocol.js's encodeMarks) so a boat never needs to be told it
  // directly.
  upload: {
    // Base station only - port its upload-receiving HTTP server listens
    // on, and publishes in the marks broadcast.
    port: parseInt(process.env.UPLOAD_PORT || '8090', 10),
    // Base station only - where uploaded logs land, deliberately separate
    // from BASE_LOG_DIR/base-logs (that's this machine's own received-fix
    // log, not a dumping ground for every boat's SD card backup). Defaults
    // to a `base-uploads` directory next to BASE_LOG_DIR.
    dir: process.env.BASE_UPLOAD_DIR || path.join(path.dirname(logDir), 'base-uploads'),
    // Base station only - override auto-detecting this machine's own LAN
    // IP (see uploadServer.js's detectLocalIp) if it picks the wrong
    // interface, or none at all.
    baseIp: process.env.BASE_IP || null,
    // Boat only - on by default. Only gates the actual file transfer -
    // uploadClient.js's periodic health-check ping (which is how the base
    // ever learns this boat's IP/admin port at all, see
    // adminServer.js's dashboard link) always runs regardless, so turning
    // this off doesn't also make a boat invisible to the base's dashboard.
    // Set UPLOAD_ENABLED=0 to turn off just the file transfer, e.g. a
    // simulated fleet with no real SD-card logs worth pushing over WiFi.
    enabled: process.env.UPLOAD_ENABLED !== '0' && process.env.UPLOAD_ENABLED !== 'false',
    // Both roles - off by default. Gates only the one-line "uploaded"/
    // "received" console message on a successful transfer (uploadClient.js/
    // uploadServer.js) - a boat uploads a chunk every LOG_CHUNK_MINUTES for
    // the whole race, so this would otherwise print on its own timer
    // regardless of anything actually being wrong. Failures stay visible
    // either way (console.error in both files) - those are worth knowing
    // about even with this off. Set UPLOAD_LOG=1 to turn it back on.
    logSuccess: process.env.UPLOAD_LOG === '1' || process.env.UPLOAD_LOG === 'true',
    // Boat only - how often to check whether the base is currently
    // reachable and, if so, try sending one pending log file. A boat is
    // expected to drift in and out of WiFi range, so this is a cheap
    // periodic retry, not a persistent connection to maintain.
    checkIntervalMs: parseInt(process.env.UPLOAD_CHECK_INTERVAL_MS || '15000', 10),
    // Boat only - how long to wait for the base to respond (health check
    // or the upload itself) before giving up on this attempt and retrying
    // next check - keeps a boat that's just driven out of range from
    // hanging on a dead connection instead of just trying again shortly.
    timeoutMs: parseInt(process.env.UPLOAD_TIMEOUT_MS || '5000', 10),
  },

  // --- Admin dashboard (base station only) ---
  // A small live-stats web UI (src/adminServer.js) - boats seen, tracks
  // recorded, lap counts, upload activity, radio link quality. In-memory
  // only (see stats.js), so it resets on restart; not a substitute for
  // Redis/base-uploads as the durable record, just a "what's happening
  // right now" view for whoever's running the base station.
  admin: {
    port: parseInt(process.env.ADMIN_PORT || '8092', 10),
  },

  // --- Base discovery (base answers, viewer asks) ---
  // The base answers a UDP broadcast probe on this port with its hostname, version, regatta and admin port, so
  // `npm run viewer` with no address can find it on the local network (src/baseDiscovery.js). The viewer sends the
  // probes and waits timeoutMs for answers. Broadcasts don't cross routers or a VPN - give the viewer an address there.
  discovery: {
    enabled: process.env.DISCOVERY_ENABLED !== '0' && process.env.DISCOVERY_ENABLED !== 'false',
    port: parseInt(process.env.DISCOVERY_PORT || '8093', 10),
    timeoutMs: parseInt(process.env.DISCOVERY_TIMEOUT_MS || '2000', 10),
  },

  // --- Base viewer (npm run viewer) ---
  // A read-only, radio-less copy of the base dashboard's fleet page (src/baseViewer.js), fed by polling a running
  // base's GET /api/stats over HTTP - so it can run anywhere that can reach the base's admin port, to monitor a
  // race remotely. baseUrl: that base's admin address (http://pi.local:8092; a bare host gets http:// and the admin
  // port added), or empty to find a base on the local network (see discovery above); the viewer's own page is served
  // on host:port (loopback unless VIEWER_HOST says otherwise).
  viewer: {
    baseUrl: process.env.VIEWER_BASE_URL || '',
    port: parseInt(process.env.VIEWER_PORT || '8094', 10),
    host: process.env.VIEWER_HOST || '127.0.0.1',
    timeoutMs: parseInt(process.env.VIEWER_TIMEOUT_MS || '4000', 10),
  },

  // --- Redis (base station only) ---
  // Where baseStation.js records every decoded fix, so tracks can be queried
  // per-boat or across the whole fleet for a timeframe. See redisStore.js.
  //
  // REDIS_ENV picks a connection preset below (default 'local'). Credentials
  // are never hardcoded here - set REDIS_USERNAME/REDIS_PASSWORD/REDIS_TLS
  // in the environment (or a git-ignored .env) when pointing at production.
  // REDIS_URL, if set, overrides everything below for one-off/ad-hoc use.
  redis: {
    url: process.env.REDIS_URL,
    connection: REDIS_CONNECTIONS[process.env.REDIS_ENV || 'local'] || REDIS_CONNECTIONS.local,
    // A stopped/slow-moving boat reporting every couple seconds would
    // otherwise write a nearly-identical fix over and over - skip a Redis
    // write (SD/console logging is unaffected) unless the boat has moved at
    // least this far since the last one that was actually recorded.
    minMovementM: parseFloat(process.env.REDIS_MIN_MOVEMENT_M || '1'),
    // How long fixes are kept in a regatta's track: a rolling window -
    // once a minute the base drops fixes older than this and pushes the
    // key's (and boats:last's) expiry out again (see redisStore.js's
    // _keepRollingWindow), so the key holds the last 48 h of fixes and
    // never vanishes all at once mid-race. 48h by default - covers
    // reviewing a race day into the next.
    trackRetentionHours: parseFloat(process.env.REDIS_TRACK_RETENTION_HOURS || '48'),
    // The most memory a regatta's track may use: once a minute, past this the oldest fixes are dropped (see redisStore.js's
    // _capTrackSize). A race's fixes are pruned when RegattaUp archives it, but practice has no race to end, and a 30-boat
    // fleet sailing adds about 60-70 MB an hour - this keeps Redis from filling (it would evict the whole track). By size,
    // not time, so a boat or two sailing all day keep everything. 300 leaves room on the 512 MB plan for the wind, the
    // other keys and Redis's own overhead. 0 = no cap.
    trackMaxMb: Math.max(0, parseFloat(process.env.REDIS_TRACK_MAX_MB || '300') || 0),
    // The admin dashboard's "Redis memory" card divides usedBytes by this to
    // show a percentage/ALERT status, the same way the disk-space card does
    // for the filesystem - but unlike disk space, Redis has no OS syscall to
    // ask "how much room is actually left," and a managed instance (Redis
    // Cloud and similar) commonly won't even report its own configured
    // maxmemory via CONFIG GET (see redisStore.js's getMemoryInfo) - that
    // limit lives in the platform's own plan size, not a queryable Redis
    // setting. Defaults to 512 - the Redis Cloud plan this app runs on - so
    // the card shows a real percentage out of the box; override with the
    // actual plan size if it's not 512MB.
    memoryLimitMb: parseFloat(process.env.REDIS_MEMORY_LIMIT_MB || '512'),
    // How often redisStore.js sends an idle-connection keepalive PING.
    // Without real traffic, a managed instance (Redis Cloud and similar -
    // see memoryLimitMb's own comment) or whatever network sits between
    // this base and it (a NAT/firewall on the base's own WiFi/cellular link
    // included) silently drops the TCP connection after some idle period -
    // observed in production as a `read ETIMEDOUT` roughly every 12-36
    // minutes, varying with how much real Redis traffic happened to be
    // flowing (see redisStore.js's own comment on the keepalive timer for
    // the full diagnosis). ioredis's retryStrategy already recovers from
    // this cleanly (reconnects within ~3s - see redisStore.js's own
    // 'close'/'ready' logging), so this isn't fixing a failure, just
    // avoiding causing one: keeping real Redis protocol traffic flowing
    // often enough that neither end (nor anything in between) ever sees the
    // connection go idle long enough to reap it. Comfortably under the
    // shortest observed idle-to-drop window above.
    keepaliveIntervalMs: parseInt(process.env.REDIS_KEEPALIVE_INTERVAL_MS || '60000', 10),
  },

  // --- RegattaUp lap webhook (base station only) ---
  // Whenever finishLineWatcher.js (running inside baseStation.js) detects
  // an actual finish line crossing from a boat's position frames - real
  // hardware or simulated, doesn't matter - this triggers a POST so
  // RegattaUp counts the lap. Override the URL to point at a mock endpoint
  // for testing; set REGATTAUP_WEBHOOK_ENABLED=0 to skip sending entirely
  // (crossings are still detected and logged). On by default, same
  // unset-means-on convention as markRoundingEnabled/foulEnabled below.
  //
  // Every lap is durably queued (see lapWebhookQueue.js) before the first
  // send attempt and only removed once RegattaUp actually accepts it - a
  // failed attempt (RegattaUp down, network blip, a base station restart
  // mid-retry) gets retried with capped exponential backoff rather than
  // silently dropped.
  regattaup: {
    webhookUrl: process.env.REGATTAUP_WEBHOOK_URL || 'https://regattaup.com/api/functions/mylapsWebhook',
    enabled: process.env.REGATTAUP_WEBHOOK_ENABLED !== '0' && process.env.REGATTAUP_WEBHOOK_ENABLED !== 'false',
    // Base station only - the admin dashboard's regatta selector (see
    // baseStation.js's refreshActiveRegattas) fetches this list so an
    // operator can pick which regatta this base station is reporting for.
    // No auth, no body - see RegattaUp's own API docs for the response
    // shape. Deliberately NOT derived from webhookUrl above - REGATTAUP_
    // WEBHOOK_URL commonly gets overridden to a mock/staging endpoint for
    // testing the lap webhook path, and that shouldn't also redirect the
    // regatta list (real setup data an operator needs to pick from) away
    // from the real RegattaUp host. Override REGATTAUP_ACTIVE_REGATTAS_URL
    // explicitly if the regatta list itself needs to be mocked too.
    activeRegattasUrl: process.env.REGATTAUP_ACTIVE_REGATTAS_URL || 'https://regattaup.com/api/functions/getActiveRegattas',
    // Which regatta to auto-select at startup if none is already active in
    // Redis (see baseStation.js's own startup block and selectRegatta) - an
    // { id, name, defaultLat, defaultLon, venue, startDate, endDate } object,
    // or null. REGATTAUP_REGATTA_ID always wins when
    // set, and gets persisted to regatta-id.txt right away so it becomes
    // the new default even without the env var on later runs; otherwise
    // falls back to whatever's already in that file (see regattaIdFile.js),
    // most recently written either by a prior REGATTAUP_REGATTA_ID or by an
    // operator's own pick from the admin dashboard's dropdown or the
    // startup terminal prompt. null (not an error) when neither exists -
    // the existing "no regatta selected" startup behavior (now: prompt
    // interactively, or warn if not possible) is unchanged in that case.
    // This is a DEFAULT, not a hard override - it's only ever applied when
    // Redis has nothing currently selected, never used to clobber an
    // already-active selection (e.g. one still valid from this same base's
    // last run).
    defaultRegatta: resolveDefaultRegattaId(),
    // NO_REGATTA=1 - base station only, skips regatta auto-selection
    // (defaultRegatta above, the interactive terminal prompt, and the
    // closest-active-date auto-pick) entirely for this run, so it comes up
    // with none selected and stays there unless an operator overrides it
    // from the admin dashboard's own dropdown. Built for radio-congestion/
    // bench testing (see README's "Congestion-testing the radio") - with
    // no regatta selected, the base ignores every received fix outright
    // (see baseStation.js's radio.on('frame', ...) guard), so synthetic
    // test traffic never gets written into Redis or reported to RegattaUp
    // under a real regatta. Never persisted anywhere (unlike
    // REGATTAUP_REGATTA_ID above) - it only ever changes THIS run's own
    // startup behavior, on purpose, so a later run without the env var set
    // goes right back to auto-selecting normally.
    noRegatta: process.env.NO_REGATTA === '1' || process.env.NO_REGATTA === 'true',
    // How often that list is refreshed in the background - regattas
    // essentially never change mid-race, so this is just a slow heartbeat
    // (pick up a newly published regatta, notice the selected one has
    // ended) rather than a tight sync loop.
    activeRegattasRefreshIntervalMs: parseInt(process.env.REGATTAUP_REGATTAS_REFRESH_INTERVAL_MS || '300000', 10), // 5 minutes
    // Off by default - a successful fetch is the expected, ordinary
    // outcome of a background heartbeat that runs indefinitely (every
    // activeRegattasRefreshIntervalMs), so logging one every time is just
    // scroll, not signal. A failed fetch still always logs (see
    // refreshActiveRegattas' own console.error) regardless of this flag -
    // that's the actual actionable case. Set REGATTAUP_LOG_ACTIVE_REGATTAS=1
    // to see the routine success line too, e.g. while confirming a mocked
    // REGATTAUP_ACTIVE_REGATTAS_URL is actually being hit on schedule.
    logActiveRegattas: process.env.REGATTAUP_LOG_ACTIVE_REGATTAS === '1' || process.env.REGATTAUP_LOG_ACTIVE_REGATTAS === 'true',
    queueDbPath: process.env.REGATTAUP_QUEUE_DB || path.join(configDir, 'lap_webhook_queue.sqlite'),
    // Every lap/on-grid/mark-rounding event is always queued first (see
    // baseStation.js's enqueueLap/OnGrid/MarkRounding), never POSTed
    // straight away - a single shared loop then drains at most one POST
    // per tick of this interval, across all three queues combined. Without
    // this, a burst of events arriving close together (a full fleet all
    // going on-grid within the same second, or a backlog of failed sends
    // all becoming retry-eligible at once) would fire that many concurrent
    // requests at RegattaUp with nothing pacing them. Same approach as the
    // sister p3-bridge project's own PostQueue (500ms default there too).
    // Replaces the old REGATTAUP_RETRY_INTERVAL_MS, which only paced
    // re-attempts of already-failed sends - this paces EVERY send,
    // including each event's very first attempt.
    postIntervalMs: parseInt(process.env.REGATTAUP_POST_INTERVAL_MS || '500', 10),
    // At most this many webhook requests outstanding at once, across all four queues (REGATTAUP_MAX_IN_FLIGHT), and a request still
    // unanswered after requestTimeoutMs is abandoned and retried later (REGATTAUP_REQUEST_TIMEOUT_MS). Without a cap, a slow RegattaUp
    // (its database timing out) was sent a new request every postIntervalMs on top of those still waiting.
    maxInFlight: Math.max(1, parseInt(process.env.REGATTAUP_MAX_IN_FLIGHT || '3', 10) || 3),
    requestTimeoutMs: Math.max(1000, parseInt(process.env.REGATTAUP_REQUEST_TIMEOUT_MS || '30000', 10) || 30000),
    maxBackoffMs: parseInt(process.env.REGATTAUP_MAX_BACKOFF_MS || '300000', 10), // 5 minutes
    // On-grid detection (see onGridWatcher.js): how close a boat has to be
    // to the pin<->committeeStart (start) line, while still between the two
    // marks, to count as "on-grid" - an ongrid/offgrid webhook fires on
    // each transition. Same enabled/retry/backoff settings as laps above
    // (REGATTAUP_WEBHOOK_ENABLED=0 also disables this), but its own queue
    // file - see onGridWebhookQueue.js's module comment for why it can't
    // just share lap_webhook_queue.sqlite.
    onGridZoneM: parseFloat(process.env.REGATTAUP_ONGRID_ZONE_M || '10'),
    onGridQueueDbPath: process.env.REGATTAUP_ONGRID_QUEUE_DB || path.join(configDir, 'ongrid_webhook_queue.sqlite'),
    // Mark-rounding detection (see markRoundingWatcher.js): reports a
    // 'mark' webhook whenever a boat crosses the virtual gate extending
    // markRoundingExtensionM beyond a windward/leeward mark. On by default,
    // same as laps and on-grid - set REGATTAUP_MARK_ROUNDING_ENABLED=0 to
    // turn it off, independent of the overall REGATTAUP_WEBHOOK_ENABLED
    // switch (which still gates it too - both must allow it for it to send).
    markRoundingEnabled: process.env.REGATTAUP_MARK_ROUNDING_ENABLED !== '0' && process.env.REGATTAUP_MARK_ROUNDING_ENABLED !== 'false',
    // Generous by default - there's no real downside to a longer gate (see
    // markRoundingWatcher.js's module comment: it only extends *along the
    // course axis*, so it stays far too short to be crossed by ordinary
    // tacking/gybing well short of the mark, no matter how long).
    markRoundingExtensionM: parseFloat(process.env.REGATTAUP_MARK_ROUNDING_EXTENSION_M || '50'),
    markRoundingQueueDbPath:
      process.env.REGATTAUP_MARK_ROUNDING_QUEUE_DB || path.join(configDir, 'mark_rounding_webhook_queue.sqlite'),
    // Foul detection (see foulWatcher.js): reports a 'foul' webhook whenever
    // a boat's path crosses the start line, the finish line the wrong way
    // (downwind), or passes between the two committee boats at all. On by
    // default, same as laps/on-grid/mark-rounding - set
    // REGATTAUP_FOUL_ENABLED=0 to turn it off, independent of the overall
    // REGATTAUP_WEBHOOK_ENABLED switch (which still gates it too - both
    // must allow it for it to send).
    foulEnabled: process.env.REGATTAUP_FOUL_ENABLED !== '0' && process.env.REGATTAUP_FOUL_ENABLED !== 'false',
    foulQueueDbPath: process.env.REGATTAUP_FOUL_QUEUE_DB || path.join(configDir, 'foul_webhook_queue.sqlite'),
    // New transponder codes (see codeAnnouncer.js): the first time a boat id is seen in the selected regatta (a fix or a
    // hello, once more after each base restart) the base sends an 'info' webhook with it as tranCode, so RegattaUp lists the code in its code management to be assigned
    // to a boat. On by default, same as the other events - set REGATTAUP_NEW_CODE_ENABLED=0 to turn it off,
    // independent of the overall REGATTAUP_WEBHOOK_ENABLED switch (which still gates it too).
    newCodeEnabled: process.env.REGATTAUP_NEW_CODE_ENABLED !== '0' && process.env.REGATTAUP_NEW_CODE_ENABLED !== 'false',
    newCodeQueueDbPath: process.env.REGATTAUP_NEW_CODE_QUEUE_DB || path.join(configDir, 'new_code_webhook_queue.sqlite'),
  },

  // --- Local UDP broadcast (base and boat both) ---
  // Every fix each process itself decodes/produces is also re-broadcast on
  // the local LAN, unthrottled (every fix, not gated by txDistanceM like
  // the long-range radio TX) - meant for onboard/dockside instruments
  // (chartplotters, a laptop running OpenCPN, u-center) to pick up
  // directly, independent of the race-tracking path above. Base and boat
  // share these settings so anything listening doesn't need to know which
  // one it's hearing from.
  localBroadcast: {
    // 'ubx' (default) re-emits a synthetic UBX-NAV-PVT message (see
    // ubxParser.js's encodeNavPvt) - the same format the GPS receiver
    // itself speaks, so anything that already parses UBX (u-center, this
    // app) can read it directly, and it carries fields (fix type, DOP,
    // accuracy estimates) plain NMEA GGA can't. Set
    // GPS_OUTPUT_FORMAT=nmea for a standard $GPGGA sentence instead, for
    // tools that only speak NMEA.
    format: (process.env.GPS_OUTPUT_FORMAT || 'ubx').toLowerCase(),
    address: process.env.UDP_BROADCAST_ADDR || '255.255.255.255',
    port: parseInt(process.env.UDP_PORT || '10110', 10), // 10110 is the conventional NMEA-over-UDP port
  },

  // Base station only - a Tempest (WeatherFlow) weather station's local UDP
  // broadcast, recorded as the selected regatta's wind series in Redis (see
  // tempestListener.js). On by default: with no Tempest on the network it
  // just never hears anything. TEMPEST_SERIAL (e.g. ST-00012345) keeps one
  // station's messages when more than one is on the network;
  // TEMPEST_STATION_NAME is the station name stored with each sample (what
  // RegattaUp's map shows), defaulting to the serial number.
  tempest: {
    enabled: process.env.TEMPEST_ENABLED !== '0' && process.env.TEMPEST_ENABLED !== 'false',
    port: parseInt(process.env.TEMPEST_PORT || '50222', 10),
    serial: process.env.TEMPEST_SERIAL || null,
    stationName: process.env.TEMPEST_STATION_NAME || null,
  },
};
