sdale511/race-tracker/src/radioLink.js

const { SerialPort } = require('serialport');
const { EventEmitter } = require('events');
const { execFile } = require('child_process');
const protocol = require('./protocol');
const { setNodeIdentifier } = require('./xbeeAt');

// Wraps the telemetry radio's UART. Assumes a transparent-serial radio
// (RFD900x/SiK-style): bytes written here are transmitted over the air and
// arrive byte-for-byte at the matching radio on the other end. No radio-
// specific framing needed on our side; we handle framing at the app layer
// with protocol.js.
class RadioLink extends EventEmitter {
  constructor({ port, baud, sleepGpio = null, nodeIdentifier = null }) {
    super();
    this.portPath = port;
    this.baud = baud;
    // BCM number of the Pi GPIO wired to the XBee's SLEEP_RQ pin (pin 9), or
    // null when it isn't wired - see README's "Radio sleep wiring". The
    // XBee must also be set to SM=1 (pin sleep) for the pin to do anything.
    this.sleepGpio = sleepGpio;
    this._sleeping = false;
    if (this.sleepGpio !== null) this._driveSleepPin(false); // start awake, whatever the pin was left at
    this._buf = Buffer.alloc(0);
    // True once the local serial write buffer has room - see send() below.
    // A fresh SerialPort (initial connect, or any reconnect via _open())
    // always starts with an empty write buffer, so this resets to true
    // there too, not just in the constructor.
    this._writable = true;
    // The XBee node identifier (NI) to set when the port first opens, or null - see _setNodeIdentifier below. Emits
    // 'node-identifier' with the outcome; while it runs, send() refuses and incoming bytes go to it, not the frame parser.
    this._nodeIdentifier = nodeIdentifier;
    this._atBusy = false;
    this._atListener = null;
    this._open();
  }

  _open() {
    this._writable = true;
    this.port = new SerialPort({ path: this.portPath, baudRate: this.baud }, (err) => {
      if (err) {
        this.emit('error', err);
        this._scheduleReconnect();
      }
    });

    // Standard serialport event, fired once the port has actually opened
    // successfully - distinct from the constructor callback above, which
    // only ever fires on the *error* path. Lets a caller (see
    // baseStation.js's dashboard connection-status tracking) tell "opened
    // fine" apart from "still trying" without polling anything.
    this.port.on('open', () => {
      if (this._nodeIdentifier === null) return this.emit('connected');
      this._setNodeIdentifier().then(() => {
        if (this.port.isOpen) this.emit('connected'); // a port that closed meanwhile has already said 'disconnected'
      });
    });
    this.port.on('data', (chunk) => (this._atListener ? this._atListener(chunk) : this._onData(chunk)));
    this.port.on('close', () => {
      this.emit('disconnected');
      this._scheduleReconnect();
    });
    this.port.on('error', (err) => this.emit('error', err));
    // SerialPort is a standard Node Writable stream - 'drain' is the
    // built-in signal that its internal buffer has room again after
    // write() reported it was full (see send() below).
    this.port.on('drain', () => {
      this._writable = true;
    });
  }

  // Once per process (the first open; a reconnect doesn't repeat it): set the XBee's NI over AT command mode. 'connected'
  // waits for it, so nothing is sent in command mode, which would turn telemetry bytes into AT commands.
  async _setNodeIdentifier() {
    const ni = this._nodeIdentifier;
    this._nodeIdentifier = null;
    this._atBusy = true;
    const port = this.port;
    const io = {
      write: (text) => port.write(text),
      onData: (cb) => {
        this._atListener = cb;
        return () => {
          if (this._atListener === cb) this._atListener = null;
        };
      },
    };
    try {
      this.emit('node-identifier', { wanted: ni, ...(await setNodeIdentifier(io, ni)) });
    } finally {
      this._atListener = null;
      this._atBusy = false;
    }
  }

  get canSleep() {
    return this.sleepGpio !== null;
  }

  // Powers the XBee down (SLEEP_RQ high) or back up (low) - see
  // roverSleep.js. While asleep the module can't receive RF or read the
  // UART, so send() refuses rather than handing it bytes that would be
  // lost. Uses Raspberry Pi OS's `pinctrl` tool (no native GPIO dependency);
  // that's untested on real hardware as of this writing, same as the
  // simulator-first rollout of the sleep feature as a whole.
  setSleeping(sleeping) {
    if (this.sleepGpio === null) return;
    this._sleeping = !!sleeping;
    this._driveSleepPin(this._sleeping);
  }

  _driveSleepPin(high) {
    execFile('pinctrl', ['set', String(this.sleepGpio), 'op', high ? 'dh' : 'dl'], (err) => {
      if (err) this.emit('error', new Error(`could not drive SLEEP_RQ on GPIO${this.sleepGpio}: ${err.message}`));
    });
  }

  _scheduleReconnect() {
    if (this._reconnecting) return;
    this._reconnecting = true;
    setTimeout(() => {
      this._reconnecting = false;
      this._open();
    }, 3000);
  }

  // Real RF congestion (collisions, a saturated shared channel) doesn't
  // close the serial port - the radio just can't drain what we hand it as
  // fast as we hand it. Checking _writable BEFORE writing (not just
  // write()'s own return value afterward) is what actually matters: without
  // it, every gate-cleared fix keeps getting queued on top of an already-
  // backed-up buffer, so stale data sits ahead of fresh data and gets
  // transmitted first once the radio finally catches up - exactly the wrong
  // priority under congestion. Returning false here instead makes a
  // congested link fail the exact same way a closed port already does, so
  // callers' existing "didn't send, just try again with whatever's current
  // next time" behavior (see boatAgent.js's transmitFix/flushPendingBatch)
  // covers congestion too, not just a literally-disconnected radio.
  send(buf) {
    if (this._sleeping) return false; // radio powered down - see setSleeping()
    if (this._atBusy) return false; // in AT command mode setting the node identifier - see _setNodeIdentifier()
    if (!this.port || !this.port.isOpen) return false;
    if (!this._writable) return false; // still draining a backed-up buffer - don't pile more on top of it
    if (!this.port.write(buf)) this._writable = false; // this write itself filled the buffer - wait for 'drain'
    // Only bytes actually handed to the port count - a skipped/backed-up
    // send above never reaches here, so this is real bandwidth used, not
    // just attempted. See baseStation.js's own bandwidth card (accumulates
    // this into a rolling per-second history for the dashboard).
    this.emit('bytes', { tx: buf.length });
    return true;
  }

  // A real radio's transmission already reaches every other radio on the
  // network - that's what "broadcast" means at this layer (see the class
  // comment) - so this is just send() under another name. It exists so
  // call sites (e.g. baseStation.js's mark broadcast) can use the same
  // method name on either a real RadioLink or a SimRadioLink, where send()
  // and broadcast() are genuinely different operations (see simRadioLink.js).
  broadcast(buf) {
    return this.send(buf);
  }

  // These frame types share this one byte stream (position frames,
  // boat->base; mark broadcasts, base->boats; ping requests, base->boats;
  // hello announcements (plain, and with the rover's diagnosis), boat->base; batched position frames, boat->base;
  // set-mark requests, boat->base; mark-log notes, boat->base; sleep/wake
  // commands, base->boats; transmit-slot tables, base->boats - see protocol.js's own comment on each)
  // - each with its own sync byte, since a single radio link hears
  // everything broadcast on the network, not just frames addressed to
  // "me". Every type but the batch one has a fixed `len`; the batch
  // frame's length depends on how many fixes it carries, so it supplies
  // `getLen(buf)` instead - see below.
  static FRAME_TYPES = [
    { sync: protocol.SYNC, len: protocol.FRAME_LEN, decode: protocol.decode, event: 'frame' },
    { sync: protocol.MARKS_SYNC, len: protocol.MARKS_FRAME_LEN, decode: protocol.decodeMarks, event: 'marks' },
    { sync: protocol.PING_SYNC, len: protocol.PING_FRAME_LEN, decode: protocol.decodePing, event: 'ping' },
    { sync: protocol.POWER_SCHEDULE_SYNC, len: protocol.POWER_SCHEDULE_FRAME_LEN, decode: protocol.decodePowerSchedule, event: 'power-schedule' },
    { sync: protocol.HELLO_SYNC, len: protocol.HELLO_FRAME_LEN, decode: protocol.decodeHello, event: 'hello' },
    { sync: protocol.STATUS_HELLO_SYNC, len: protocol.STATUS_HELLO_FRAME_LEN, decode: protocol.decodeStatusHello, event: 'hello' },
    { sync: protocol.STATUS_HELLO_BATTERY_SYNC, len: protocol.STATUS_HELLO_BATTERY_FRAME_LEN, decode: protocol.decodeStatusHello, event: 'hello' },
    { sync: protocol.BATCH_SYNC, getLen: protocol.batchFrameLenFromHeader, decode: protocol.decodeBatch, event: 'frame-batch' },
    { sync: protocol.SET_MARK_SYNC, len: protocol.SET_MARK_FRAME_LEN, decode: protocol.decodeSetMark, event: 'set-mark' },
    { sync: protocol.MARK_LOG_SYNC, len: protocol.MARK_LOG_FRAME_LEN, decode: protocol.decodeMarkLog, event: 'mark-log' },
    { sync: protocol.POWER_SYNC, getLen: protocol.powerFrameLenFromHeader, decode: protocol.decodePower, event: 'power' },
    { sync: protocol.DELTA_SYNC, getLen: protocol.deltaFrameLenFromHeader, decode: protocol.decodeDeltaBatch, event: 'frame-batch' },
    { sync: protocol.SLOT_TABLE_SYNC, getLen: protocol.slotTableFrameLenFromHeader, decode: protocol.decodeSlotTable, event: 'slot-table' },
    { sync: protocol.RTCM_SYNC, getLen: protocol.rtcmFrameLenFromHeader, decode: protocol.decodeRtcm, event: 'rtcm' },
  ];

  // Used on both ends: scans incoming bytes for valid frames of either type.
  _onData(chunk) {
    // Every byte that actually arrived over the air, whether it ends up
    // part of a valid frame or gets dropped resyncing past a corrupted one
    // - real airtime used either way. See send()'s own 'bytes' emit above.
    this.emit('bytes', { rx: chunk.length });
    this._buf = Buffer.concat([this._buf, chunk]);
    while (this._buf.length > 0) {
      // Whichever known sync byte appears earliest decides which frame type
      // we're expecting next.
      let syncIdx = -1;
      let frameType = null;
      for (const type of RadioLink.FRAME_TYPES) {
        const idx = this._buf.indexOf(type.sync);
        if (idx !== -1 && (syncIdx === -1 || idx < syncIdx)) {
          syncIdx = idx;
          frameType = type;
        }
      }
      if (syncIdx === -1) {
        this._buf = Buffer.alloc(0);
        break;
      }
      if (syncIdx > 0) this._buf = this._buf.slice(syncIdx);

      // Fixed-length types know `len` up front; the batch type has to read
      // a header byte first (getLen returns null if even that isn't in
      // hand yet - wait for more data, same as the plain "wait for the
      // rest of this frame" case below).
      const len = typeof frameType.len === 'number' ? frameType.len : frameType.getLen(this._buf);
      if (len === null || this._buf.length < len) break; // wait for the rest of this frame

      const candidate = this._buf.slice(0, len);
      const decoded = frameType.decode(candidate);
      if (decoded) {
        this.emit('raw-frame', candidate); // the frame's own bytes, for fleetSim.js's RF bridge to hand to its simulated boats
        this.emit(frameType.event, decoded);
        this._buf = this._buf.slice(len);
      } else {
        // Bad checksum/false sync match - drop one byte and resync. Emitted
        // as its own event (not just silently dropped) since a rising rate
        // of these is a real, passive signal-quality indicator: a
        // corrupted-but-still-sync-byte-shaped frame here usually means bit
        // errors from a degrading RF link, without needing to interrupt the
        // data stream to query the radio directly for RSSI.
        this.emit('sync-error');
        this._buf = this._buf.slice(1);
      }
    }
  }
}

module.exports = { RadioLink };
