sdale511/race-tracker/src/boatAgent.js

require('./logTimestamps');
const { SerialPort } = require('serialport');
const { EventEmitter } = require('events');
const fs = require('fs');
const path = require('path');
const dgram = require('dgram');
const util = require('util');
const { versionLine, VERSION } = require('./version');
const config = require('./config');
const logBuffer = require('./logBuffer');
const { UbxParser, encodeNavPvt, encodePollRequest, CLASS_NAV, ID_NAV_SIG } = require('./ubxParser');
const { summarizeSignals } = require('./gnssSignals');
const { toGGA } = require('./nmea');
const { RadioLink } = require('./radioLink');
const { SdLogger } = require('./sdLogger');
const { pruneForDiskSpace } = require('./logRotation');
const protocol = require('./protocol');
const { distanceMeters, distanceToSegmentM, MARK_NAMES } = require('./course');
const { DistanceGate } = require('./distanceGate');
const { RtcmWatchdog } = require('./rtcmWatchdog');
const { EventBoost } = require('./eventBoost');
const { orange } = require('./consoleColor');
const { FinishApproachWatcher, headingUpwind } = require('./finishApproach');
const { startUploadClient, countPending } = require('./uploadClient');
const { startRoverAdminServer } = require('./roverAdminServer');
const { RoverSleep } = require('./roverSleep');
const { GpsSleep } = require('./gpsSleep');
const { createRtcmLogger } = require('./rtcmLog');
const { BurstTracker } = require('./burstTracker');
const { TxGate } = require('./txGate');
const { TxScheduler, airMs } = require('./txScheduler');
const { SlotTableFollower, ZoneState, ParkedReporter, JoinBackoff, autoSlotCount } = require('./slotTable');
const { OnGridWatcher } = require('./onGridWatcher');
const { thinForTurns, thinBackfill } = require('./thinFixes');
const roverStats = require('./roverStats');
const roverDiag = require('./roverDiag');
const { persistMarkName, clearPersistedMarkName } = require('./markNameFile');
const { getDiskSpace, CRITICAL_BELOW_PCT } = require('./diskSpace');
const { startShutdownScheduler } = require('./powerSchedule');
const wittySchedule = require('./wittySchedule');
const fleetShutdown = require('./fleetShutdown');

// True while the cursor is sitting mid-line after an in-place GPS log
// overwrite (see handlePvt's inPlaceMode) - any *other* log call landing
// while that's true would otherwise get silently tacked onto the end of
// that same line instead of starting its own, since nothing else in this
// process knows the cursor isn't at column 0. Wrapping console.log/warn/
// error here (rather than auditing every call site across this file and
// every module it pulls in - radioLink, uploadClient, roverStats, ...) is
// the only way to catch all of them, including ones added later. warn/
// error are included too, not just log - stdout and stderr both render to
// the same physical terminal, so either can land on that dirty line. Same
// choke point also feeds logBuffer (see its own comment) - every line this
// process ever logs passes through here exactly once, so it's the one
// place that can capture them all for the rover dashboard's "Console" page
// without auditing every call site a second time.
let gpsLineDirty = false;
for (const method of ['log', 'warn', 'error']) {
  const original = console[method].bind(console);
  console[method] = (...args) => {
    if (gpsLineDirty) {
      process.stdout.write('\n');
      gpsLineDirty = false;
    }
    original(...args);
    logBuffer.push(util.format(...args));
  };
}

// Short labels for the rover admin dashboard (see getRoverStats below).
const gpsMode = config.noGps ? 'none' : config.simulateGps ? 'simulated' : 'real';
// RF_BRIDGE=1 (set by fleetSim.js, `npm run fleet-rf`): this simulated boat has no radio of its own - it shares its parent's one real
// radio over IPC, so what it sends really goes out on air. Reported as a real radio.
const rfBridged = config.simulate && process.env.RF_BRIDGE === '1' && typeof process.send === 'function';
const radioMode = rfBridged ? 'real' : config.simulate ? 'simulated' : config.radio.enabled ? 'real' : 'none';
// True whenever a radio link is actually expected to come up at all (real
// or simulated) - RADIO_ENABLED=0 is the only case this is false. Reused
// by transmitFix (below) and the status summary (further down) so "is the
// radio genuinely down" and "there's deliberately no radio" never drift
// out of sync between the two.
const radioExpected = config.simulate || config.radio.enabled;

// This boat's own admin dashboard port. In SIMULATE mode, defaults to a
// different port than the base's own dashboard (config.admin.port, 8092)
// so `npm run base` and `npm run boat` can run on the same machine without
// an EADDRINUSE - a real deployment always has these on separate machines,
// so config.admin.port's default is fine as-is there. An explicit
// ADMIN_PORT env var always wins, on either side.
const myAdminPort = process.env.ADMIN_PORT ? config.admin.port : config.simulate ? 8093 : config.admin.port;

// One consolidated startup summary of the settings that actually matter
// for "is this boat configured the way I expect," printed together right
// up front - instead of scattered one-line-each prints interleaved with
// unrelated setup code further down this file, which made them easy to
// miss and hard to compare against each other at a glance.
console.log(`[boatAgent] boatId=${config.boatId}, race-tracker ${versionLine()}`);
// Boat mode only (not a mark device): the XBee's node identifier (NI) is set to the boat id when the radio
// port opens, so a radio taken out of a boat, or listed by XCTU, says which boat it is - see radioLink.js/xbeeAt.js.
const xbeeNodeIdentifier = !config.simulate && config.radio.enabled && !config.markMode ? config.boatId : null;
if (xbeeNodeIdentifier !== null) {
  console.log(`[boatAgent] xbee node identifier (NI): setting to "${xbeeNodeIdentifier}" when ${config.radio.port} opens`);
}
console.log(
  `[boatAgent] gps=${gpsMode}` +
    (gpsMode === 'real'
      ? ` ${config.gps.port}@${config.gps.baud}`
      : gpsMode === 'simulated'
      ? config.simulate
        ? ' (no GPS hardware)'
        : ' (real radio hardware)'
      : ' (NO_GPS=1)')
);
console.log(
  `[boatAgent] radio=${radioMode}` +
    (radioMode === 'real'
      ? rfBridged
        ? " shared with the other simulated boats of this fleet (RF_BRIDGE: the fleet's one real radio)"
        : ` ${config.radio.port}@${config.radio.baud}`
      : radioMode === 'simulated'
      ? ` udp:${config.sim.port}`
      : ' (RADIO_ENABLED=0, fixes still log to SD)') +
    ` txDistance=${config.txDistanceM}m txInterval=${config.txIntervalMs / 1000}s`
);
console.log(
  `[boatAgent] dashboard=http://localhost:${myAdminPort} ` +
    `localBroadcast=${config.localBroadcast.format.toUpperCase()}:${config.localBroadcast.address}:${config.localBroadcast.port} ` +
    `upload=${config.upload.enabled ? 'on' : 'off'}`
);

// config.boatLogDir (default boat-logs/, see config.js's own comment) - a
// completely separate directory from the base's own BASE_LOG_DIR (base-logs/),
// not a subdirectory of it, so the two never end up sharing a directory
// even when both roles happen to run from the same checkout on the same
// machine. Every other boatLogDir consumer below (pruneForDiskSpace,
// startUploadClient, countPending, getDiskSpace) has to agree on this same
// directory, or they'd end up scanning/uploading from the wrong place
// entirely.
const sdLogger = new SdLogger({
  logDir: config.boatLogDir,
  boatId: config.boatId,
  retentionDays: config.logRetentionDays,
  chunkMinutes: config.logChunkMinutes,
});

// Emergency last resort if LOG_RETENTION_DAYS's normal age-based pruning
// (above, run by SdLogger itself on every chunk rollover) still isn't
// enough to keep this boat's SD card from filling up - see
// logRotation.js's own comment on pruneForDiskSpace. On its own timer
// rather than only checked at chunk rollover, since a chunk boundary is up
// to LOG_CHUNK_MINUTES away and a genuinely full disk needs a much
// tighter check than that.
setInterval(
  () => pruneForDiskSpace(config.boatLogDir, /^boat[A-Za-z0-9]+_.*\.csv$/, CRITICAL_BELOW_PCT),
  60000
);

// Local UDP broadcast of this boat's own fixes - onboard instruments
// (chartplotter, a laptop running OpenCPN, u-center) on the same LAN can
// pick this up directly, independent of the long-range radio TX to the
// base station below. Runs unthrottled (every fix, not gated by
// TX_DISTANCE_M like the radio) since it's a local broadcast, not
// bandwidth-constrained long-range airtime. Same format choice and
// UDP_BROADCAST_ADDR/UDP_PORT settings as baseStation.js's own copy of
// this - see config.js's localBroadcast.
const localBroadcastSocket = dgram.createSocket('udp4');
localBroadcastSocket.bind(() => localBroadcastSocket.setBroadcast(true));

function outputLocalFrame(pvt) {
  const buf = config.localBroadcast.format === 'nmea' ? Buffer.from(toGGA(pvt) + '\r\n') : encodeNavPvt(pvt);
  localBroadcastSocket.send(buf, config.localBroadcast.port, config.localBroadcast.address);
}

let radio;
// Tracked for the periodic status summary (further down) - starts false
// rather than assuming connected, so a boat that never reaches 'connected'
// at all (still trying, or genuinely broken) reports "down" instead of a
// misleadingly optimistic default. Stays permanently false under
// RADIO_ENABLED=0, which never emits 'connected' at all - fine, since
// radioExpected (above) is what the status summary actually checks first.
let radioConnected = false;

// send() now returns false for two different reasons (see radioLink.js's
// own comment on _writable): the port isn't open at all, or it IS open but
// its local write buffer is still draining a backlog - real RF congestion,
// not a disconnect. radioConnected above is exactly what tells these apart:
// if it's true and send() still failed, a backed-up buffer is the only
// remaining explanation. Used by every dropped-frame warning below, so the
// message actually points an operator at the right thing to check (a
// cable/port problem vs. a congested link) instead of always blaming "not
// connected" regardless of which one it really was.
function radioDropReason() {
  if (sleeper.isSleeping()) return 'asleep (radio sleep mode)';
  return radioConnected ? 'backed up (congested link?)' : 'not connected';
}

if (config.simulate) {
  // rfBridged (above): this simulated boat shares its parent's one real radio, over IPC, instead of the UDP stand-in
  radio = rfBridged
    ? new (require('./ipcRadioLink').IpcRadioLink)()
    : new (require('./simRadioLink').SimRadioLink)({
        port: config.sim.port,
        packetLossPct: config.sim.packetLossPct,
      });
  radio.on('error', (err) => console.error('[radio] error:', err.message));
  radio.on('connected', () => { radioConnected = true; startHelloAnnounce(); });
  radio.on('disconnected', () => { radioConnected = false; console.warn('[radio] disconnected, retrying...'); });
} else if (config.radio.enabled) {
  radio = new RadioLink({
    port: config.radio.port,
    baud: config.radio.baud,
    sleepGpio: config.radio.sleepGpio,
    nodeIdentifier: xbeeNodeIdentifier,
  });
  radio.on('node-identifier', ({ wanted, ok, previous, changed, error }) => {
    if (!ok) console.warn(`[radio] could not set the xbee node identifier (NI) to "${wanted}": ${error} - carrying on`);
    else if (changed) console.log(`[radio] xbee node identifier (NI) set to "${wanted}" (was "${previous}") and saved`);
    else console.log(`[radio] xbee node identifier (NI) already "${wanted}"`);
  });
  radio.on('error', (err) => console.error('[radio] error:', err.message));
  radio.on('connected', () => { radioConnected = true; startHelloAnnounce(); });
  radio.on('disconnected', () => { radioConnected = false; console.warn('[radio] disconnected, retrying...'); });
} else {
  radio = new EventEmitter(); // RADIO_ENABLED=0 - never emits 'frame'/'marks', other outputs still testable
  radio.send = () => false;
}

// Radio sleep mode (see roverSleep.js): the base can put this rover's radio to
// sleep and wake it again with a power frame. The GPS board sleeps with it (see
// gpsSleep below), so nothing is logged to SD or transmitted until it wakes.
const sleeper = new RoverSleep({ radio, listenMs: config.sleep.listenMs, defaultCycleS: config.sleep.cycleS });
radio.on('power', (frame) => sleeper.handlePower(frame, config.boatId));

// The GPS board sleeps along with the radio (see gpsSleep.js) - for its whole
// sleep, not each listen window. `gpsSerial` is the real GPS's open serial
// port (set by openGps), which GpsSleep writes its backup/wake commands to.
let gpsSerial = null;
const gpsSleep = new GpsSleep({
  mode: gpsMode,
  write: (buf) => !!gpsSerial && gpsSerial.isOpen && gpsSerial.write(buf),
  forceUsb: config.sleep.gps.forceUsb,
  simWakeDelayMs: config.sleep.gps.simWakeDelayMs,
});
// True from a wake until the first fresh fix has been reported - the stale
// pre-sleep fix mustn't be sent as if it were current.
let announceNextFix = false;

// Every fix from the GPS source (real or simulated) comes through here: while
// the GPS sleeps (or is still reacquiring) it's dropped, and the first fresh
// fix after a wake is sent immediately instead of waiting for the movement gate.
function onGpsFix(pvt) {
  diagState.lastPvtAt = Date.now();
  diagPvt = pvt;
  if (gpsSleep.shouldDrop(pvt, { valid: hasValidFix(pvt), rtkFixed: pvt.carrSoln === 2 })) return;
  handlePvt(pvt);
  if (announceNextFix && hasValidFix(pvt) && !sleeper.isSleeping()) {
    announceNextFix = false;
    if (pendingBatch.length) flushPendingBatch();
    else if (lastTxTime !== pvt.timestamp) transmitFix(pvt);
  }
}
// Nothing transmits while the rover is in sleep mode - including during a
// listen window, when the radio is physically up but only to hear a wake
// frame. Enforced here, once, rather than relying on every send call site.
const rawRadioSend = radio.send.bind(radio);
radio.send = (buf) => (sleeper.isSleeping() ? false : rawRadioSend(buf));

// Shared-radio transmit scheduling (see txScheduler.js): when the base's RTCM correction bursts
// are heard on this radio, keep writes clear of them and - in TX_SLOT_MODE - send in this boat's
// own slot. Does nothing while no bursts are heard, so a separate correction radio (or no base)
// behaves exactly as before.
const burstTracker = new BurstTracker();
let txScheduler = null;
let slotFollower = null;
if (config.txGate.enabled && radioExpected) {
  // Slot mode: pinned (TX_SLOT) to a slot by hand, or - until the base's slot table assigns one - sharing the
  // last few "join" slots, which are never assigned to anyone, so a boat that has no slot yet cannot land on
  // a racing boat's.
  // Until a table arrives the boat assumes the layout the base will work out from the same settings (the correction interval and
  // slot width) - not a fixed 25, whose last two slots would be assigned slots in a real 41-slot table.
  const txGateForCount = new TxGate({ tracker: burstTracker, ...config.txGate });
  const slotCount = config.txGate.slot.countAuto ? autoSlotCount(config.txGate.slot, txGateForCount) : config.txGate.slot.count;
  const pinnedSlot = config.txGate.slot.index !== null ? config.txGate.slot.index % slotCount : null;
  const joinSlots = Math.min(config.txGate.slot.joinSlots, slotCount - 1);
  const slotJoin = pinnedSlot === null && joinSlots > 0 ? { first: slotCount - joinSlots, n: joinSlots } : null;
  if (config.txGate.slot.enabled) {
    console.log(
      pinnedSlot !== null
        ? `[txgate] slot mode: slot ${pinnedSlot} of ${slotCount}, ${config.txGate.slot.widthMs} ms each (set by TX_SLOT; the base's slot table is ignored)`
        : `[txgate] slot mode: waiting for the base's slot table - sharing the last ${joinSlots} of ${slotCount} slots until a slot is assigned`
    );
  }
  const gateRawSend = radio.send; // already includes the radio-sleep wrapper above
  txScheduler = new TxScheduler({
    send: gateRawSend,
    tracker: burstTracker,
    gate: txGateForCount,
    slot: { ...config.txGate.slot, count: slotCount, index: pinnedSlot !== null ? pinnedSlot : slotCount - 1, join: slotJoin },
    maxQueue: config.txGate.maxQueue,
    maxAgeMs: config.txGate.maxAgeMs,
    // A frame the scheduler gives up on (queue full, too old, refused by the radio) must not leave its fixes counted as reported: the
    // distance gate falls back to the last fix that really went out, so the next fix passes at once instead of a minute later
    onSent: (buf) => {
      const f = frameLastFix.get(buf);
      if (f) distanceGate.sent(f);
    },
    onDropped: () => distanceGate.failed(),
    log: (m) => console.log(m),
  });
  radio.send = (buf) => txScheduler.submit(buf);
  if (config.txGate.slot.enabled) {
    slotFollower = new SlotTableFollower({
      boatId: config.boatId,
      scheduler: txScheduler,
      pinned: config.txGate.slot.index !== null,
      log: (m) => console.log(m),
    });
    slotFollower.onPractice = (on) => {
      practiceMode = on;
      if (on && parked) {
        parked = false;
        slotFollower.setParked(false);
      }
      console.log(on ? '[slots] the base is in practice mode - no start-grid parking, any moving boat gets a slot' : '[slots] the base left practice mode - start-grid parking is back');
    };
    radio.on('slot-table', (table) => slotFollower.onTable(table));
    txScheduler.startSlotFlush(() => flushPendingBatch({ forSlot: true }));
  }
}

// Course marks (windward/leeward/pin/committeeStart/committeeFinish/finish),
// as last broadcast by
// the base station - a real rover has no Redis access of its own (see
// baseStation.js's mark-broadcast comment), so this is the only way it ever
// learns the course. Kept in memory for anything on the boat that wants it
// this run, and persisted to disk so a reboot/restart still has a last-known
// course immediately, without waiting for the next broadcast.
//
// The regatta name rides along in the same file (see radio.on('marks', ...)
// below) - it comes down on the exact same broadcast as the marks
// themselves, so it's exactly as safe (or stale) to trust across a restart
// as the marks are; there's no reason to treat it more cautiously than the
// course it's describing.
const marksFilePath = path.join(config.configDir, 'course_marks.json');
let currentMarks = null;
let currentRegattaName = '';
try {
  const loaded = JSON.parse(fs.readFileSync(marksFilePath, 'utf8'));
  // Reject a cache written by an older version of this app whose mark
  // schema doesn't match the current one (e.g. before green/black mark
  // pairs existed, or before this file wrapped marks in { marks,
  // regattaName } instead of storing them at the top level) - trusting it
  // as-is would crash deriveGeometry on a missing property the moment
  // startGpsSimIfReady runs. Treat it the same as no cache at all: wait for
  // the next broadcast to write a fresh one in the current shape.
  if (loaded.marks && MARK_NAMES.every((name) => loaded.marks[name])) {
    currentMarks = loaded.marks;
    currentRegattaName = loaded.regattaName || '';
    console.log(`[boatAgent] loaded last-known course marks from disk: ${Object.keys(currentMarks).join(', ')}`);
  } else {
    console.log('[boatAgent] persisted course marks on disk are in an outdated format - ignoring, waiting for a fresh broadcast');
  }
} catch (err) {
  if (err.code !== 'ENOENT') console.error('[boatAgent] failed to read persisted course marks:', err.message);
}

// Rebuilt every time currentMarks changes (see radio.on('marks', ...)
// below, and the disk-cache load just above) so it always reflects
// wherever committeeFinish/finish actually are right now, not a stale
// position from an earlier course. null whenever those two marks aren't
// both known yet - handlePvt's own finish-approach check treats that the
// same as the feature being off for this fix.
let finishApproachWatcher = null;
let eventBoost = null; // see eventBoost.js: sends the fixes around a start, finish or foul crossing whatever state the boat is in
function rebuildFinishApproachWatcher() {
  finishApproachWatcher =
    currentMarks && currentMarks.committeeFinish && currentMarks.finish ? new FinishApproachWatcher(currentMarks) : null;
  eventBoost = currentMarks && currentMarks.pin && currentMarks.committeeStart ? new EventBoost(currentMarks, { zoneM: config.regattaup.onGridZoneM }) : null;
}
rebuildFinishApproachWatcher();

// Parked state (see slotTable.js): while this boat is inside the on-grid zone behind the start line - the
// same zone the base uses - it takes no transmit slot and reports in the shared join slots only every
// TX_PARKED_REPORT_S seconds, so a fleet queueing for a start cannot use up the slots or swamp the join slots
// while another fleet races. Only in slot mode, only while the correction bursts are heard, and not for a
// boat pinned to a slot with TX_SLOT. Needs the course marks; without them there is no zone.
let zoneWatcher = null;
function rebuildZoneWatcher() {
  zoneWatcher = null;
  if (!currentMarks || !currentMarks.committeeStart || !currentMarks.pin || !currentMarks.windwardGreen || !currentMarks.leewardGreen) return;
  try {
    zoneWatcher = new OnGridWatcher(currentMarks, config.regattaup.onGridZoneM);
  } catch (err) {
    zoneWatcher = null; // the marks don't describe a start line
  }
}
rebuildZoneWatcher();
const zoneState = new ZoneState(config.txGate.slot.unparkFixes, config.txGate.slot.parkDwellS * 1000);
const parkedReporter = new ParkedReporter({
  intervalMs: config.txGate.slot.parkedReportS * 1000,
  firstMs: config.txGate.slot.parkedFirstS * 1000,
  repeatMs: config.txGate.slot.parkedRepeatS * 1000,
});
let parked = false;
const parkingEnabled = config.txGate.enabled && config.txGate.slot.enabled && config.txGate.slot.index === null;
// A boat with no slot of its own (waiting for the base to assign one, or not racing so never going to get one)
// shares the join slots and backs off its reports (see JoinBackoff). Reset whenever it is given a slot.
const joinBackoff = new JoinBackoff({ maxMs: config.txGate.slot.joinReportS * 1000 });
// A boat under way without a slot (it lost it, or never had one) reports every cycle or two, not every 15 s: a racing boat that falls out of
// its slot must not go quiet. The long back-off is for boats that are not going anywhere.
const movingBackoff = new JoinBackoff({ maxMs: 4000, steps: [0, 2000] });
const isWaitingPacer = (p) => p === joinBackoff || p === movingBackoff;
if (slotFollower) slotFollower.onAssigned = () => { joinBackoff.reset(); movingBackoff.reset(); };
function joinThrottleActive() {
  return (
    !parked &&
    config.txGate.slot.joinReportS > 0 &&
    parkingEnabled &&
    !!txScheduler &&
    !!txScheduler.slot.join &&
    txScheduler.slotAligned()
  );
}
// The pacing that applies to this boat's radio sends right now, or null for none: parked on the start grid, or sharing
// the join slots without a slot of its own.
const MOVING_UNTHROTTLED_KN = 3; // above this a boat near a mark or the finish line is not paced
function sendPacer() {
  if (eventBoost && lastPvt && eventBoost.isUrgent(lastPvt.timestamp)) return null; // a line crossing: no pacing, it must be seen
  if (parked && config.txGate.slot.parkedReportS > 0 && txScheduler && txScheduler.slotAligned()) return parkedReporter;
  if (joinThrottleActive()) {
    // A boat under way: near a mark or the finish line it is not paced at all (the base needs its fixes to see the rounding or crossing);
    // elsewhere it reports every cycle or two (movingBackoff), never every 15 s
    if (lastPvt && (lastPvt.gSpeedMmS / 1000) * 1.94384 > MOVING_UNTHROTTLED_KN) return isNearRoundingMark(lastPvt) ? null : movingBackoff;
    return joinBackoff;
  }
  return null;
}
// The base's practice mode (from its slot table): no parking on the start grid, any moving boat has a slot
let practiceMode = false;
function updateParked(pvt) {
  if (practiceMode || !parkingEnabled || !zoneWatcher || !hasValidFix(pvt)) return;
  const inZone = zoneWatcher.check(pvt.lat, pvt.lon) === 'ongrid';
  const stationary = (pvt.gSpeedMmS / 1000) * 1.94384 < config.txGate.slot.movingKn; // stopped on the grid: parked at once, the dwell is for a boat under way
  const now = zoneState.update(inZone, false, pvt.timestamp, stationary);
  if (now === parked) return;
  parked = now;
  if (slotFollower) slotFollower.setParked(parked);
  if (parked) parkedReporter.reset();
  console.log(
    parked
      ? `[slots] on the start grid - parked: no slot, reporting every ~${config.txGate.slot.parkedReportS} s in the shared join slots`
      : '[slots] left the start grid - waiting for the base to assign a slot'
  );
}

// The base's address for log uploads (see uploadClient.js), as last
// broadcast alongside the marks - not persisted to disk like currentMarks
// below, since it's much more likely to go stale across a restart (a
// reassigned DHCP lease, the base itself restarting) and a wrong cached
// address is worse than just waiting for the next broadcast to learn the
// current one.
let baseAddress = null;

// True once marks have actually been received on THIS run, as opposed to
// the possibly-stale copy loaded from disk above. SIMULATE_GPS always waits
// for this before starting a simulated race - the disk cache exists so a
// restart has *something* immediately, but a real rover has no way to know
// whether the base's course has changed since that copy was written, so the
// simulator (standing in for a real rover, which would just report whatever
// its hardware GPS says regardless of marks) shouldn't either.
let freshMarksReceived = false;

radio.on('marks', ({ marks, baseIp, basePort, baseAdminPort, regattaName }) => {
  // baseStation.js re-broadcasts marks periodically (MARKS_BROADCAST_INTERVAL_MS,
  // 60s default) for the whole time this boat's connected, not just once -
  // logging every re-broadcast would spam the console for the entire race.
  // freshMarksReceived already tracks "has this run heard marks yet" for
  // an unrelated reason (gating SIMULATE_GPS's own start below); reusing it
  // here means the log line fires on exactly the same "first time" event,
  // not a separately-tracked one that could drift out of sync with it.
  const isFirstMarks = !freshMarksReceived;
  currentMarks = marks;
  rebuildFinishApproachWatcher();
  rebuildZoneWatcher();
  freshMarksReceived = true;
  stopMarksPingRetry();
  baseAddress = baseIp && baseIp !== '0.0.0.0' ? { ip: baseIp, port: basePort, adminPort: baseAdminPort } : null;
  currentRegattaName = regattaName || '';
  roverStats.recordMarksReceived();
  try {
    fs.writeFileSync(marksFilePath, JSON.stringify({ marks, regattaName: currentRegattaName }));
  } catch (err) {
    console.error('[boatAgent] failed to persist course marks to disk:', err.message);
  }
  if (isFirstMarks) {
    console.log(
      '[boatAgent] received course marks from base station' +
        (baseAddress ? `, upload ${baseAddress.ip}:${baseAddress.port}` : '')
    );
  }
  startGpsSimIfReady();
});

// Without this, a fresh boat has to sit idle for up to
// MARKS_BROADCAST_INTERVAL_MS (60s default) before it ever hears the
// course: the base only re-broadcasts immediately upon hearing a boat that
// looks like it just (re)started (see baseStation.js's lastSeenByBoat),
// which requires this boat to have already sent a frame - a chicken-and-egg
// wait that's pure friction during
// testing/iteration, since SIMULATE_GPS can't start until freshMarksReceived
// either way. One throwaway frame, using the exact same encode/send path a
// real fix would, breaks that: it's not itself meant to be a tracked
// position (see the position choice below), only to get this boat's ID
// heard so the base's own "new boat" broadcast fires right away.
//
// Position: the best guess available before real marks exist - last-known
// marks from disk (loaded above, if this boat has run before), else
// SIM_CENTER_LAT/LON's own configured point. Deliberately NOT some
// arbitrary sentinel like (0,0): every position-based watcher on the base
// (finish line, on-grid, mark rounding) only compares a NEW fix against
// this boat's own PREVIOUS one to detect a crossing, so keeping the ping
// close to where the boat will actually start avoids a spurious crossing
// on the real fix that follows it - and specifically the midpoint of
// pin<->committeeStart, not a mark itself: this frame gets recorded and
// shown on the map exactly like a real fix (see baseStation.js's radio.on
// ('frame', ...)), so landing it on, say, leewardGreen would show the
// boat starting AT a course mark it was never actually near. The midpoint
// is guaranteed to read as on-grid (see onGridWatcher.js) regardless of
// which slot this boat ends up drawing once it actually starts.
function sendMarksPing() {
  if (sleeper.isSleeping()) return; // radio sleep mode - retries on its own interval once awake
  const pos = currentMarks
    ? {
        lat: (currentMarks.pin.lat + currentMarks.committeeStart.lat) / 2,
        lon: (currentMarks.pin.lon + currentMarks.committeeStart.lon) / 2,
      }
    : { lat: config.sim.centerLat, lon: config.sim.centerLon };
  const pingPvt = {
    timestamp: Date.now(),
    lat: pos.lat,
    lon: pos.lon,
    gSpeedMmS: 0,
    headMotDeg: 0,
    gnssFixOk: true,
    carrSoln: 0,
    numSV: 0,
  };
  const sent = radio.send(protocol.encode(config.boatId, pingPvt));
  // Same "best effort, not critical" handling as handlePvt's own send
  // below - a real radio that isn't connected yet just falls back to the
  // periodic broadcast, same as before this ping existed at all.
  if (!sent && config.radio.enabled) console.warn(`[radio] ${radioDropReason()}, dropped a marks-ping frame`);
}

// A single ping isn't enough - the base might not even be up yet when this
// boat starts (there's no guaranteed startup order between the two
// processes), or the one frame could just be lost, and either way there's
// no ack to know it missed. Retries on a short interval until marks
// actually arrive, rather than falling back to the full
// MARKS_BROADCAST_INTERVAL_MS heartbeat after a single failed attempt -
// stopped the instant real marks show up (see stopMarksPingRetry, called
// from the 'marks' handler above), so this never lingers once it's done
// its job.
let marksPingIntervalId = null;
const MARKS_PING_RETRY_MS = 3000;

function startMarksPingRetry() {
  if (marksPingIntervalId || freshMarksReceived) return;
  sendMarksPing();
  marksPingIntervalId = setInterval(sendMarksPing, MARKS_PING_RETRY_MS);
}

function stopMarksPingRetry() {
  if (marksPingIntervalId) {
    clearInterval(marksPingIntervalId);
    marksPingIntervalId = null;
  }
}

// Waits for radio's own 'connected' event (both RadioLink and
// SimRadioLink emit it once actually ready to send - see radioLink.js/
// simRadioLink.js) rather than calling startMarksPingRetry() immediately
// here: SimRadioLink's socket bind() is asynchronous, so sending right
// after construction would race ahead of setBroadcast(true) actually
// running - on at least some OSes that silently drops a broadcast send
// entirely (no error, no exception, just never arrives), which is exactly
// the kind of one-off miss these pings are meant to prevent, not
// reproduce. The RADIO_ENABLED=0 stub never emits 'connected', so this is simply
// a no-op there (nothing to ping over anyway). Left as a persistent
// listener, not `.once()`, so a boat that reconnects after a radio dropout
// (re-)starts retrying too, rather than only ever getting the marks-ping
// benefit on its very first connection.
if (config.simulateGps) radio.on('connected', startMarksPingRetry);

radio.on('sync-error', () => roverStats.recordSyncError());

// Pushes completed chunked SD-card logs to the base whenever it's actually
// reachable over WiFi (see uploadClient.js) - independent of GPS
// source/simulate mode, since this is really about the boat's own
// microSD-backed log files, not position data. Always started, even with
// UPLOAD_ENABLED=0 - its periodic health-check ping is the only way the
// base ever learns this boat's IP/admin port (see adminServer.js's
// dashboard link), so a boat with file uploads turned off shouldn't also
// disappear from the base's own dashboard. UPLOAD_ENABLED only gates the
// actual file transfer inside uploadClient.js's own tick().
startUploadClient({
  logDir: config.boatLogDir,
  boatId: config.boatId,
  chunkMinutes: config.logChunkMinutes,
  getBaseAddress: () => baseAddress,
  checkIntervalMs: config.upload.checkIntervalMs,
  timeoutMs: config.upload.timeoutMs,
  adminPort: myAdminPort,
  uploadEnabled: config.upload.enabled,
  logSuccess: config.upload.logSuccess,
});

let lastTxPosition = null; // {lat, lon} of the last fix actually transmitted
let lastTxTime = null; // pvt.timestamp of the last fix actually transmitted
// What handlePvt's distance/heartbeat gate measures from: the last fix that cleared it (sent or queued for its slot), see distanceGate.js
const distanceGate = new DistanceGate({ intervalMs: config.txIntervalMs });
const frameLastFix = new WeakMap(); // frame buffer -> the newest fix in it, so the scheduler's delivered/dropped notices can reach the gate
// Fixes accumulated for the next batch send - see queueFixForTx/
// flushPendingBatch below. Always empty when config.txBatchSize is 1 -
// that path never touches this at all, see handlePvt.
let pendingBatch = [];
// Most fixes one frame can carry: a delta frame's 8, or the older batch frame's 4 (TX_DELTA=0).
const maxFixesPerFrame = config.txDelta ? protocol.MAX_DELTA_COUNT : protocol.MAX_BATCH_COUNT;
// Slot mode: flush anyway beyond this many waiting fixes. Only a fail-safe for a slot that never comes - the flush at the slot
// is what caps the cycle's fixes to what the slot can carry (flushPendingBatch's forSlot). It was 20, which a 10 Hz GPS fills in
// a 2 s cycle, so the early flush ran first, skipped that cap, and sent every fix (about 9.6 Hz arrived instead of 8).
const SLOT_PENDING_CAP = 200;
let lastPvt = null;
// True once a dwelling/holding fix (pvt.stationary - see simGps.js's
// _emitStationaryFix) has already been logged to the console once, so
// handlePvt's own logging block below (see suppressRepeatStationary) knows
// every following one until movement resumes is a pure repeat, not new
// information.
let stationaryLineLogged = false;

// A receiver with no satellite lock yet (no antenna, freshly powered on,
// antenna damage) reports gnssFixOk=false, but lat/lon aren't necessarily
// undefined in that state - a real rig was once seen sending an exact
// (0,0) "null island" fix this way. Transmitting that over radio would put
// it on the base's map and, via redisStore.recordFix, on RegattaUp's live
// map too - checked before every send below rather than trusting fixType
// alone, since (0,0) specifically should never be a legitimate reading for
// this boat regardless of what fixType claims.
function hasValidFix(pvt) {
  return pvt.gnssFixOk && !(pvt.lat === 0 && pvt.lon === 0);
}

// Rate-limits the "no valid fix, not transmitting" warning below - without
// this, a boat with a genuinely dead/disconnected antenna would log one of
// these per GPS fix (up to GPS_HZ), since clearedTxGate never actually
// clears (lastTxPosition never advances - see transmitFix). Same pattern as
// baseStation.js's own NO_REGATTA_WARN_INTERVAL_MS.
const INVALID_FIX_WARN_INTERVAL_MS = 30000;
let lastInvalidFixWarnAt = 0;

// Mutable copy of config.markName - config.markMode's own reassignment
// control (see setMarkName/roverAdminServer.js) changes this at runtime,
// the same "own local variable, not a mutation of the shared config
// object" pattern powerSchedule.js's updateParams already uses for its own
// runtime-editable settings.
let currentMarkName = config.markName;
// {lat, lon} of the last fix actually sent as currentMarkName's new
// position (see handlePvt's own markMode block below) - distinct from
// lastTxPosition above, which gates this boat's own ordinary position
// frame; a markMode device sends both independently; null again whenever
// currentMarkName changes so a reassignment doesn't inherit gating from
// whatever mark this device represented before.
let lastMarkSetPosition = null;
// pvt.timestamp of the last Set-Mark frame actually sent for
// currentMarkName - drives markHeartbeatMs below the same way lastTxTime
// drives txIntervalMs for the ordinary position frame.
let lastMarkSetTime = null;
// Same rate-limiting spirit as lastInvalidFixWarnAt above, for the "no
// valid fix, can't auto-set the mark yet" case.
let lastMarkSetWarnAt = 0;

function handlePvt(pvt) {
  lastPvt = pvt;
  roverStats.recordFix(pvt);
  outputLocalFrame(pvt);
  updateParked(pvt);

  // Primarily distance-based: send whenever the boat has actually moved
  // TX_DISTANCE_M since the last transmitted fix, regardless of how long
  // that took - a stopped or barely-drifting boat doesn't need to keep
  // re-transmitting the same position on a timer, and a fast-moving one
  // gets updates as often as its own movement actually warrants. The SD
  // log follows the exact same gate rather than logging every fix - the SD
  // record is meant to mirror what actually went out over the radio, not a
  // separate full-rate trace, so a fix that wouldn't have been worth
  // transmitting isn't worth logging either.
  //
  // TX_INTERVAL_MS is the heartbeat fallback: a boat that's stayed inside
  // TX_DISTANCE_M this whole time (sitting at a mooring, holding on the
  // grid) still reports at least this often, so it doesn't go completely
  // silent on the base's dashboard for as long as it stays still. Elapsed
  // time is measured from the last fix actually transmitted, same as
  // movedM above - a distance-triggered send resets this timer too (see
  // transmitFix), so it's genuinely "at least every N seconds," not a
  // separate clock ticking on top of already-frequent distance-based sends.
  //
  // TX_FINISH_APPROACH_ZONE_M/TX_FINISH_DISTANCE_M tighten the distance
  // gate itself (not a separate gate alongside it) while this boat is
  // closing on the finish line upwind - see finishApproach.js's own
  // comment. Falls back to the plain txDistanceM whenever marks haven't
  // arrived yet, the zone is disabled (0), or this fix simply isn't an
  // upwind finish approach.
  const effectiveTxDistanceM =
    config.txFinishApproachZoneM > 0 &&
    finishApproachWatcher &&
    finishApproachWatcher.isApproachingUpwind(pvt.lat, pvt.lon, config.txFinishApproachZoneM)
      ? config.txFinishDistanceM
      : config.txDistanceM;
  // A parked boat's report that was repeated for safety (see ParkedReporter) goes through even though the boat has not moved
  // A start, finish or foul crossing seen on the boat's own full-rate fixes: the fixes just before it (dropped by the gate) go back in the batch, and
  // everything just after is let through, so the base sees the pair that straddles the line (see eventBoost.js)
  let finishUrgent = false;
  if (eventBoost && hasValidFix(pvt)) {
    const boost = eventBoost.onFix(pvt);
    finishUrgent = boost.urgent;
    const lastQueuedAt = pendingBatch.length ? pendingBatch[pendingBatch.length - 1].timestamp : -Infinity;
    for (const f of boost.before) {
      if (f.timestamp <= lastQueuedAt) continue;
      sdLogger.logPvt(f); // the SD log mirrors what is sent
      pendingBatch.push(f);
    }
  }
  const clearedTxGate = finishUrgent || distanceGate.cleared(pvt, effectiveTxDistanceM) || (parked && parkedReporter.wantsRepeat());

  // Every fix gets a console line, same as the base's own GPS logging
  // (openBaseGps in baseStation.js) - the console is a live "is this thing
  // still getting fixes" view, independent of the SD log/radio TX below,
  // which stay gated on TX_DISTANCE_M since that's about what's actually
  // worth transmitting/recording, not what's worth watching.
  if (config.gps.logConsole) {
    // In-place overwriting only ever applies when stdout is a real
    // interactive terminal - piped to a file or captured by
    // systemd/journald, `\x1b[2K\r` would just write raw control characters
    // into the log instead of behaving like an overwrite, so that case
    // always falls through to a plain console.log below. GPS_LOG_REPLACE=0
    // opts out of it entirely (always scroll instead) - same guard as
    // baseStation.js's openBaseGps.
    const inPlaceMode = config.gps.logReplace && process.stdout.isTTY;

    // A dwelling/holding boat (SIM_HOLD_FOR_START, SIM_PRESTART_DWELL_S,
    // SIM_START_ONLY) emits the exact same fix every tick - inPlaceMode
    // already handles that fine for a standalone boat's own real terminal
    // (overwrites in place, never scrolls), but a fleet child piped through
    // fleetSim.js never qualifies for that, so without this it scrolls a
    // full line per fix at the full SIM_GPS_HZ rate for every boat, purely
    // repeating information nothing about which has changed - across a
    // several-boat fleet that floods the shared terminal fast enough to
    // bury anything else printed in the same window (like the
    // SIM_HOLD_FOR_START prompt) within a second or two. Logs the first
    // stationary fix (so it's still clear the boat reached the grid and is
    // holding), then stays silent until it's next NOT stationary - which
    // logs normally and makes the transition back to racing obvious on its
    // own, no separate "race started" message needed here.
    const suppressRepeatStationary = pvt.stationary && !inPlaceMode && stationaryLineLogged;
    stationaryLineLogged = !!pvt.stationary;

    if (!suppressRepeatStationary) {
      // Timestamp included mainly for the in-place overwrite mode below - a
      // stationary boat can otherwise repeat the exact same line forever,
      // which looks indistinguishable from a frozen/dead connection. The
      // clock visibly ticking is what proves it's still live.
      const time = new Date(pvt.timestamp).toISOString().slice(11, 23);
      const line =
        `[gps] ${time} ${pvt.lat.toFixed(6)},${pvt.lon.toFixed(6)} ` +
        `fixType=${pvt.fixType} diffSoln=${pvt.diffSoln} carrSoln=${pvt.carrSoln} numSV=${pvt.numSV} ` +
        `hAcc=${(pvt.hAccMm / 1000).toFixed(2)}m`;
      if (inPlaceMode && !clearedTxGate) {
        // Noise between the fixes that matter - overwrite the same
        // terminal line instead of scrolling at the full 1-10Hz GPS rate.
        // `\x1b[2K\r` clears whatever's on the line first so a shorter new
        // line never leaves stale trailing characters from a longer one.
        // gpsLineDirty stays true - see the console wrapper above, which is
        // what stops some *other* log call from landing on this same line.
        process.stdout.write(`\x1b[2K\r${line}`);
        gpsLineDirty = true;
      } else if (inPlaceMode) {
        // A real event (cleared the gate) while in TTY full-logging mode -
        // clear any pending in-place line first, then commit this one to
        // scrollback with a trailing newline.
        process.stdout.write(`\x1b[2K\r${line}\n`);
        gpsLineDirty = false;
      } else {
        console.log(line);
      }
    }
  }

  if (clearedTxGate) {
    if (hasValidFix(pvt)) {
      distanceGate.advance(pvt); // the next fix is measured from this one, not from whatever last went out
      if (config.txBatchSize > 1) {
        queueFixForTx(pvt);
      } else {
        transmitFix(pvt);
      }
    } else {
      const now = Date.now();
      if (now - lastInvalidFixWarnAt > INVALID_FIX_WARN_INTERVAL_MS) {
        console.warn(`[gps] no valid fix (gnssFixOk=${pvt.gnssFixOk} lat=${pvt.lat} lon=${pvt.lon}) - not transmitting`);
        lastInvalidFixWarnAt = now;
      }
    }
  }

  // markMode's own continuous "this device IS the mark" gate - entirely
  // independent of clearedTxGate above (a markMode device is still an
  // ordinary boat too, see config.markMode's own comment): a real mark
  // buoy drifts far more slowly than a boat under sail, so it gets its own
  // distance threshold (markDistanceM, typically much smaller than
  // txDistanceM) and its own last-sent position to gate against, rather
  // than piggybacking on whichever cadence the boat-position gate happens
  // to be running at.
  //
  // markHeartbeatMs is the second half of the gate, same dual-gate shape
  // as clearedTxGate's own movedM-or-elapsed above: an anchored mark buoy
  // is the NORMAL case (it stops moving once placed), but the base's own
  // assignedBoatId/assignedAt liveness (adminServer.js's
  // markAssignmentBadge, MARK_ASSIGNMENT_STALE_MS=60000) still needs
  // periodic proof this device is alive and still representing it - a
  // heartbeat-only send re-uses the exact same Set-Mark frame with
  // whatever position this device is already at, not a distinct frame
  // type.
  if (config.markMode && currentMarkName) {
    if (hasValidFix(pvt)) {
      const movedFromMarkM = lastMarkSetPosition ? distanceMeters(lastMarkSetPosition, pvt) : Infinity;
      const elapsedSinceMarkSetMs = lastMarkSetTime !== null ? pvt.timestamp - lastMarkSetTime : Infinity;
      if (movedFromMarkM >= config.markDistanceM || (config.markHeartbeatMs > 0 && elapsedSinceMarkSetMs >= config.markHeartbeatMs)) {
        try {
          sendSetMark(currentMarkName, { continuous: true });
          lastMarkSetPosition = { lat: pvt.lat, lon: pvt.lon };
          lastMarkSetTime = pvt.timestamp;
        } catch (err) {
          const now = Date.now();
          if (now - lastMarkSetWarnAt > INVALID_FIX_WARN_INTERVAL_MS) {
            console.warn(`[markMode] failed to auto-send "${currentMarkName}" position: ${err.message}`);
            lastMarkSetWarnAt = now;
          }
        }
      }
    } else {
      const now = Date.now();
      if (now - lastMarkSetWarnAt > INVALID_FIX_WARN_INTERVAL_MS) {
        console.warn(`[markMode] no valid fix yet - not auto-setting "${currentMarkName}"`);
        lastMarkSetWarnAt = now;
      }
    }
  }
}

// Actually sends a fix over the radio (real or simulated) and logs it to
// SD - the second half of handlePvt's own clearedTxGate branch, pulled out
// so the ping handler below (which transmits the current fix on request,
// deliberately bypassing the movement gate - see its own comment) can reuse
// the exact same send/log/stats path rather than duplicating it.
// lastTxPosition/lastTxTime only advance when radio.send() actually reports
// success, OR there's deliberately no radio at all (RADIO_ENABLED=0 - see
// below) - NOT unconditionally on every call, so a frame dropped because a
// real radio hadn't finished connecting YET (a genuine startup race: an
// already-converged RTK fix can arrive within milliseconds of GPS port
// open, comfortably beating a USB radio's own connect time) doesn't get
// treated as "reported." Leaving both null in that specific case means
// handlePvt's own clearedTxGate stays true (movedM stays Infinity) on the
// very next fix too, so it keeps retrying every fix until one genuinely
// gets out, rather than a stationary boat silently never transmitting
// again because its one guaranteed always-send attempt was spent on a
// frame that never left. RADIO_ENABLED=0 is different: send() there is a
// permanent `() => false` by design (see radio init above), not a
// transient failure - advancing both regardless keeps that mode's SD
// logging properly TX_DISTANCE_M/TX_INTERVAL_MS-gated instead of retrying
// (and therefore logging) every single fix forever.
function transmitFix(pvt) {
  sdLogger.logPvt(pvt);
  if (sleeper.isSleeping()) return; // radio sleep mode - SD-logged above, nothing to transmit
  const pacer = sendPacer();
  if (pacer) {
    if (!pacer.due()) {
      distanceGate.failed(); // not reported: the next fix must be able to pass the gate (the gate is not told this one went out)
      return; // parked, or without a slot: SD-logged above, reported only now and then
    }
    pacer.sent();
  }
  const frame = protocol.encode(config.boatId, pvt);
  const sent = radio.send(frame);
  if (sent || !radioExpected) {
    lastTxPosition = { lat: pvt.lat, lon: pvt.lon };
    lastTxTime = pvt.timestamp;
    if (txScheduler) frameLastFix.set(frame, pvt);
    else distanceGate.sent(pvt);
  }
  if (sent) {
    roverStats.recordFrameSent();
  } else if (radioExpected) {
    distanceGate.failed();
    console.warn(`[radio] ${radioDropReason()}, dropped a frame (still logged to SD)`);
  }
}

// Only reachable when config.txBatchSize > 1 (see handlePvt) - logs pvt to
// SD immediately, same timing as transmitFix above (SD mirrors "cleared the
// gate," not "actually went out over radio" - see the README's own note on
// this), then adds it to the pending batch instead of sending it alone.
// Flushes once the batch reaches txBatchSize fixes, OR once the oldest
// pending fix has been waiting txIntervalMs - the latter is what keeps
// TX_INTERVAL_MS's own "never silent longer than this" guarantee intact
// even while a batch is still filling up on a slow-moving boat, instead of
// letting a partial batch sit indefinitely.
function queueFixForTx(pvt) {
  sdLogger.logPvt(pvt);
  const pacer = sendPacer();
  if (pacer) {
    // parked or without a slot: only the latest fix is kept for the next (occasional) report. Without a slot (not
    // parked) the fix it replaces is kept for the first cycle in a slot, see waitingFixes
    if (isWaitingPacer(pacer)) holdWhileWaiting(pendingBatch);
    pendingBatch = [pvt];
    return;
  }
  pendingBatch.push(pvt);

  // In slot mode (bursts heard) fixes are held for the boat's slot and sent together when it opens - see
  // txScheduler.startSlotFlush - rather than going out whenever a batch happens to fill, which
  // queues batches up against the slot (at 5 Hz, 1.25 batches per cycle). A cap stops a long wait
  // growing without bound.
  const slotHeld = txScheduler && txScheduler.slotAligned() && pendingBatch.length < SLOT_PENDING_CAP;
  const batchFull = !slotHeld && pendingBatch.length >= config.txBatchSize;
  // txIntervalMs === 0 means "heartbeat disabled" (same convention as
  // handlePvt's own clearedTxGate above) - without this guard, a fresh
  // batch's very first fix would read as instantly stale (0 >= 0) and flush
  // right away every time, silently defeating batching whenever an operator
  // has turned the heartbeat off.
  const batchStale = config.txIntervalMs > 0 && pvt.timestamp - pendingBatch[0].timestamp >= config.txIntervalMs;
  if (batchFull || batchStale) {
    flushPendingBatch();
  }
}

// True within config.txGate.slot.markZoneM of a windward/leeward mark or of the finish line, where the base needs every fix to see a
// rounding or a crossing: the whole slot is used and nothing is thinned away there. Near the finish line only for a boat heading
// upwind - the way a lap is finished (finishApproach.js's headingUpwind): one coming down the run past the line has nothing to cross there, and
// any crossing it does make the wrong way is sent by eventBoost.
function isNearRoundingMark(fix) {
  const zone = config.txGate.slot.markZoneM;
  if (!zone || !currentMarks) return false;
  if (ROUNDING_MARKS.some((name) => currentMarks[name] && distanceMeters(currentMarks[name], fix) <= zone)) return true;
  const { committeeFinish, finish } = currentMarks;
  return !!(committeeFinish && finish && distanceToSegmentM(fix, committeeFinish, finish) <= zone && headingUpwind(fix, committeeFinish, finish));
}
const ROUNDING_MARKS = ['windwardGreen', 'windwardBlack', 'leewardGreen', 'leewardBlack'];

// Fixes a boat could not send while it had no slot (it was sharing the join slots, one report at a time). When the slot
// arrives the first cycle carries them, thinned, so the live track has no hole between leaving the grid and the slot.
const BACKFILL_MAX_AGE_MS = 15000;
let waitingFixes = [];
function holdWhileWaiting(list) {
  if (list.length === 0) return;
  waitingFixes = waitingFixes.concat(list);
  const cutoff = waitingFixes[waitingFixes.length - 1].timestamp - BACKFILL_MAX_AGE_MS;
  const keep = waitingFixes.findIndex((f) => f.timestamp >= cutoff);
  if (keep > 0) waitingFixes = waitingFixes.slice(keep);
}

let lastBatchFix = null; // newest fix of the last cycle's batch, the anchor for thinning the next

// Sends whatever's pending as one batch frame (or, for the common case of a
// single straggling fix once txIntervalMs forces an early flush, the exact
// same plain single-fix frame transmitFix would have sent) - same
// success/failure handling as transmitFix above, just applied once to the
// whole batch: lastTxPosition/lastTxTime advance to the LAST fix in the
// batch only if the send actually succeeded (or no radio is expected at
// all), so a failed send keeps retrying on the next fix exactly like a
// single dropped frame would. Always clears pendingBatch regardless of
// success - like a dropped single frame, an undelivered batch's fixes are
// already durably on SD (logged above as each one was queued); this app
// doesn't buffer-and-retry radio sends, on principle, for either case.
function flushPendingBatch({ forSlot = false, final = false } = {}) {
  let fixes = pendingBatch;
  pendingBatch = [];
  let backfilled = false;
  let backfillLog = null; // what the first cycle in a slot did with the fixes held while waiting - logged once below
  if (fixes.length === 0) return;
  if (sleeper.isSleeping()) return; // radio sleep mode - already SD-logged as each fix was queued
  const pacer = final ? null : sendPacer(); // the last send before exiting skips the pacing
  if (pacer) {
    // parked, or without a slot of its own: one fix, only when the next report is due (the rest are on the SD card)
    // sharing the join slots (not parked): what is not sent is kept for the first cycle in a slot, see waitingFixes
    const waiting = isWaitingPacer(pacer);
    if (!waiting) waitingFixes = []; // parked: nothing to backfill
    if (!pacer.due()) {
      if (waiting) holdWhileWaiting(fixes);
      // Keep the newest fix for when the report is due. The distance gate lets a stationary boat queue only one fix a minute, so a
      // fix thrown away here is not replaced by a later one: the boat's first report on the start grid, flushed at a slot opening
      // before its (0-2 s) turn came, was lost, and the boat was not heard again until its next heartbeat.
      pendingBatch = fixes.slice(-1);
      return;
    }
    pacer.sent();
    if (waiting) holdWhileWaiting(fixes.slice(0, -1));
    fixes = fixes.slice(-1);
  } else if (waitingFixes.length) {
    if (forSlot && !final) {
      const held = waitingFixes.filter((f) => f.timestamp < fixes[0].timestamp && f.timestamp >= fixes[0].timestamp - BACKFILL_MAX_AGE_MS);
      backfilled = held.length > 0;
      const kept = thinBackfill(held, { protect: isNearRoundingMark });
      if (backfilled) backfillLog = { held: held.length, kept: kept.length, spanS: (held[held.length - 1].timestamp - held[0].timestamp) / 1000, cycle: fixes.length };
      fixes = kept.concat(fixes);
    }
    waitingFixes = [];
  }

  // The slot's frame budget (the rest of the fixes are on the SD card): at most maxHz fixes a second over the cycle, and
  // at most what the slot can carry less reserveFrames frames kept free for a cycle that needs more than its fixes
  // suggest (a GPS jump or a gap over 510 ms splits a delta frame; a turn does not). A slot passes a fixed number of
  // frames per cycle, so a cycle that needs more queues the rest for the next, the queue never drains, and the
  // scheduler drops the oldest - whole blocks of fixes missing (measured, before the turn splits were removed: with 16
  // fixes per 2 s cycle, 98 of 4,361 frames expired and 2,042 spilled to a later cycle). A wider slot (TX_SLOT_MS)
  // raises the cap.
  if (forSlot && !final && config.txGate.slot.maxHz > 0 && txScheduler.tracker.period) {
    const byRate = Math.max(1, Math.round((config.txGate.slot.maxHz * txScheduler.tracker.period) / 1000));
    const framesInSlot = Math.max(1, Math.floor((txScheduler.slot.widthMs - txScheduler.gate.guardMs) / airMs(protocol.deltaFrameLen(protocol.MAX_DELTA_COUNT))));
    const perFrameMax = config.txDelta ? protocol.MAX_DELTA_COUNT : protocol.MAX_BATCH_COUNT;
    // Near a mark the base needs every fix of the rounding: use the whole slot for the cycle, the rate cap and the
    // reserve both lifted (a boat is inside the zone for a cycle or two, so a frame that spills is absorbed by the next)
    const nearMark = fixes.some(isNearRoundingMark);
    const wholeSlot = nearMark || backfilled; // a cycle with the fixes held while waiting for the slot also uses all of it
    const bySlot = perFrameMax * (wholeSlot ? framesInSlot : Math.max(1, framesInSlot - config.txGate.slot.reserveFrames));
    const cap = wholeSlot ? bySlot : Math.min(byRate, bySlot);
    // thinned to keep the turns (see thinFixes.js), judged against the last fix of the previous cycle
    if (fixes.length > cap) {
      const anchor = lastBatchFix && fixes[0].timestamp - lastBatchFix.timestamp < 5000 ? lastBatchFix : null;
      fixes = thinForTurns(fixes, cap, { anchor, protect: isNearRoundingMark });
    }
  }
  if (backfillLog) {
    const b = backfillLog;
    console.log(
      `[slots] first cycle in the slot: ${b.held} fixes held over ${b.spanS.toFixed(1)} s while waiting, thinned to ${b.kept}; ` +
        `with this cycle's ${b.cycle} that is ${b.kept + b.cycle}, sending ${fixes.length} (about ${Math.ceil(fixes.length / maxFixesPerFrame)} frame(s))`
    );
  }
  lastBatchFix = fixes[fixes.length - 1];
  const perFrame = forSlot ? maxFixesPerFrame : Math.max(1, config.txBatchSize);
  for (let i = 0; i < fixes.length; i += perFrame) sendFixes(fixes.slice(i, i + perFrame));
}

// Sends up to one frame's worth of fixes (more if delta coding has to split them - see
// protocol.encodeDeltaFrames): delta frames carry up to MAX_DELTA_COUNT fixes in under 84 bytes, the
// older batch frame MAX_BATCH_COUNT in 84 (TX_DELTA=0).
function sendFixes(fixes) {
  const frames =
    (fixes.length === 1
      ? [{ buf: protocol.encode(config.boatId, fixes[0]), count: 1 }]
      : config.txDelta
      ? protocol.encodeDeltaFrames(config.boatId, fixes)
      : [{ buf: protocol.encodeBatch(config.boatId, fixes), count: fixes.length }]);
  let consumed = 0;
  for (const { buf, count } of frames) {
    const sent = radio.send(buf);
    consumed += count;
    const last = fixes[consumed - 1];
    if (sent || !radioExpected) {
      lastTxPosition = { lat: last.lat, lon: last.lon };
      lastTxTime = last.timestamp;
      if (txScheduler) frameLastFix.set(buf, last);
      else distanceGate.sent(last);
    }
    if (sent) {
      roverStats.recordFrameSent();
    } else if (radioExpected) {
      distanceGate.failed();
      const what = count === 1 ? 'a frame' : `a batch of ${count} frames`;
      console.warn(`[radio] ${radioDropReason()}, dropped ${what} (still logged to SD)`);
    }
  }
}

// Announces this boat's presence the moment the radio connects, well
// before a first GPS fix necessarily exists - a cold GPS start can take
// minutes, and without this the base has no way to know this boat's radio
// is even alive until that first real fix goes out (see protocol.js's own
// comment on encodeHello/encodeStatusHello, and baseStation.js's
// radio.on('hello', ...) for what the base does with it - the log, the
// dashboard's "last seen" and its Rover issues column, never written to
// CSV/Redis/RegattaUp the way a real fix is). Carries the rover's own
// diagnosis (roverDiag.js). Sent immediately, then every HELLO_RETRY_MS
// until the first real fix transmits (lastTxTime goes non-null, see
// transmitFix above). After that only when there's something to say: at
// once when the diagnosis changes (including when a problem clears, so the
// base drops it), and every HELLO_PROBLEM_MS while a problem lasts.
const HELLO_RETRY_MS = 30000;
const HELLO_PROBLEM_MS = 60000;
let helloIntervalId = null;
let helloStartupTimeoutId = null;
let lastHelloAt = 0;
let lastHelloKey = null;

// What roverDiag.computeFlags looks at - see its own comment. Timestamps are this Pi's clock, set by the handlers below and in
// openGps/onGpsFix; `since` moves on a wake, so nothing counts as missing until it has had time to come back.
const diagState = {
  since: Date.now(),
  gpsPortOpen: false,
  lastGpsBytesAt: null,
  lastUbxAt: null,
  lastPvtAt: null,
  lastRxmRtcmAt: null,
  lastBaseRxAt: null,
};
let diagPvt = null; // the last NAV-PVT, whatever its quality, for the satellite count and fix type
for (const evt of ['marks', 'slot-table', 'ping', 'power-schedule', 'power']) radio.on(evt, () => { diagState.lastBaseRxAt = Date.now(); });

function currentDiag() {
  const flags = roverDiag.computeFlags({
    ...diagState,
    gpsReal: gpsMode === 'real',
    gpsAsleep: gpsSleep.isAsleep(),
    watchBursts: config.txGate.enabled && config.txGate.rtcmWatch.enabled && radioExpected,
    burstsHeard: burstTracker.isActive(),
  });
  return {
    boatId: config.boatId,
    flags,
    power: config.simulate ? 0 : roverDiag.readPower(),
    numSV: diagPvt ? diagPvt.numSV : 0,
    fixType: diagPvt ? diagPvt.fixType : null,
    carrSoln: diagPvt ? diagPvt.carrSoln : 0,
    build: roverDiag.buildNumber(VERSION) || 0,
    dirty: VERSION.dirty,
  };
}

function sendHello({ force = false } = {}) {
  if (sleeper.isSleeping()) return; // keeps trying on its interval once awake
  const diag = currentDiag();
  const key = roverDiag.problemKey(diag);
  const now = Date.now();
  const due =
    force ||
    lastTxTime === null ||
    key !== lastHelloKey ||
    (roverDiag.hasProblem(diag) && now - lastHelloAt >= HELLO_PROBLEM_MS);
  if (!due) return;
  const sent = radio.send(protocol.encodeStatusHello(diag));
  if (sent) {
    lastHelloAt = now;
    lastHelloKey = key;
  } else if (radioExpected) {
    console.warn(`[radio] ${radioDropReason()}, dropped a hello frame (will keep retrying)`);
  }
}

function startHelloAnnounce() {
  // A real radio reconnecting mid-run (see radio.on('disconnected', ...)
  // above) fires 'connected' again - clear any interval/pending startup
  // delay from the previous connection first, so a reconnect doesn't leave
  // two intervals (or two pending jittered starts) both calling sendHello.
  if (helloIntervalId !== null) clearInterval(helloIntervalId);
  if (helloStartupTimeoutId !== null) clearTimeout(helloStartupTimeoutId);

  // Random delay before the first send (see config.js's own comment on
  // helloStartupJitterMs) - the interval below only starts counting
  // once this fires, so it inherits the same random offset rather than
  // snapping back to a fleet-wide fixed beat after just one jittered send.
  const delayMs = Math.random() * config.helloStartupJitterMs;
  helloStartupTimeoutId = setTimeout(() => {
    helloStartupTimeoutId = null;
    sendHello({ force: true });
    helloIntervalId = setInterval(sendHello, HELLO_RETRY_MS);
  }, delayMs);
}

// Base-triggered "report your current position now" (see protocol.js's
// encodePing/adminServer.js's "Ping fleet" button) - mainly for a boat
// that's been sitting stationary since before the base/dashboard was even
// up: a stationary boat only ever clears the TX_DISTANCE_M gate once (see
// handlePvt above), so without this the base has no way to learn it's
// there, on-grid, right now. Responds with whatever lastPvt already is
// (nothing new to acquire - GPS fixes arrive continuously regardless of
// whether they're ever transmitted), after a random delay up to
// config.pingResponseJitterMs so an entire fleet doesn't all key up over
// each other on the same shared channel the instant they hear the request.
// The fleet's power schedule from the base admin (one frame, protocol.js's decodePowerSchedule): the Witty Pi schedule
// (wittySchedule.js) and the boat's own software shutdown (fleetShutdown.js). The base repeats it every minute or so; each part
// is applied only when it differs from what this boat last got from the base, and a part the base has never set is left alone.
// The Witty Pi part needs the board's software installed here; the shutdown part always works.
let lastHeardPowerStamp = null;
radio.on('power-schedule', async (frame) => {
  // A fully simulated boat (SIMULATE=1, `npm run fleet`, `npm run fleet-rf`) must not act on the fleet's power schedule: dozens of
  // them share one machine and one race-config/, and on a Linux dev box the shutdown rule would arm a real shutdown of it.
  // ACCEPT_POWER_SCHEDULE=1 lets one simulated boat apply it, to test the whole path (README, Witty Pi).
  const ignoring = config.simulate && process.env.ACCEPT_POWER_SCHEDULE !== '1';
  try {
    // Say what arrived, once per version of the schedule (the base repeats it every minute or so, which stays silent) - an
    // ignoring simulated boat too, so every change the base makes shows in its console
    if (frame.stamp !== lastHeardPowerStamp) {
      lastHeardPowerStamp = frame.stamp;
      const parts = [
        frame.witty ? `Witty Pi: ${wittySchedule.describe(frame.witty)}` : 'Witty Pi: not set by the base',
        frame.shutdown ? `shutdown: ${fleetShutdown.describe(frame.shutdown)}` : 'shutdown: not set by the base',
      ];
      console.log(
        `[power] heard the base's power schedule (${config.simulate ? 'simulated radio' : 'radio'}) - ${parts.join('; ')}` +
          (ignoring ? ' - ignored: simulated boat (ACCEPT_POWER_SCHEDULE=1 applies it)' : '')
      );
    }
    if (ignoring) return;
    if (frame.shutdown) {
      const r = fleetShutdown.handleFrame({ ...frame.shutdown, stamp: frame.stamp }, { updateParams: (p) => powerScheduler.updateParams(p) });
      if (r) (r.ok ? console.log : console.error)(`[power] ${r.message}`);
    }
    if (frame.witty) {
      const r = await wittySchedule.handleScheduleFrame({ ...frame.witty, stamp: frame.stamp });
      if (!r) return;
      if (r.notInstalled) console.log('[witty] the base sent a power schedule but the Witty Pi software is not installed here - ignored');
      else if (r.ok) console.log(`[witty] ${r.message}`);
      else console.error(`[witty] could not apply the base's power schedule: ${r.message}`);
    }
  } catch (err) {
    console.error('[power] schedule handling failed:', err.message);
  }
});

radio.on('ping', () => {
  if (!lastPvt || !hasValidFix(lastPvt)) return; // no fix yet, or not a valid one - nothing to report
  const delayMs = Math.random() * config.pingResponseJitterMs;
  setTimeout(() => transmitFix(lastPvt), delayMs);
});

// RTCM3 corrections arriving over the telemetry radio itself (one shared radio
// for telemetry AND corrections - see README's "RTCM on the shared radio"):
// recognised by radioLink.js so they never read as radio errors, counted for the
// dashboard, and - with RTCM_FORWARD=1 - written untouched to the GPS receiver.
// Never forwarded while the rover is sleeping: any byte written to a sleeping
// receiver wakes it (see gpsSleep.js), and a listen window would then wake the
// GPS on every correction burst.
// null unless RTCM_LOG is set (1 = a tight line per second, 2 = a decoded line per message)
const rtcmLogger = config.rtcm.log ? createRtcmLogger({ level: config.rtcm.log }) : null;

// An orange warning when the correction bursts are not heard (see rtcmWatchdog.js), unless the boat's corrections come another way
if (config.txGate.enabled && config.txGate.rtcmWatch.enabled && radioExpected) {
  const rtcmWatchdog = new RtcmWatchdog({
    tracker: burstTracker,
    warn: (m) => console.warn(m),
    color: (m) => orange(m),
    graceMs: config.txGate.rtcmWatch.warnS * 1000,
    repeatMs: config.txGate.rtcmWatch.repeatS * 1000,
    paused: () => sleeper.isSleeping() || gpsSleep.isAsleep(),
  });
  setInterval(() => rtcmWatchdog.check(), 5000).unref();
}

radio.on('rtcm', (frame) => {
  burstTracker.onRtcm(frame.type, undefined, frame.length);
  const forward = config.rtcm.forward && !sleeper.isSleeping() && !gpsSleep.isAsleep() && !!gpsSerial && gpsSerial.isOpen;
  if (forward) gpsSerial.write(frame.raw);
  roverStats.recordRadioRtcm(frame, forward);
  if (rtcmLogger) rtcmLogger.radio(frame, forward);
});

// Going to sleep: whatever fixes were still waiting to batch are already on
// SD (logged as each was queued) and would be stale by wake time, so drop
// them rather than sending them as a "fresh" batch afterwards.
sleeper.on('sleep', () => {
  pendingBatch = [];
  announceNextFix = false;
  gpsSleep.sleep();
});

// Waking from radio sleep: wake the GPS, and announce this rover straight
// away so the base sees it come back - a hello now (jittered like a ping
// reply, so a whole fleet woken by one "all" frame doesn't key up in the same
// instant), then the position itself as soon as the GPS has a fresh fix (see
// onGpsFix). A rover with no GPS at all just reports its last known fix.
sleeper.on('wake', () => {
  diagState.since = Date.now();
  gpsSleep.wake();
  announceNextFix = gpsSleep.supported;
  const delayMs = Math.random() * config.pingResponseJitterMs;
  setTimeout(() => {
    if (!gpsSleep.supported && lastPvt && hasValidFix(lastPvt)) transmitFix(lastPvt);
    else sendHello({ force: true });
  }, delayMs);
});

// The dashboard's "GPS signals" card (see gnssSignals.js). Asked for only while
// someone has that page open, rather than turned on as a regular output: a
// NAV-SIG can run to a kilobyte on UART1, which a race has no use for, and
// rovers don't change their receiver's settings (a poll changes nothing).
const GPS_SIGNALS_POLL_MIN_MS = 4000;
const gpsSignals = { requestedAt: null, receivedAt: null, summary: null };

function pollGpsSignals() {
  if (gpsMode !== 'real' || !gpsSerial || !gpsSerial.isOpen) return;
  // Any byte written to a sleeping receiver wakes it - see gpsSleep.js
  if (gpsSleep.isAsleep()) return;
  if (gpsSignals.requestedAt != null && Date.now() - gpsSignals.requestedAt < GPS_SIGNALS_POLL_MIN_MS) return;
  gpsSignals.requestedAt = Date.now();
  gpsSerial.write(encodePollRequest(CLASS_NAV, ID_NAV_SIG));
}

function openGps() {
  const gpsPort = new SerialPort({ path: config.gps.port, baudRate: config.gps.baud }, (err) => {
    if (err) {
      console.error('[gps] open failed:', err.message, '- retrying in 3s');
      setTimeout(openGps, 3000);
    }
  });

  const parser = new UbxParser();

  gpsSerial = gpsPort;
  gpsPort.on('open', () => {
    diagState.gpsPortOpen = true;
    gpsSleep.wakeOnStartup(); // see GpsSleep.wakeOnStartup
  });

  gpsPort.on('data', (chunk) => {
    diagState.lastGpsBytesAt = Date.now();
    parser.write(chunk);
  });
  parser.on('ubx-frame', () => { diagState.lastUbxAt = Date.now(); });
  gpsPort.on('close', () => {
    diagState.gpsPortOpen = false;
    console.warn('[gps] port closed, retrying in 3s');
    setTimeout(openGps, 3000);
  });
  gpsPort.on('error', (err) => console.error('[gps] error:', err.message));

  parser.on('checksum-error', () => {
    // Occasional corrupt frames are normal on long/noisy UART runs; only
    // worry if this fires constantly.
  });

  parser.on('nav-pvt', onGpsFix);

  parser.on('nav-sig', (signals) => {
    gpsSignals.receivedAt = Date.now();
    gpsSignals.summary = summarizeSignals(signals);
  });

  // The only direct evidence this app can show that RTCM corrections are
  // actually reaching the receiver - that link runs over the module's own
  // onboard correction radio, entirely separate hardware from GPS_PORT/
  // RADIO_PORT (see README's "Wiring notes"), so this app has no other way
  // to see it. Requires two separate opt-ins before anything shows up
  // here: UBX-RXM-RTCM enabled as an output on this same UART on the
  // receiver itself (see ubxParser.js's own comment - off by default there
  // too, so seeing nothing doesn't by itself mean no corrections are
  // arriving, only that this message hasn't been turned on to report it),
  // and RTCM_LOG=1 here (see config.js - off by default so a one-off
  // diagnostic enable on the receiver doesn't also start scrolling
  // unwanted lines on every ordinary run afterward). crcFailed is a real
  // problem (a corrupted correction, dropped); msgUsed='not used' on its
  // own isn't - plenty of message types (e.g. a constellation you're not
  // tracking) are legitimately ignored.
  parser.on('rxm-rtcm', (msg) => {
    diagState.lastRxmRtcmAt = Date.now();
    roverStats.recordRtcm(msg);
    if (rtcmLogger) rtcmLogger.receiver(msg);
  });
}

// True once the simulated GPS has actually started, so a mark broadcast
// arriving mid-race (the periodic re-broadcast, not just the first one)
// doesn't try to start a second one.
let gpsSimStarted = false;

// The live SimGpsSource, once created (see startGpsSimIfReady below) - kept
// so releaseHold() (SIM_HOLD_FOR_START's spacebar/IPC handler, set up
// further down) has something to call release() on. Stays null the whole
// run under any other mode (real GPS, or SIMULATE_GPS before marks arrive).
let simGpsSource = null;

// True once the operator's "start the race" signal has actually arrived
// (see releaseHold below) - the signal can beat marks reception (a fast
// spacebar press right after this process starts), so this is checked
// again once simGpsSource actually exists, rather than assuming the signal
// only ever arrives after the boat is already on the grid.
let holdReleased = false;

// SIM_HOLD_FOR_START's actual release - called either from this process's
// own stdin (a standalone `npm run boat`, which owns the terminal directly)
// or from an IPC 'start-race' message forwarded by fleetSim.js (which owns
// the terminal instead, when this boat was spawned as part of a fleet -
// see fleetSim.js's own keypress handling). Idempotent, since either path
// could in principle fire more than once.
function releaseHold() {
  holdReleased = true;
  if (simGpsSource) simGpsSource.release();
}

if (config.simulateGps && config.sim.holdForStart) {
  console.log('[boatAgent] SIM_HOLD_FOR_START=1 - will hold at the start position once on the grid, waiting for the start signal');
  // Fleet child: process.send only exists when this process was spawned
  // with an 'ipc' stdio channel (see fleetSim.js), which is how the
  // operator's spacebar press in the fleet's own terminal reaches every
  // boat it spawned - none of them have their own TTY stdin to read
  // directly (fleetSim spawns them with stdin 'ignore').
  if (typeof process.send === 'function') {
    process.on('message', (msg) => {
      if (msg === 'start-race') releaseHold();
    });
  }
  // Standalone boat: this process owns the terminal itself, so it reads
  // the operator's spacebar directly instead of waiting on an IPC message
  // nothing would ever send.
  if (process.stdin.isTTY) {
    console.log('[boatAgent] press SPACE in this terminal to start the race');
    process.stdin.setRawMode(true);
    process.stdin.resume();
    // The one-time message above is easy to miss once GPS fix lines start
    // scrolling (or, in-place-overwrite mode, aren't scrolling at all - see
    // handlePvt's gpsLineDirty) - repeats a louder reminder on a slow timer
    // until actually released, only once the boat has actually reached the
    // grid (gpsSimStarted), so it doesn't nag before there's anything to
    // start yet. Cleared the moment SPACE lands - see the 'data' handler
    // below and the SIGINT handler at the bottom of this file.
    const reminderIntervalId = setInterval(() => {
      if (gpsSimStarted && !holdReleased) {
        console.log('[boatAgent] *** on the grid - press SPACE to start the race ***');
      }
    }, 15000);
    process.stdin.on('data', (data) => {
      if (data.includes(0x03)) {
        // Ctrl+C - raw mode intercepts this before the terminal driver ever
        // turns it into a real SIGINT, so it's re-raised by hand here to
        // reach the ordinary SIGINT shutdown handler at the bottom of this
        // file (which also restores normal stdin mode - see there).
        clearInterval(reminderIntervalId);
        process.kill(process.pid, 'SIGINT');
        return;
      }
      // Raw mode shows no Return, so echo it as a blank line: a marker to separate what comes next in the log
      if (data.includes(0x0d) || data.includes(0x0a)) console.log('');
      if (data.includes(0x20) && !holdReleased) {
        console.log('[boatAgent] SPACE pressed - starting the race');
        clearInterval(reminderIntervalId);
        process.stdin.setRawMode(false);
        releaseHold();
      }
    });
  }
}

// Starts the simulated GPS as soon as marks are actually known - either
// immediately (a persisted copy was already on disk from a previous run) or
// whenever the first broadcast arrives (see radio.on('marks', ...) above).
// No Redis access here at all: a real rover can't reach Redis, so the sim
// GPS source has to wait on exactly the same information a real rover would
// have to wait on - whatever the base station has actually radioed out.
function startGpsSimIfReady() {
  if (config.noGps || !config.simulateGps || gpsSimStarted || !freshMarksReceived) return;
  gpsSimStarted = true;

  const { SimGpsSource } = require('./simGps');
  const { deriveGeometry, getRaceMarks } = require('./course');

  // Measured from the marks themselves, not assumed from this process's own
  // SIM_COURSE_LENGTH_NM - the base station is the one authority on course
  // length now (it owns Redis and does the actual clear-and-recompute when
  // that env var changes); this boat just races whatever geometry the marks
  // it received actually describe, between whichever windward/leeward pair
  // config.sim.courseMarks picks (default 'GG', the plain short course).
  const geometry = deriveGeometry(currentMarks, config.sim.courseMarks);
  const raceMarks = getRaceMarks(currentMarks, config.sim.courseMarks);

  // fleetSim.js sets SIM_START_SLOT/SIM_FLEET_SIZE when this boat is part of
  // a spawned fleet - even spacing (this boat's index out of the whole
  // fleet) so the line fills up predictably instead of clustering wherever
  // chance happens to land a batch of independent random draws (that's just
  // how randomness works over a small fleet, not a bug - see course.js's
  // own getStartFraction, which still owns confining this to the line's
  // safe pin-half zone regardless of which of these two picks the fraction).
  // Falls back to a random draw when running standalone (no fleet context -
  // a lone boat has nothing to space evenly against), varying each run
  // rather than the boat's own ID, which would put it at the exact same
  // spot every single time.
  const simFleetSize = Number(process.env.SIM_FLEET_SIZE);
  const simStartSlot = Number(process.env.SIM_START_SLOT);
  const startFrac =
    Number.isInteger(simFleetSize) && simFleetSize > 0 && Number.isInteger(simStartSlot)
      ? simStartSlot / simFleetSize
      : Math.random();

  console.log(
    `[boatAgent] starting simulated GPS, course marks: ${Object.keys(currentMarks).join(', ')}, ` +
      `racing ${raceMarks.windwardName}/${raceMarks.leewardName} (SIM_COURSE_MARKS=${config.sim.courseMarks}), start frac: ${startFrac.toFixed(3)}`
  );

  // The resolved leeward mark (see raceMarks above, and config.sim.courseMarks)
  // is the course's center/reference point for this run - SimGpsSource's
  // whole local tacking frame is built around it being at local (0,0), and
  // geometry.courseLengthM/courseBearingDeg were measured from this exact
  // same mark, so the two have to agree on which one that is.
  const gps = new SimGpsSource({
    centerLat: raceMarks.leeward.lat,
    centerLon: raceMarks.leeward.lon,
    upwindSpeedKn: config.sim.upwindSpeedKn,
    downwindSpeedKn: config.sim.downwindSpeedKn,
    hz: config.sim.gpsHz,
    startFrac,
    lapCount: config.sim.lapCount,
    geometry,
    startOnly: config.sim.startOnly,
    prestartDwellS: config.sim.prestartDwellS,
    holdForStart: config.sim.holdForStart,
    foulTest: config.sim.foulTest,
    foulWindwardM: config.sim.foulWindwardM,
    // The start/finish line logic needs the REAL pin/committeeStart/
    // committeeFinish/finish positions, not just geometry's scalar
    // distances - see simGps.js's own comment on why (an edited windward
    // mark rotates the beat axis independently of wherever the
    // start/finish complex actually still is).
    pin: currentMarks.pin,
    committeeStart: currentMarks.committeeStart,
    committeeFinish: currentMarks.committeeFinish,
    finish: currentMarks.finish,
    // The operator's pin boundary gate checkbox (see course.js's own
    // comment on PIN_BOUNDARY_MARK) - false/undefined whenever it's off,
    // which SimGpsSource treats identically to "not set" either way.
    pinBoundaryEnabled: currentMarks.pinBoundaryEnabled,
  });
  simGpsSource = gps;
  // Listener attached (and the real starting position emitted through it -
  // see emitInitialFixIfDwelling's own comment on why this can't happen
  // inside the constructor itself) before the 'on-grid' IPC message below,
  // so fleetSim.js's fleet-wide "on-grid" count never runs ahead of this
  // boat's actual position having been transmitted at least once.
  gps.on('nav-pvt', onGpsFix);
  gps.emitInitialFixIfDwelling();
  // The operator's start signal may have already arrived before this boat
  // even reached the grid (marks can take a moment - see freshMarksReceived
  // above) - releaseHold() only recorded that as holdReleased until there
  // was an actual SimGpsSource to call release() on, so catch up on it now.
  if (holdReleased) gps.release();
  if (config.sim.holdForStart && !holdReleased) {
    console.log('[boatAgent] on the grid, holding for the start signal');
    // Fleet child: lets fleetSim.js (the process actually watching for the
    // operator's spacebar - see its own 'message' handling) track how many
    // of the boats it spawned have actually reached the grid, so it can
    // prompt "press SPACE" once the whole fleet - not just this one boat -
    // is ready, instead of guessing from elapsed time.
    if (typeof process.send === 'function') process.send('on-grid');
  }
  // Diagnostic only - the sim's own internal lap counting, used to decide
  // when the simulated race ends and to report whether it stayed inside
  // the gate for tuning purposes. Actual lap *reporting* (to the base
  // station, and from there to RegattaUp) happens on the base station
  // side now (see finishLineWatcher.js there) - a real rover has no Redis
  // access to resolve marks itself, so it can only ever send its raw
  // position, the same as this sim GPS source does via handlePvt above.
  gps.on('lap', ({ lap, inGate, eastM }) =>
    console.log(`[boatAgent] (sim) completed lap ${lap} ${inGate ? 'through the finish gate' : `OUTSIDE the finish gate (east=${eastM.toFixed(1)}m)`}`)
  );
  gps.on('finished', ({ laps }) => {
    if (config.sim.exitOnFinish) {
      console.log(`[boatAgent] finished simulated race after ${laps} lap(s) - exiting (SIM_EXIT_ON_FINISH=1)`);
      exitAfterFlush();
      return;
    }
    console.log(`[boatAgent] finished simulated race after ${laps} lap(s) - staying alive for pending uploads`);
    // SimGpsSource already stopped its own tick timer before emitting this
    // (see simGps.js), so nothing keeps producing fixes/position frames -
    // the process just idles here, with the upload client's own periodic
    // check (UPLOAD_CHECK_INTERVAL_MS) still running in the background
    // until this process is stopped (Ctrl+C, or a systemd restart).
  });
}

// SIM_TRUST_CACHED_MARKS=1 - set by fleetSim.js (never by a lone `npm run
// boat`) on every boat it spawns, after it has already fetched the
// CURRENT course from Redis itself and written it to this exact shared
// course_marks.json path (see fleetSim.js's own ensureFreshMarksCached -
// every boat in a fleet shares the same LOG_DIR, hence the same cache
// file). Unlike the standalone case below, there's no "may be stale" risk
// here to guard against: this boat only sees the flag because the
// controlling process just confirmed the file is current, not because of
// whatever happened to be left over from some earlier run - so it can
// skip the radio ping/retry wait entirely rather than have every boat in
// the fleet independently re-fetch the same answer over simulated radio.
const trustCachedMarks =
  (process.env.SIM_TRUST_CACHED_MARKS === '1' || process.env.SIM_TRUST_CACHED_MARKS === 'true') && !!currentMarks;

if (config.noGps) {
  // Radio (real or simulated), marks reception, and the upload client are
  // all still fully running above - this just skips ever starting a GPS
  // source, real or simulated, so no position fixes/frames are produced.
} else if (config.simulateGps && trustCachedMarks) {
  console.log('[boatAgent] SIM_TRUST_CACHED_MARKS=1 - using the course marks already on disk without waiting for a radio broadcast');
  freshMarksReceived = true;
  startGpsSimIfReady();
} else if (config.simulateGps) {
  console.log(
    '[boatAgent] SIMULATE_GPS - waiting for a fresh course marks broadcast from the base station before starting' +
      (currentMarks ? ' (ignoring the last-known copy cached on disk - it may be stale)' : '') +
      (radioMode === 'none' ? ' (RADIO_ENABLED=0 has no radio to receive one on, so this would wait forever)' : '')
  );
} else {
  openGps();
}

// Assembles this boat's own dashboard snapshot (see roverAdminServer.js) -
// merges the running counters in roverStats with whatever else the
// dashboard needs that roverStats itself has no reason to track (course
// marks, the base's address, how many chunks are still unsent).
function getRoverStats() {
  const snapshot = roverStats.snapshot();
  return {
    ...snapshot,
    boatId: config.boatId,
    markMode: config.markMode,
    currentMarkName,
    gpsMode,
    radioMode,
    currentMarks,
    currentRegattaName,
    sleep: { ...sleeper.status(), gps: gpsSleep.status() },
    gpsSignals: gpsMode === 'real' ? { ...gpsSignals, asleep: gpsSleep.isAsleep() } : null,
    txGate: txScheduler ? txScheduler.stats() : null,
    txSlot: txScheduler
      ? { enabled: !!txScheduler.slot.enabled, index: txScheduler.slot.index, count: txScheduler.slot.count, widthMs: txScheduler.slot.widthMs, sharing: !!txScheduler.slot.join, joinSlots: txScheduler.slot.join ? txScheduler.slot.join.n : 0, joinFirst: txScheduler.slot.join ? txScheduler.slot.join.first : null, tableHeard: !!(slotFollower && slotFollower.tablesHeard > 0), practice: practiceMode, table: slotFollower ? slotFollower.lastTable : null }
      : null,
    marksReceivedCount: snapshot.marks.received,
    lastMarksReceivedAt: snapshot.marks.lastReceivedAt,
    pendingCount: countPending(config.boatLogDir, config.boatId, config.logChunkMinutes),
    disk: getDiskSpace(config.boatLogDir),
    baseIp: baseAddress ? baseAddress.ip : null,
    adminPort: baseAddress ? baseAddress.adminPort : null,
    baseUploadPort: baseAddress ? baseAddress.port : null,
  };
}

// Deliberately separate from getRoverStats above - the map's live-refresh
// loop (see roverAdminServer.js's renderMap) only ever needs the current
// fix, not the full dashboard snapshot, so this skips countPending's
// fs.readdirSync entirely - no reason to re-scan the log directory every
// 5s just to throw the result away.
function getPosition() {
  return lastPvt
    ? {
        lat: lastPvt.lat,
        lon: lastPvt.lon,
        timestamp: lastPvt.timestamp,
        receivedAt: lastPvt.receivedAt,
        carrSoln: lastPvt.carrSoln,
        gnssFixOk: lastPvt.gnssFixOk,
        numSV: lastPvt.numSV,
        hAccMm: lastPvt.hAccMm,
      }
    : null;
}

// Sends this boat's own current position as the new location for a course
// mark, over the SAME radio a fix goes out on - see protocol.js's
// encodeSetMark. Mark mode's own auto-set block in handlePvt is the only
// caller (continuous=true: see protocol.js's own comment on the frame's
// continuous byte for what the base does with it). Fire-and-forget, same as
// sendHello - there's no ack frame type in this protocol; the base's own
// re-broadcast of the updated course (see baseStation.js's
// radio.on('set-mark', ...)) is what confirms it landed. Throws rather than
// returning a status.
function sendSetMark(markName, { continuous } = {}) {
  if (!lastPvt || !hasValidFix(lastPvt)) {
    throw new Error('no valid GPS fix yet - nothing to set the mark to');
  }
  const sent = radio.send(protocol.encodeSetMark(config.boatId, markName, lastPvt.lat, lastPvt.lon, { continuous }));
  if (!sent && radioExpected) throw new Error(radioDropReason());
  return { lat: lastPvt.lat, lon: lastPvt.lon };
}

// Marks a moment in the base's own log with a short free-text note (see
// protocol.js's own comment on the mark-log frame/baseStation.js's
// radio.on('mark-log', ...)) - built for field testing, e.g. tapping this
// right after walking to a new distance from the base so that moment
// shows up inline in whatever the base is already logging, instead of
// needing to cross-reference two separate logs by wall-clock time. No GPS
// fix required (unlike sendSetMark above) - this isn't about a position,
// it's just a labeled instant, so it works even before this device has
// ever gotten a fix. Fire-and-forget, same "no ack in this protocol"
// contract as every other frame here.
function sendMarkLog(label) {
  const sent = radio.send(protocol.encodeMarkLog(config.boatId, label));
  if (!sent && radioExpected) throw new Error(radioDropReason());
}

// Assigns (or clears, name=null) which mark this markMode device
// continuously represents - see config.markMode/handlePvt's own auto-set
// block above. Persisted immediately, same "an explicit choice right now
// outlives this process" contract as config.js's own resolveMarkName, so a
// restart remembers the assignment without needing MARK_NAME set again.
// Resets lastMarkSetPosition/lastMarkSetTime so a reassignment (or a
// re-pick of the SAME mark, e.g. after moving it to a new buoy) always
// sends a fresh position on the very next fix rather than staying gated on
// wherever (or whenever) the previously-represented mark last was.
function setMarkName(name) {
  if (name && !MARK_NAMES.includes(name)) throw new Error(`unknown mark name: ${name}`);
  currentMarkName = name || null;
  lastMarkSetPosition = null;
  lastMarkSetTime = null;
  if (currentMarkName) persistMarkName(currentMarkName);
  else clearPersistedMarkName();
  return currentMarkName;
}

// Armed only if config.power.shutdownAt ends up set (ROVER_SHUTDOWN_AT, or
// a schedule persisted from a previous rover dashboard edit - see config
// .js's own "Scheduled shutdown" comment) - otherwise this is just a live,
// currently-disabled controller the dashboard's power card can still arm
// on the fly. See powerSchedule.js for the full picture.
const powerScheduler = startShutdownScheduler({
  shutdownAt: config.power.shutdownAt,
  shutdownIdleMinutes: config.power.shutdownIdleMinutes,
  shutdownSpeedKn: config.power.shutdownSpeedKn,
  shutdownRequireIdle: config.power.shutdownRequireIdle,
  shutdownCheckIntervalMs: config.power.shutdownCheckIntervalMs,
  getLastFix: () => lastPvt,
  isSuspended: () => sleeper.isSleeping(), // a sleeping rover's GPS is silent on purpose - not "idle"
});

startRoverAdminServer({
  port: myAdminPort,
  getStats: getRoverStats,
  getPosition,
  getPowerStatus: powerScheduler.getStatus,
  getWittyStatus: wittySchedule.boatStatus,
  getShutdownFromBase: fleetShutdown.boatStatus,
  setMarkName,
  sendMarkLog,
  pollGpsSignals,
});

// Compact fix-quality label - RTK carrier solution takes priority over the
// plain fixType, since "RTK-fixed" is a much stronger statement than the
// "3D" fixType alone would suggest (carrSoln is layered on top of a fix,
// not an alternative to one). Matches this app's own u-blox field names
// directly rather than inventing new terminology.
const FIX_TYPE_LABELS = { 0: 'no-fix', 1: 'dead-reckoning', 2: '2D', 3: '3D', 4: 'GNSS+DR', 5: 'time-only' };
function fixLabel(pvt) {
  if (!pvt) return 'none';
  if (pvt.carrSoln === 2) return 'RTK-fixed';
  if (pvt.carrSoln === 1) return 'RTK-float';
  return FIX_TYPE_LABELS[pvt.fixType] ?? `type${pvt.fixType}`;
}

// "Xs"/"Xm" ago, or "never" - used for every timestamp in the status
// summary below so a stale value (radio gone quiet, marks not refreshed
// in a while) is immediately obvious without doing timestamp math by eye.
function ageStr(ts) {
  if (ts == null) return 'never';
  const s = Math.max(0, Math.round((Date.now() - ts) / 1000));
  return s < 60 ? `${s}s` : `${Math.round(s / 60)}m`;
}

// One-line status summary - deliberately the ONE thing this process prints
// on a timer regardless of what GPS_LOG/etc. are set to, so there's always
// SOME live signal on an otherwise-quiet console without needing to enable
// any per-fix logging. Covers what an operator glancing at this terminal
// actually wants to know: is GPS locked and how good, where is the boat
// and how fresh is that, do we have a current course, and is the radio
// actually getting frames out - all the individually-toggleable logs
// elsewhere in this file are for digging into ONE of these in detail once
// this line says something's off, not for routine watching.
function radioLabel() {
  return !radioExpected ? 'disabled' : radioConnected ? 'ok' : 'down';
}

function logStatusSummary() {
  const pvt = lastPvt;
  // roverStats already tracks lastMarksReceivedAt/upload.lastUploadAt for
  // the dashboard (recordMarksReceived()/recordUploadSuccess() are called
  // from the 'marks' handler above and uploadClient.js respectively) -
  // reused here instead of second, separately-tracked copies of the same
  // timestamps that could drift out of sync with them.
  const snap = roverStats.snapshot();
  console.log(
    `[status] gps=${fixLabel(pvt)} acc=${pvt ? (pvt.hAccMm / 1000).toFixed(2) + 'm' : '-'} ` +
      `sv=${pvt ? pvt.numSV : 0} pos=${pvt ? `${pvt.lat.toFixed(6)},${pvt.lon.toFixed(6)}` : 'none'} ` +
      `fixAge=${ageStr(pvt?.timestamp)} marks=${ageStr(snap.marks.lastReceivedAt)} ` +
      `radio=${radioLabel()} txAge=${ageStr(lastTxTime)} uploadAge=${ageStr(snap.upload.lastUploadAt)}`
  );
}

// The DISCRETE part of the status worth reacting to immediately, as
// opposed to the 60s heartbeat below: GPS fix quality and radio
// connectivity are real state transitions (RTK lock gained/lost, radio up/
// down), and "never had one" -> "have one now" for a fix/marks/TX is a
// genuine one-time milestone. Deliberately excludes the continuously-
// varying fields (position, accuracy, satellite count, every *Age) - those
// change on essentially every fix while under way, and reacting to THEM
// immediately would just reproduce the exact per-fix log spam this status
// line was built to replace.
function statusKey() {
  const pvt = lastPvt;
  const snap = roverStats.snapshot();
  return JSON.stringify([
    fixLabel(pvt),
    radioLabel(),
    pvt != null,
    snap.marks.lastReceivedAt != null,
    lastTxTime != null,
    snap.upload.lastUploadAt != null,
  ]);
}

let lastLoggedStatusKey = null;
let lastStatusLogAt = 0;
function maybeLogStatusSummary() {
  const key = statusKey();
  const now = Date.now();
  if (key !== lastLoggedStatusKey || now - lastStatusLogAt >= 60000) {
    logStatusSummary();
    lastLoggedStatusKey = key;
    lastStatusLogAt = now;
  }
}
// Checked every 2s rather than hooked into every individual mutation site
// (handlePvt, radio connect/disconnect, the marks handler, transmitFix) -
// far simpler than scattering "maybe log now" calls across all of them,
// at the cost of up to ~2s detection latency for a change, which is
// irrelevant here (arguably even desirable - it won't fire on a one-fix
// transient blip).
setInterval(maybeLogStatusSummary, 2000);
maybeLogStatusSummary(); // once immediately, not just after the first check

// Simple heartbeat so you can tell the process is alive even with no fix yet.
// Under fleetSim.js, report through IPC instead of logging directly - a
// whole fleet (20-30 boats routinely) all starting at once otherwise means
// every boat's own copy of this exact message scrolls by independently
// every 10s, drowning out anything useful. fleetSim.js aggregates these into
// one combined line (see its own 'waiting-for-fix' handler). Standalone (no
// parent to aggregate for it) still logs directly, same as always.
setInterval(() => {
  if (lastPvt) return;
  if (typeof process.send === 'function') process.send('waiting-for-fix');
  else console.log('[boatAgent] waiting for first GPS fix...');
}, 10000);

// Handles SIGTERM the same as SIGINT (Ctrl+C), not just SIGINT alone -
// fleetSim.js sends this process SIGINT when stopping the fleet (see its
// own shutdown()), but this boat could also be killed directly - `kill
// <pid>` with no signal named, or a process manager's "stop" - which
// defaults to SIGTERM, not SIGINT. Without a handler for it, Node's default
// action for SIGTERM is an immediate exit that skips this same cleanup.
// Send what is still held for the next slot (fixes gathered since the last send, and anything the scheduler is
// holding) and give the radio a moment to write it before the process exits - otherwise the last second or two of a
// boat's live track (up to a whole correction cycle) goes down with it. The SD log has it either way.
let exiting = false;
function exitAfterFlush(code = 0) {
  if (exiting) return;
  exiting = true;
  try {
    if (pendingBatch.length && !sleeper.isSleeping()) flushPendingBatch({ forSlot: true, final: true });
    if (txScheduler) txScheduler.flushNow();
  } catch (err) {
    console.warn(`[boatAgent] could not send the last fixes before exiting: ${err.message}`);
  }
  if (txScheduler) { const st = txScheduler.stats(); console.log(`[txgate-stats] submitted=${st.submitted} held=${st.held} dropped=${st.dropped} expired=${st.expired} spilled=${st.spilled} queued=${st.queued}`); }
  setTimeout(() => process.exit(code), 400);
}

function shutdown() {
  // Only ever set true above (SIM_HOLD_FOR_START's own TTY handler) -
  // restores the terminal to normal input mode before exiting, so the
  // shell isn't left swallowing keystrokes raw after this process is gone.
  if (process.stdin.isTTY && process.stdin.isRaw) process.stdin.setRawMode(false);
  console.log('\n[boatAgent] shutting down');
  exitAfterFlush(0);
}
process.on('SIGINT', shutdown);
process.on('SIGTERM', shutdown);
