sdale511/race-tracker/(commit log)

2026-07-29 improve sim to not cross start/finish line; increase frequency of redis insert; move finish line cross logic into base;
2026-08-01 change the default radio device;
2026-08-01 passive signal quality logging; pretty print the config;
2026-08-01 fix width of print config;
2026-08-02 interpret the line crossing time and also move to millisecond timestamps on the wire protocol;
2026-08-12 update for the correct UART settings for GPS;
    [config.js]
2026-08-12 add a switch to not log all gps to the console - just the ones past the min distance;
2026-08-12 fix up readme, print-config, and web page so they all say same thing;
    [boatAgent.js, config.js]
2026-08-13 add ability to start survey-in or set fixed gps position;
    [boatAgent.js, config.js]
2026-08-15 default to UBX data frame on UDP networking similator;
2026-08-16 queue all the webhooks so we can throttle nicely;
2026-08-18 add regatta list for base; add inline console log replace for gps fixes;
    [boatAgent.js, config.js]
2026-08-19 remove bad env defaults and switch working directory to jycadmin;
2026-08-23 Use GPS receiver's own UTC time for fix timestamps, not the Pi's clock
    [boatAgent.js]
2026-08-24 Fix boat model orientation being 180 degrees reversed from actual heading
    [boatAgent.js]
2026-08-25 fix delay in ongrid position send;
    [boatAgent.js]
2026-08-25 Unify direct-steering fix for gate and mark crossings, eliminating the recurring reject-and-retry stall
2026-08-25 Fix gate crossing check using committee's north instead of the same gateCenterLocal the boat steers toward
2026-08-25 Split committee mark into committeeStart/committeeFinish; fix stale per-boat watcher state across races
    Start and finish lines can now be run from independent committee positions
    instead of sharing one mark. Also reset finishLineWatchers/onGridWatchers/
    markRoundingWatchers when a new regatta is selected, not just on mark edits -
    previously a reused boat ID carried over its lapCount/prevPos from whatever
    race last used it, occasionally registering a phantom lap moments into a
    fresh test.
    [boatAgent.js, config.js]
2026-08-25 add data flow design doc;
2026-08-26 track start/finish/gap downwind crossings as fouls and post to regattaup; add foul generation mode to sim;
2026-08-26 switch to a reset-course approach vs ever clearing the values;
    [config.js]
2026-08-29 boat ids: alphanumeric + auto-generated per-device fallback, sequential ids for fleet sim; fix boat_id truncation in webhook queue schemas and sd log pruning regex; add disk space cards (base + rover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
    [boatAgent.js, config.js]
2026-08-29 boat ids: alphanumeric wire format + auto-generated per-device fallback, sequential ids for fleet sim; fix boat_id truncation in webhook queues, sd log pruning, and upload filename validation; add di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
2026-08-31 Auto-expire Redis track history and surface write/memory health on the admin dashboard; fix fleetSim not reading the pin-boundary flag before caching the course for spawned boats
    [config.js]
2026-09-01 Grant finished boats a grace pass on the pin boundary while parking, cleared on their next windward rounding
    A boat that just finished has to turn away and sail around the end of
    the start line (crossing the pin boundary's own indefinite downwind
    extension) before it can park behind the line for the next race - that
    was getting reported as a foul. FoulWatcher now grants a short
    FINISH_GRACE_MS pass on that segment right after a legitimate finish
    line crossing, and simGps.js's simulated parking route matches it
    (west past pin instead of east past finish). The grace is cleared
    early the moment the boat rounds the windward mark again, since that
    means it's out sailing another lap or the next ra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
2026-09-01 Make BOAT_ID optional in install-boat-service.sh so an unconfigured Pi auto-generates/persists its own id, same as running npm run boat by hand; when a BOAT_ID is given, zero-pad it to the wire proto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
    Update the static systemd example unit and README to match.
2026-09-01 Add install-base-service.sh (+ base-restart.sh/base-logs.sh/systemd/base-station.service) to run baseStation.js as a systemd service, mirroring install-boat-service.sh.
    REGATTAUP_REGATTA_ID is optional here too - the new pickClosestRegatta fallback (already committed) covers the unset case, so the service never needs to prompt.
2026-09-02 Add a 60s idle-connection keepalive PING to redisStore.js - a managed Redis instance (or the network path to it) silently drops idle TCP connections, surfacing as recurring "read ETIMEDOUT" every 12-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
    Also fix a bug from yesterday's reconnect logging: a deliberate close() was misleadingly logging "connection lost - reconnecting" too.
    [config.js]
2026-09-06 Use a regatta's own venue coordinates (default_lat/default_lon from getActiveRegattas) as the default course center instead of the hardcoded Black Rock Desert fallback
    Persisted alongside the regatta id/name in regatta-id.txt so reset-course, reset-regatta, and a live base station's own course creation all agree; an explicit SIM_CENTER_LAT/SIM_CENTER_LON still always wins, and an out-of-range value falls back safely.
    [config.js]
2026-09-10 Fix xbee_configure_at.py: the previous MM/CH/CD-based config was fabricated by analogy with other XBee product lines and doesn't exist on the actual 900HP/S3B module (verified against Digi's real man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
    [xbee_configure_at.py]
2026-09-12 fix xbee pro S3B setting script to use serial - no AT switch back and forth;
    [boatAgent.js, xbee_configure_at.py]
2026-09-12 add config scripts for radio and uart connect;
2026-09-12 Add a periodic one-line [status] summary to boatAgent.js (GPS fix quality/accuracy/position, course marks age, radio connection, last successful TX age) printed every 60s and once at startup, and con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
    [boatAgent.js]
2026-09-12 Make boatAgent.js's [status] line log immediately on real state transitions (RTK lock gained/lost, radio up/down, first fix/marks/TX ever acquired) instead of only on the 60s heartbeat - checked ever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
    [boatAgent.js]
2026-09-12 Add UPLOAD_LOG (default off) to silence the routine "uploaded"/"received" success log lines in uploadClient.js/uploadServer.js - a boat uploads a chunk every LOG_CHUNK_MINUTES for the whole race, so 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
    [boatAgent.js, config.js]
2026-09-12 Add uploadAge to boatAgent.js's [status] line, reusing roverStats' existing lastUploadAt rather than tracking a duplicate timestamp. First successful upload also counts as a discrete milestone that t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
    [boatAgent.js]
2026-09-13 Add a "Fix" column to the base station's fleet table (carrSoln/gnssFixOk/numSV per boat, color-coded), replacing the less-useful "Bytes sent (session)" column, so RTK status across the whole fleet is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
    [xbee_read_id.py]
2026-09-13 Never transmit or record a lat=0,lon=0 "null island" fix - boatAgent.js refuses to send one over radio (rate-limited warning instead), and baseStation.js refuses to record one even if it somehow arri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
    [boatAgent.js]
2026-09-13 Split RTK correction-source control out of plain "base" mode into a new "basertk" mode (full base + TMODE3/survey-in controls, sharing code via a thin wrapper around baseStation.js). Add role-based f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
    [baseGps.js]
2026-09-14 Silence the repeat "[radio] link quality" log line - only print it when the sync-error count actually changes from what was last reported, instead of every 30s regardless (including endless "0 sync e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
2026-09-14 Default LOG_RECEIVED_FIXES to off - the per-fix "[base] boat=..." console line is noisy enough that it should be opt-in (LOG_RECEIVED_FIXES=1), not opt-out.
    [config.js]
2026-09-15 Add "markset" mode (npm run markset) - a baseStation.js variant with an always-on GPS and a map-only dashboard, for walking the course and setting mark positions. Also add distance-from-start-line to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
2026-09-15 Harden markset mode (disable radio/webhooks/uploads entirely, add Redis+regatta status to its map), fix the survey-in save button gap, and add a km/mi toggle + distances to the course map.
2026-09-16 Mark mode: highlight the assigned mark's row (badge, no Set button) instead of hiding the whole list, and add a terminal prompt (mirroring the existing regatta prompt) when npm run mark starts with n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
2026-09-18 Consolidate all per-device config/state files (boat_id.txt, mark-name.txt, regatta-id.txt, power-schedule.txt, course_marks.json, and the four webhook retry queues) into a single race-config/ directo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
    [boatAgent.js, config.js]
2026-09-18 Nest base's local boat files (received-fix CSV logs, uploaded boat logs) under a per-regatta subdirectory, matching Redis's existing regatta scoping - switching regattas starts fresh local history in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
2026-09-18 Rename race-logs/race-uploads to fleet-logs/fleet-uploads for consistency with the clear-fleet-logs naming, and split the boat's own SD log into a brand new top-level boat-logs/ directory (BOAT_LOG_D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
    [boatAgent.js, config.js]
2026-09-18 Add a "hello" radio frame boats send immediately on radio connect, before any GPS fix exists, so the base's dashboard shows a boat's radio as online right away instead of waiting out a potentially mi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
    [base_station_received_2026-09-18.csv]
2026-09-18 Adds assignedBoatId/assignedAt to mark hashes in Redis, refreshed by real position writes and a 20s heartbeat independent of movement, and surfaces it as live/stale badges in both the Course marks ca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
    [base_station_received_2026-09-18.csv]
2026-09-18 Tighten README.md: replace justification-heavy prose with tables
    Cuts the file from ~2400 to ~1300 lines by converting most long
    explanatory paragraphs into tables/bullets, while keeping every
    command, env var default, file path, and safety gotcha intact.
2026-09-19 Add TX_BATCH_SIZE to pack multiple fixes into one radio send
    New batch frame type (protocol.js) lets a boat pack up to 8 consecutive
    fixes into one transmission instead of one each, for field-testing
    whether reducing transmission count helps airtime/congestion at scale.
    Defaults to 1 (unchanged, byte-identical original behavior); radio-
    congestion now models it too for pre-fleet A/B testing.
    [boatAgent.js, config.js, radioLink.js]
2026-09-19 add jitter to boat hellos and first position frames;
    [boatAgent.js, config.js]
2026-09-19 Detect radio backpressure, not just a closed port, before sending
    send() now checks the serial write buffer's own backpressure signal
    before writing, so a congested (but still open) link fails the same
    way a disconnected one already did - preventing stale fixes from
    queuing ahead of fresher ones under real RF congestion. Also fixes
    TX_BATCH_SIZE/jitter settings missing from print-config/admin /config.
    [boatAgent.js, radioLink.js]
2026-09-19 Give markset/mark mode its own config-page role
    markName/markDistanceM only ever matter on a mark/markset-mode device
    (baseStation.js run with MARK_MODE=1/MARKSET_MODE=1) but were tagged
    'base', so they leaked onto a plain base/basertk's /config page as
    confusing, inert noise. New 'markset' role (unions with 'base' like
    basertk already does) scopes them to where they're actually used.
2026-09-20 tweak all the settings to get max fixes/sec out of radios;
    [config.js, radioLink.js, xbee_configure_at.py]
2026-09-21 Add finish-approach transmit tightening (TX_FINISH_APPROACH_ZONE_M/TX_FINISH_DISTANCE_M)
    [boatAgent.js, config.js]
2026-09-21 Show the boat's own raw GPS fix rate on the rover dashboard's Fix quality card
    [config.js, ubx_config_set.py]
2026-09-22 Fix: base showed "no regatta selected" on offline startup despite a valid regatta-id.txt
    [config.js]
2026-09-23 Repurpose markset/mark modes to run as an ordinary boat with a gated Set button
2026-09-23 Warn on the base's own map before overwriting a mark a live mark-mode rover represents
    Reuses the existing (previously unfed) assignedBoatId/badge mechanism: the Set-Mark radio frame now carries a continuous flag distinguishing mark mode's auto-updates from a one-off markset tap, and mark mode sends a periodic heartbeat so a stationary mark buoy doesn't look stale after 60s.
    [boatAgent.js, config.js]
2026-09-27 Add a rover-triggered "Mark base log" feature for correlating field-test events with rate stats
    New radio frame (0x88, boat->base) carries a short free-text label. The base logs it to console unconditionally and, under LOG_RATE_STATS=1, appends it as its own row in the rate-stats CSV so it lands inline with the fix/error-rate time series at the exact moment it was sent - no more cross-referencing two logs by wall-clock time.
    [boatAgent.js, radioLink.js]
2026-09-29 update docs and set batch default to 4;
    [base_station_rate_stats_2026-09-27.csv]
2026-10-04 Drop arrival time from stored fixes: a fix's time is its GPS timestamp only
    recordFix no longer stores an arrival-time `r` field (it gave all fixes in a batch the same value). Track reads return receivedAt as an alias of the GPS timestamp, including for already-stored fixes. Supersedes the earlier arrival-anchored receivedAt spreading.
2026-10-05 Add base-commanded radio sleep/wake (0x99 power frame) with simulated-radio sleep Rover cycles radio off/listen; base repeats wake frames; dashboard Radio sleep card Document GPIO17 -> XBee SLEEP_RQ 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
2026-10-05 Add GPS sleep for rover sleep mode: UBX-RXM-PMREQ backup, wake on UART RX byte Measure time-to-first-fix after wake; idle shutdown ignores sleeping rovers Document V_BCKP / cold-start findings and se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
    [boatAgent.js, config.js]
2026-10-05 Document GPS backup battery (V_BCKP) check, fitting and acceptance tests in README Link from wiring notes and GPS sleep cold-start section
2026-10-06 Cap regatta name at 25 bytes so the marks frame is 100 bytes, one radio packet Add load-time check that every frame fits the 100-byte radio payload limit Warn once when a regatta name is truncated; u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
2026-10-08 Rover profile: accept RTCM3 input on UART2 explicitly Report: add rover-side checks (RTCM input, DGNSS mode, dynamic model, constellations)
2026-10-08 Recognise RTCM3 frames on the shared radio so they don't read as sync errors Rover counts them (radioRtcm stats), optional RTCM_FORWARD=1 writes them to the GPS Rover profile accepts RTCM input on UA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
    [boatAgent.js, config.js, radioLink.js, rtcm_listen.py, ubx_config_report.py]
2026-10-08 RTCM_LOG=1: one summary line per second per source; RTCM_LOG=2: decoded line per message Add describeRtcm and rtcmLog.js; flag changed message sets and CRC failures; README updated
    [boatAgent.js, config.js, ubx_config_report.py, ubx_config_set.py]
2026-10-09 allow us to adjust the correction rate; Correct the README and rover-profile comment: the 50 ms latency rule is moving-base only
    [analyze_rtcm_log.py, ubx_config_set.py]
2026-10-09 Shared-radio transmit scheduling: burst tracker, transmit gate, optional per-boat time slots (TX_SLOT_MODE) Forward set-mark/mark-log/rtcm events from a real radio to the base; add SIM_RTCM_INTERVAL_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
2026-10-09 docs: add transmit gate and slot scheduler real-radio results to the radio-latency findings PDF Runs D-H: gate 0/300 in conflict window and 0/87 bursts incomplete vs 35% without; slots validated for 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
2026-10-09 Slot table: base assigns each boat a transmit slot (sticky, lowest free) and broadcasts it in a new 0xA7 frame Boats follow their entry (TX_SLOT pins); scheduler setSlot; env TX_SLOT_TABLE_S/TX_SLOT_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
2026-10-09 Slot table: base assigns each boat a transmit slot (sticky) and broadcasts it in a new 0xA7 frame; boats follow it Slot count is sized once at startup from RTCM_INTERVAL_S (22 at 1 s, 47 at 2 s, 40 m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
2026-10-09 Slot table: base assigns each boat a transmit slot (sticky) and broadcasts it in a new 0xA7 frame; boats follow it Slot count sized once from RTCM_INTERVAL_S (unless TX_SLOT_COUNT set); Slot column i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
2026-10-09 Slot table: base assigns each boat a transmit slot (sticky, spread out: 0, halfway, quarters...) in a new 0xA7 frame; boats follow it Slot count sized once from RTCM_INTERVAL_S (unless TX_SLOT_COUNT 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
2026-10-10 Slot table: base assigns each boat a transmit slot (sticky, spread out) in a new 0xA7 frame; boats follow it and send in their slot Slot-aligned flush with TX_SLOT_MAX_HZ cap (default 4 = one 84-byte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
2026-10-10 Slot table: base assigns each boat a transmit slot (sticky, spread out) in a new 0xA7 frame; boats follow it and send in their slot Slot-aligned flush with TX_SLOT_MAX_HZ cap; scheduler won't start a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
2026-10-10 Slot table: base assigns each boat a transmit slot (sticky, spread out) in a new 0xA7 frame; boats follow it and send in their slot Slot-aligned flush with TX_SLOT_MAX_HZ cap; no late starts in a slo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
2026-10-10 Slot table: base assigns each boat a transmit slot (sticky, spread out) in a new 0xA7 frame; boats follow it and send in their slot Slot mode on by default (TX_SLOT_MODE=0 to disable); slot-aligned f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
2026-10-10 Slot table: base assigns each boat a transmit slot (sticky, spread out) in a new 0xA7 frame; boats follow it and send in their slot Slot mode and simulated RTCM bursts on by default; slot-aligned flu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
2026-10-10 Slot table: base assigns slots (sticky, spread out) to actively reporting boats via a new 0xA7 frame; boats follow it and send in their slot Idle boats' heartbeats neither earn nor keep a slot (TX_SL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
2026-10-10 Slot table: base assigns slots (sticky, spread out) to actively reporting boats via a new 0xA7 frame; boats follow it and send in their slot Idle heartbeats neither earn nor keep a slot; a boat that 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
2026-10-10 Slot table: base assigns slots (sticky, spread out) to actively reporting boats via a new 0xA7 frame; boats follow it and send in their slot Join slots, slot on first moving fix, "Prepare race start"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
    [boatAgent.js, config.js]
2026-10-10 Delta-coded batch frame (0xE7): up to 8 fixes in 83 bytes (first fix full, rest 8 bytes each); TX_DELTA, TX_SLOT_MAX_HZ default 8 Slot table with join slots, first-moving-fix assignment, Prepare race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
    [boatAgent.js, config.js, radioLink.js]
2026-10-10 README: radio frame reference - table of all frame types plus byte layouts for the slot table (0xA7) and delta batch (0xE7) frames
2026-10-10 Base gets its own transmit slot after the boats' slots for the slot table, marks, pings and sleep/wake frames Auto slot count leaves room for it (26 total at 1 s: 23 boats + 2 join + base); TX_SLOT_C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
2026-10-10 print-config: give SIM_COURSE_MARKS its own row instead of folding it into the course length label
2026-10-10 Parked state: boats in the on-grid zone take no slot, drop to the join slots and report every ~15 s until they leave the zone TX_PARKED_REPORT_S, TX_SLOT_UNPARK_FIXES; "parked" in the dashboard Slot 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
2026-10-10 TX_BATCH_SIZE defaults to 8 (delta frames; 4 with TX_DELTA=0); radio-congestion sends delta frames README and config report updated
2026-10-10 README: TDMA slot diagrams (one 1 s cycle with the reserved slots labelled; 1 s vs 2 s interval at the same scale) as docs/tdma-*.svg
2026-10-10 README: clearer description of the mark log (0x88) frame in the frame reference table
2026-10-10 README: shorten the mark log (0x88) row in the frame reference table
2026-10-11 Slots only for boats that started from the grid (crossed the line), freed when a boat stops (45 s), racing boats preempt others Join-slot back-off (TX_JOIN_REPORT_S), boats drop to the join slots whe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
2026-10-11 Delta frames: heading in 2° steps (any turn fits), speed in 0.5 kn steps; only GPS jumps, gaps and >63 kn steps split a frame Add TX_SLOT_RESERVE_FRAMES (default 1) to keep slot room for split frames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
2026-10-11 Near a windward/leeward mark (TX_SLOT_MARK_ZONE_M, 80 m) use the whole slot and thin those fixes last, so no rounding is missed 30-boat sim, 35 ms/2 s: fixes within 50 m of a mark delivered 51% -> 10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
2026-10-11 Defaults: RTCM interval 2 s (RTCM_INTERVAL_S, SIM_RTCM_INTERVAL_S, ubx_config_set.py --rtcm-interval) and TX_SLOT_MS 45 42 slots (39 boats) and 8 Hz average per boat at 2 s; README and config comment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
2026-10-11 Backfill: a boat waiting for its slot keeps the last 15 s of fixes and sends them (thinned to 500 ms) in its first slot cycle 30-boat sim at 2 s: mid-race gaps over 1.5 s 3-8 -> 0-1 per run; README d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
2026-10-11 Backfill: a boat waiting for its slot keeps the last 15 s of fixes and sends them (thinned to 500 ms) in its first slot cycle README: 45 ms/2 s defaults, stored fix format, how to read tracks live, k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
2026-10-11 Redis track members carry the fix time (t) so identical fixes (held position, repeated sim path) no longer overwrite each other Fixes ~1.5 s hole per boat at the line crossing; tests + README
2026-10-11 Boat dashboard: add RTK corrections card (GPS-applied count, last message age/type, CRC failures, radio-received count) Headline shows receiving / stalled / none yet so a stopped correction stream is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
2026-10-12 ubx_config_set.py base role: set CFG-RATE-MEAS to 1000 ms so the RTCM interval (counted in epochs) is really seconds Fixes 10x correction airtime after the rover profile (10 Hz) was applied to a base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
2026-10-12 Simulated GPS defaults to 10 Hz (the real rover profile's rate) so a simulated boat exercises the same radio path as a real one README table and examples updated; SIM_GPS_HZ=2 gives the old lighter r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
2026-10-12 Slot mode: raise the pending-fix fail-safe to 200 so the cap applies at 10 Hz; log what the first slot cycle thinned the backlog to Slot-too-small warning only after repeated spills, with real number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
2026-10-12 Boat dashboard: Transmit slot card - slot, correction interval, frames sent in slot, spilled, expired/dropped, waiting now README explains what each means and where an actual overrun would show inste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
2026-10-12 Boat assumes the base's computed slot count (autoSlotCount, shared with the base) until it hears a table, not a fixed 25 Its shared slots are then the real join slots (39, 40 of 41) instead of assign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
2026-10-12 Boat dashboard Transmit slot card: shorter headline and rows (Slots, Table) so nothing wraps
2026-10-12 Slot table: still broadcast (empty) when nobody holds a slot, so boats on a quiet base learn the slot count, width and join slots Boat dashboard Transmit slot card: shorter text; test for the empty t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
2026-10-12 Practice mode: any moving boat gets a slot, no start-grid parking or "must have started" rule; boats follow the flag in the slot table Switch in the base dashboard's Fleet controls (no restart), save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
2026-10-12 Base admin: Transmit slots card - slots in use, slot map, mode, layout, cycle usage, assigned/free/racing/parked/waiting, table version and age
2026-10-12 README: slot diagrams and bench-test example now use the 2 s / 45 ms defaults; docs/make-tdma-svgs.js draws them from the real slot-count code
2026-10-14 Base admin: shared tab bar (Regatta & boats, Radio, GPS & system, Data, Map, Console) on the dashboard, map and console pages Regatta select and a small mode card in the header; compact slot map on h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
2026-10-14 Boat: the distance/heartbeat gate now measures from the last fix that cleared it (src/distanceGate.js), so a slot wait no longer sends clusters of near-identical fixes Base: received-fix log says pos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
2026-10-15 Boat dashboard: Slot table card showing the table the boat is following, with its own slot highlighted Shared slot-map renderer (dashboardFormat.js) now used by the base and boat cards; SlotTableFoll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
2026-10-15 Base admin: Ping fleet button on the compact Transmit slots card on the home page
2026-10-15 RF test mode: npm run fleet-rf runs N simulated boats behind one real radio (fleetSim.js RF_BRIDGE), each boat with its own id and slot, FLEET_ID_START for a second radio IpcRadioLink for the boats, 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
2026-10-15 Base slot: a newer marks/ping frame replaces the one still waiting and a newer slot table replaces an older table's frames (TxScheduler supersede option), so a flood of new boats queues one of each
2026-10-15 Boat: a parked boat repeats its first report once about 6 s later (TX_PARKED_REPEAT_S), so one lost in the join slots is not lost for a whole 60 s heartbeat ParkedReporter repeat, gate bypass for the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
2026-10-15 Boat: a parked boat repeats its first report once about 10 s later (TX_PARKED_REPEAT_S), after the fleet's first wave has settled, so a report lost in the join slots is not lost for a whole 60 s hear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
2026-10-15 Boat: a parked or slotless boat keeps its newest fix when its report is not due yet (it was discarded, and the distance gate gave no replacement for a minute, so the first report on the grid was lost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
2026-10-16 Boat: a frame the scheduler drops no longer counts as reported by the distance gate (onSent/onDropped on TxScheduler), so a stationary boat recovers on its next fix eventBoost.js replaces finishBoost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
2026-10-16 README: a boat inside the on-grid zone is never given a new slot, parked yet or not
2026-10-16 Base admin: "Clear stats" button on the radio frames card (resets frame and sync-error totals and the bandwidth graph); the frames card now sits to the right of the bandwidth card README: admin pages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
2026-10-16 Redis: each boat's own track key keeps only the last 2 min (REDIS_BOAT_TRACK_MINUTES), since only RegattaUp's lastPositions reads it; Redis memory card moved to the Data page Admin: webhook retry que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
2026-10-16 xbee_configure_at.py: write the new baud to flash (WR) and leave command mode (CN) before reconnecting at it, so BD survives a power cycle when the radio only switches speed after command mode ends
2026-10-17 Redis: rolling 48 h window for the track keys (trim all:track to the retention period and refresh both keys' expiry once a minute), so the key no longer vanishes, race in progress included, 48 h afte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
2026-10-17 Redis: rolling 48 h window for the track keys (all:track trimmed and expiry refreshed once a minute; each boat's key every 10 s) so a key never vanishes mid-race; drop the per-fix EXPIRE calls (3 com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
2026-10-17 Base admin: Witty Pi power schedule card (always / daily hours / sunrise to sunset) sent to the boats over the radio (new 0xB5 frame, repeated every 60 s); boats write schedule.wpi and enable it only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
2026-10-17 Fleet power schedule from the base admin: Witty Pi power schedule and Boat shutdown cards (Save, Enable/Disable) sent to the boats in one 0xB5 power schedule frame; boats apply each part only when it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
2026-10-17 Base admin: Witty Pi power schedule and Boat shutdown cards get an Enabled checkbox in the upper right (Update while enabled) in place of Save/Enable/Disable buttons and help text; boat cards trimmed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
2026-10-18 Power schedule review: one apply at a time on a boat, sudo fallback when clearing the board, rebroadcast never faster than 5 s, simulated boats ignore the fleet schedule (ACCEPT_POWER_SCHEDULE=1 to t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
2026-10-18 Boat shutdown: new "shut down at once / wait until the boat has stopped" choice (idle gate on or off, in the power schedule frame and the boat's shutdown engine); Witty Pi card defaults to waiting fo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
2026-10-18 Boat: logs the arrival of each new power schedule (once per version, with the Witty Pi and shutdown settings and which radio) before the apply outcome; repeats stay silent
2026-10-18 Boat: every new power schedule version is logged on arrival, including on a simulated boat that ignores it; version stamps always rise, so same-second changes are separate versions
2026-10-18 Boat and fleet terminals: Return prints a blank timestamped line while waiting for SPACE (raw mode showed nothing), as a log marker
2026-10-18 Terminal: Return while waiting for SPACE prints a plain blank line; an empty console.log() is no longer given a timestamp
2026-10-21 Redis: boats:known is added on a boat's first fix and every 10 s after, not on every fix (3 to 2 commands per fix) Per-boat upkeep timer is per track key, so a regatta switch lists the boat in the ne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
2026-10-21 Redis: each tick's fixes are written as one ZADD per key (a full frame is 2 commands, not 16; ~50 writes/s for 25 boats) Upkeep runs once per boat per batch; a failed batch counts once and re-posts e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
2026-10-22 Config: "Running mode" gets its own section ahead of "Available modes" in print-config and /config
2026-10-22 Config: 'mark' role so mark settings show only on mark rovers; print-config labels rows with their modes and takes --mode README: fix stale script/section refs, add regatta selection, map mark-settin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
2026-10-24 Redis: the regatta track key is regattas:<id>:track (was all:track); getAllTrack -> getTrack clearBoatData also deletes the old name; clean-bad-fixes, README, pipeline doc and tests updated
2026-10-24 Redis: clearBoatData no longer deletes the old all:track and per-boat key names; README notes both are gone
2026-10-24 Base: record wind from a Tempest weather station's local UDP broadcast into regattas:<id>:wind (one sample a minute, mph) Dashboard card on the radio page, TEMPEST_* settings, tests and README
2026-10-24 Tempest: every 3-second wind sample gets a gust and lull - the highest/lowest 3-second speed over the last minute Card shows gust and lull with each reading
2026-10-24 Base: embeddable wind widget at /wind (compass arrow downwind, mph, from-direction, gust/lull; ?theme=light) GET /api/wind returns the newest sample for any origin; tests and README
2026-10-24 Wind widget updates live: base pushes each Tempest sample over /api/wind/stream (Server-Sent Events) Widget falls back to polling /api/wind if the stream can't be used; test for the stream
2026-10-24 Wind widget: arrow points to where the wind comes from; compact one-line pill for frames ≤70 px tall or ?size=compact
2026-10-24 Wind widget: all text full white (black on light), lull – gust range without labels and larger, blue compass ring
2026-10-24 Wind widget: lull–gust range under the mph; 10-minute direction swing as a band on the compass and "205° – 245°" under the direction Base computes the swing (smallest arc of the last 10 minutes' dire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
2026-10-24 Wind widget: saturated LED-friendly blue (#0088ff) for the arrow and compass ring
2026-10-25 Rovers: default TX_SLOT_MAX_HZ 4 (was 8) on the legs; marks and finish line keep full rate TX_SLOT_MAX_HZ and TX_SLOT_MARK_ZONE_M on the config pages; README updated
2026-10-25 Track size cap: REDIS_TRACK_MAX_MB (300) drops the oldest fixes once the track is over it, measured by MEMORY USAGE Replaces the practice-mode time window, so a boat or two sailing all day keep every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
2026-10-25 Rovers: the finish line's full-rate zone only counts a boat heading upwind; downwind boats passing it stay at 4 Hz headingUpwind in finishApproach.js (same upwind convention as the lap detector), wit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
2026-10-26 setup-pi.sh: one re-runnable Pi setup in sections (update node repo deps uart wifi service verify run), with a read-only verify WiFi: set-wifi.sh skips unchanged networks, replaces without a gap and 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
2026-10-26 setup-pi.sh: UART setup moved into its uart section; setup-gps-uart.sh removed uart syncs the boot config before asking for a reboot; --help prints the whole header; README updated
2026-10-26 Version: package.json major.minor + commit count (v0.1.288), bumped by every commit with nothing to edit Shown as a badge on the base and rover admin headers (amber with local changes), on config/pri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
2026-10-26 Service scripts: MODE optional, defaults to the one installed service; shared mode->unit mapping in service-mode.sh Admin headers show the hostname next to the version; host row on config/print-confi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
2026-10-28 Status hello: rovers send their own diagnosis (GPS link stage, satellites, corrections, one-way radio, power, build) before the first fix and whenever a problem starts, lasts or clears; base logs it 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
2026-10-28 Add read-only base viewer (npm run viewer) with UDP base discovery
    Serves the base's fleet page with all controls removed, fed by polling /api/stats. With no address it finds the base by UDP broadcast probe (port 8093); base stats now include host and version.
2026-10-28 Recalculate the on-grid zone when start marks change outside the base
    Base re-reads marks from Redis every 10 s (MARKS_SYNC_INTERVAL_MS) and applies RegattaUp edits: rebuilds watchers, rebroadcasts, and republishes the zone when committeeStart/pin moved. A stale zone is also corrected at startup.
2026-11-02 Add ESP32-S3 rover firmware (racing core) with Node-generated test vectors C++ port of the rover's GPS, radio protocol, slot scheduling, hello and sleep in firmware/esp32-rover; npm test now fails if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
2026-11-02 Port parking, event boost, power schedule (deep sleep + motion wake), XBee NI and TFT screen to the ESP32 rover Course watchers and the shutdown gate/sun times are checked against Node-generated vect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
2026-11-03 Mac rover uses the Node rover's boat id (BOAT_ID, else race-config/boat_id.txt) so both are the same boat Accept Node's id alphabet (A-Z, 0-9) on the Mac and ESP32, shared as protocol::validBoatId
2026-11-03 C++ rover reads the Node rover's settings by name: env vars on the Mac, a serial console saved in NVS on the ESP32 All 39 checked against config.js by generated vectors; the console also sets the boa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
2026-11-03 Reverse TFT: D0 shows a large page - the boat id, the battery % and one status word (NO FIX, NO MARKS, READY...) D1 goes back to the full status; text wrap off so the full page's last character no lo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
2026-11-03 Reverse TFT: D0 shows a large page - the boat id (coloured by readiness), the battery % and one status word (NO FIX, NO MARKS, READY...) D1 goes back to the full status; text wrap off so the last cha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
2026-11-04 ESP32 console echoes what you type and takes Backspace, so pio device monitor works without --echo README: no --echo needed; tap RESET first if the boat is asleep
2026-11-04 ubx_config_set.py checks flash as well as RAM: a value that only reached RAM (lost at the next power cycle) now fails A setting that's running but unsaved is written again instead of being reported u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
2026-11-05 XBee left in the ArduSimple's socket: ubx_config_set.py --uart2 off frees its DIN line, and the new feather_s3_reversetft_socket build (RTCM_FORWARD=1) transmits through it and forwards RTCM over UAR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
2026-11-05 docs/esp32-rover-wiring.pdf: add an all-connections diagram as page 1 (ArduSimple with XBee in socket, Feather, LiPo, S9V11F5, LIS3DH)
2026-11-05 ESP32 rover README and main.cpp wiring notes: XBee in the ArduSimple's socket, ZED UART2 off (--role rover), RTCM_FORWARD socket build, power wiring with the S9V11F5; the breakout kept as the alterna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
2026-11-06 docs/esp32-rover-harness.pdf: quote request for the rover wiring harness (Feather, ArduSimple, LIS3DH, S9V11F5 connectors, 13-wire list, build rules) and the SMA / RP-SMA antenna pigtails
2026-11-06 hardware/esp32-rover-carrier rev B: Feather moved to the right end (nothing over its display), bq24074 USB-C to the front, 146.5 mm wide; adds GPS_EN pad, TIMEPULSE, EXTINT, bq ~CE, LIS3DH INT2 and a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
2026-11-06 hardware/esp32-rover-carrier: OPTIONAL-CONNECTIONS.md, marked optional and unused by the current firmware: what the GPS power cut, TIMEPULSE, EXTINT, charger enable, LIS3DH INT2 and Feather EN header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
2026-11-06 hardware/esp32-rover-carrier: Feather on 8.5 mm stacking headers into J5/J6 (all modules on female sockets); silkscreen, schematic note, BOM and README assembly steps updated; fab files re-exported
2026-11-06 Rover battery in the base admin: ESP32 rovers send a battery hello (0x9E, MAX17048 % and volts) at least every 5 min; the base shows it in the fleet table's Battery column, flags it under 20 %/10 %, 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
2026-11-06 esp32-rover: D2 button shows a firmware version page (version number, commit and date, + local changes); README screen section updated
2026-11-07 docs/esp32-rover-wiring.pdf: draw the S9V11F5 GND wire, optional EN on A0 / GPIO 18 (as on the carrier), LIS3DH power note; HTML source added as docs/esp32-rover-wiring.html
2026-11-07 hardware/esp32-rover-carrier rev C: drop H16 (lid-screw boss goes there), fab re-exported and checked; hardware/esp32-rover-enclosure: printable case built from layout.py, clash-checked against ArduS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
2026-11-07 hardware/esp32-rover-enclosure: case models from each module's own STEP (ArduSimple, Adafruit 5691/4755/2809, Pololu S9V11F5), charger USB-C opening fixed (was mirrored), source CAD in cad/; S9V11F5 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
2026-11-07 hardware/esp32-rover-carrier: JLCPCB assembly files for the connectors (fab/jlcpcb bom.csv + cpl.csv, in-stock LCSC parts) from tools/gen_jlc.py; README ordering steps, board size 134 mm
